lazbaphilipp/ADS_HW/README.md

# MIET RTD and PCB design homework project
 special thanks to [dee3mon](https://github.com/dee3mon) and [murenkov](https://github.com/murenkov)
