lazbaphilipp/ADS_HW/images/Altium-Components/not used/LNA_Schematic_View.pdf

NC 1

RFIN 7

GND 8

NC | 3
NC | 5

GND 14

NC | 13 GND 6
NC | 12

GND 16

RFOUT | 15
NC | 11

VE 4

NC 10

VDD 2

NC 9 GND 17

DA?

PMA-183PLN+
