lazbaphilipp/ADS_HW/images/Altium-Components/not used/PD_Schematic_View.pdf

GND

7

Vcc

1

OUT

2 RFin

6

FLTR

3

EN

8

GND

4 GND

5

GND

9

DA?

LTC5597
