lazbaphilipp/ADS_HW/images/Altium-Components/not used/PM_Schematic_View.pdf

OUT

1

SENSE

2

GND

6

SHDN

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
LT1763-
