lazbaphilipp/ADS_HW/images/Altium-Components/not used/Atmega/MC_Schematic_View.pdf

VCC | 3 GND 4
AVCC | 16
AREF | 17 GND 18

PC[6] ( RESET/PCINT14) 25

PD[0] (RXD/PCINT16) 26

PD[1] (TXD/PCINT17) 27

PD[3] (PCINT19/OC2B/INT1) 1

PD[2] (INT0/PCINT18) 28

PD[4] (PCINT20/XCK/T0) 2

PD[5] (PCINT21/OC0B/T1) 7

PD[6] (PCINT22/OC0A/AIN0) 8

PD[7] (PCINT23/AIN1) 9

(PCINT0/CLKO/ICP1) PB[0] | 10
(PCINT1/OC1A) PB[1] | 11
(PCINT2/SS/OC1B) PB[2] | 12
(PCINT3/OC2A/MOSI) PB[3] | 13
(PCINT6/XTAL1/TOSC1) PB[6] | 5
(PCINT7/XTAL2/TOSC2) PB[7] | 6
(PCINT4/MISO) PB[4] | 14
(SCK/PCINT5) PB[5] | 15

DD?A

PC[1] (ADC1/PCINT9) 20

PC[2] (ADC2/PCINT10) 21

PC[3] (ADC3/PCINT11) 22

PC[4] (ADC4/SDA/PCINT12) 23

PC[5] ADC5/SCL/PCINT13) 24

PC[0] (ADC0/PCINT8) 19

DD?B
