lazbaphilipp/ADS_HW/include/coursework/applications.tex

\includepdf[pages=-, fitpaper,addtotoc={1,chapter,0,Приложение А. МПСУ.464342.21-005СБ ,chap:appA}]{images/Documentation/MPSU.464342.21-005SB.pdf}

\includepdf[pages=-, fitpaper,addtotoc={1,chapter,0,Приложение Б. МПСУ.687254.21-005СБ ,chap:appB}]{images/Documentation/MPSU.687254.21-005SB.pdf}

\includepdf[pages=-, fitpaper,addtotoc={1,chapter,0,Приложение В. МПСУ.687254.21-005Д1 ,chap:appC}]{images/Documentation/MPSU.687254.21-005D1.pdf}

\includepdf[pages=-, fitpaper,addtotoc={1,chapter,0,Приложение Г. МПСУ.464342.21-005ЭЗ ,chap:appD}]{images/Documentation/MPSU.464342.21-005E3.pdf}

\includepdf[pages=-, fitpaper]{images/Documentation/MPSU.464342.21-005E3_2.pdf}

\includepdf[pages=-, fitpaper,addtotoc={1,chapter,0,Приложение Д. МПСУ.464342.21-005ПЭ3 ,chap:appE}]{images/Documentation/MPSU.464342.21-005PE3.pdf}

\includepdf[pages=-, fitpaper,addtotoc={1,chapter,0,Приложение Е. МПСУ.464342.21-005ВП ,chap:appF}]{images/Documentation/MPSU.464342.21-005VP.pdf}

\includepdf[pages=-, fitpaper,addtotoc={1,chapter,0,Приложение Ж. МПСУ.464342.21-005 ,chap:appG}]{images/Documentation/MPSU.464342.21-005.pdf}

\includepdf[pages=-, fitpaper,addtotoc={1,chapter,0,Приложение З. МПСУ.687254.21-005 ,chap:appH}]{images/Documentation/MPSU.687254.21-005.pdf}

\includepdf[pages=-, fitpaper,addtotoc={1,chapter,0,Приложение И. МПСУ.30117.21-005Р ,chap:appI}]{images/Documentation/MPSU.30117.21-005R.pdf}
