lazbaphilipp/ADS_HW/include/coursework/system_modeling.tex

\chapter{Системное моделирование} \label{chap:system_modeling}

Пользуясь спроектированными ранее элементами составим общую схему приёмной
ячейки по примеру структурной схемы из технического задания (Рис.\ref{fig:SystemSch})

\begin{figure}[H]
	\centering
	
	\caption{Схема проектируемой приёмной ячейки}%
	\label{fig:SystemSch}
\end{figure}

\begin{figure}[H]
	\centering
	
	\caption{Результаты моделирования}%
	\label{fig:SystemResponse}
\end{figure}

\begin{figure}[H]
	\centering
	
	\caption{Шумовые характеристики}%
	\label{fig:SystemNF}
\end{figure}

Данная модель соответствует выданному ТЗ и может быть отправлена на следующий 
этап проектирования.
