lazbaphilipp/ADS_HW/include/coursework/title.tex

\thispagestyle{empty}
\setcounter{page}{0}

\begin{center}
    Министерство науки  и высшего образования Российской Федерации

    \vspace{1ex}

    Федеральное государственное автономное образовательное учреждение высшего образования

    \textbf{НАЦИОНАЛЬНЫЙ ИССЛЕДОВАТЕЛЬСКИЙ УНИВЕРСИТЕТ <<МОСКОВСКИЙ ИНСТИТУТ ЭЛЕКТРОННОЙ ТЕХНИКИ>>}

    \vspace{1ex}

    Институт микроприборов и систем управления имени Л.Н. Преснухина
\end{center}

\vspace{13ex}

\begin{center}
    \textbf{К\,У\,Р\,С\,О\,В\,А\,Я\,\, Р\,А\,Б\,О\,Т\,А}
    \vspace{1ex}

    по курсам

    \textbf{\textit{<<Приёмо-передающие устройства>>}}
    
    \textbf{\textit{<<Проектироание печатных плат>>}}
    
    Вариант 5.6
    
    \textit{Приемная ячейка усиления и фильтрации с детектированием мощности}

\end{center}

\vspace{20ex}

\begin{flushright}
    \noindent
    Выполнил: \textit{Лазба Филипп Борисович} \\
    \textit{студент группы РТ-43} \\
    Руководитель: \textit{Приходько Дмитрий Владимирович}
\end{flushright}

\vfill

\begin{center}
    Москва

    2021
\end{center}

\newpage
