lazbaphilipp/ADS_HW/images/Altium-Mechanical/BoardCase.pdf

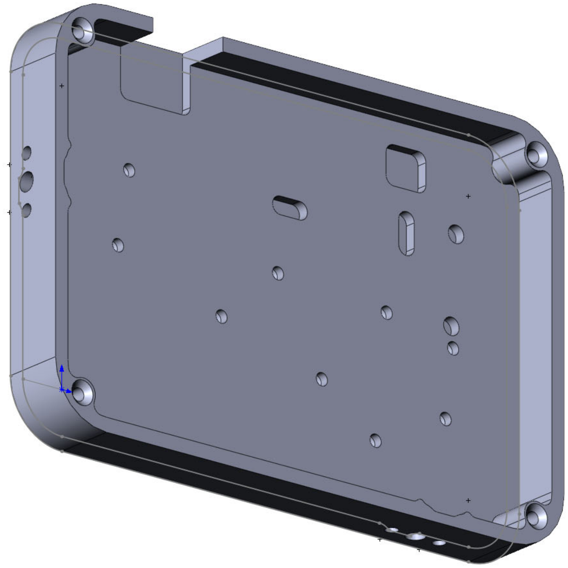
[picture p1: page 1]
