lazbaphilipp/ADS_HW/images/Altium-Mechanical/BoardCup.pdf

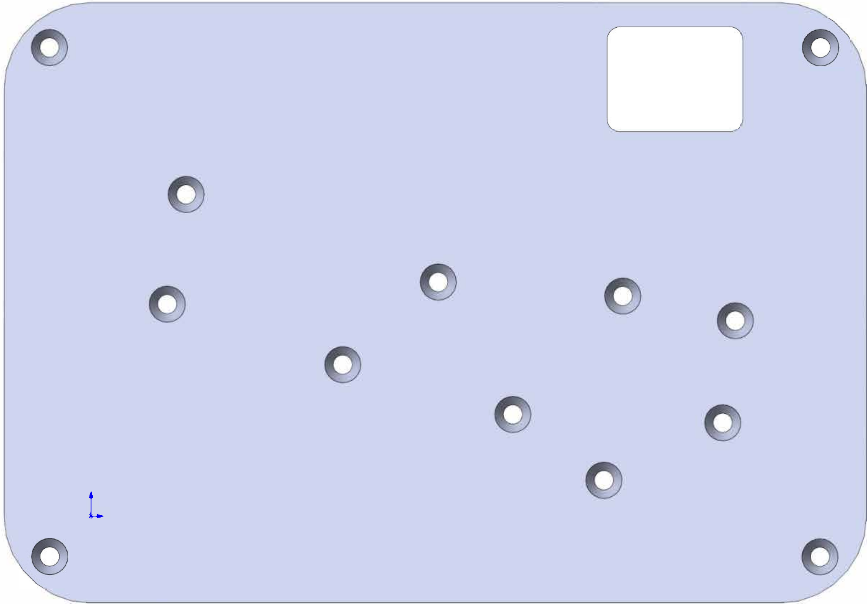
[picture p2: page 1]

L
