lazbaphilipp/ADS_HW/images/Altium-Mechanical/CellsCutout.pdf

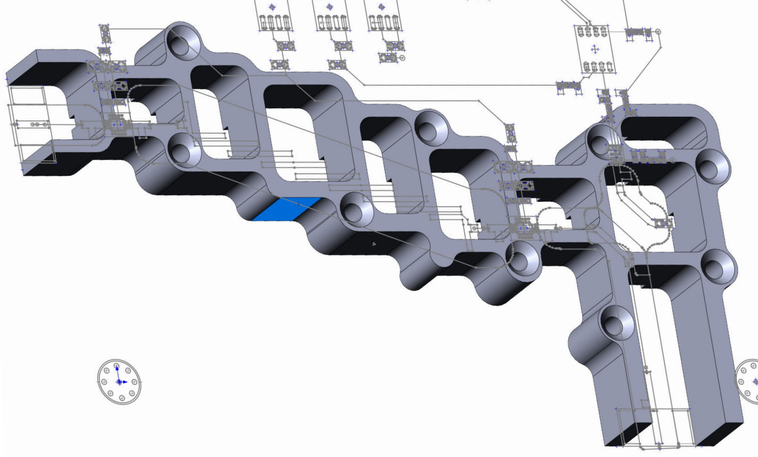
[picture p3: page 1]
