lazbaphilipp/ADS_HW/images/Altium-Mechanical/ShieldedBoardRelease.pdf

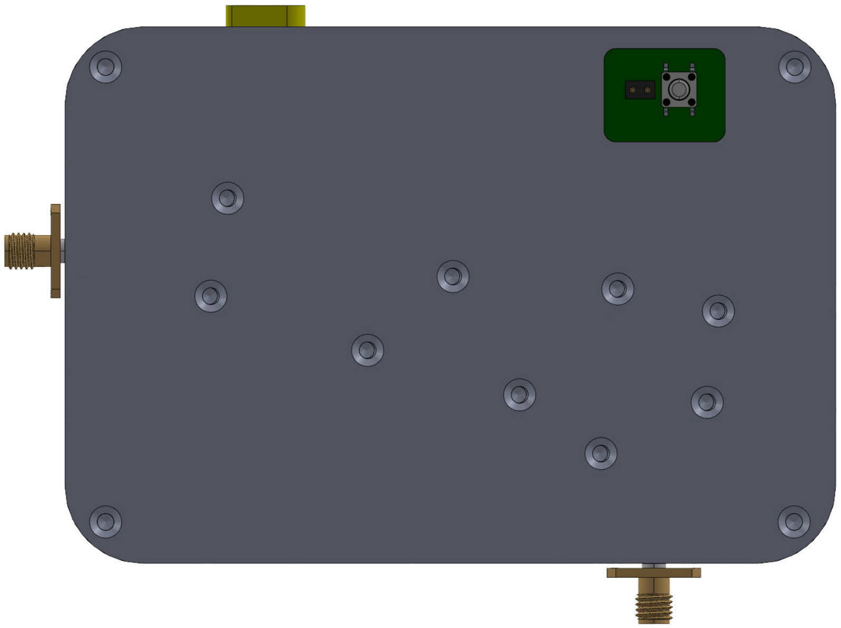
[picture p4: page 1]
