lazbaphilipp/ADS_HW/images/Altium-PCB/4LayerPWRL.pdf

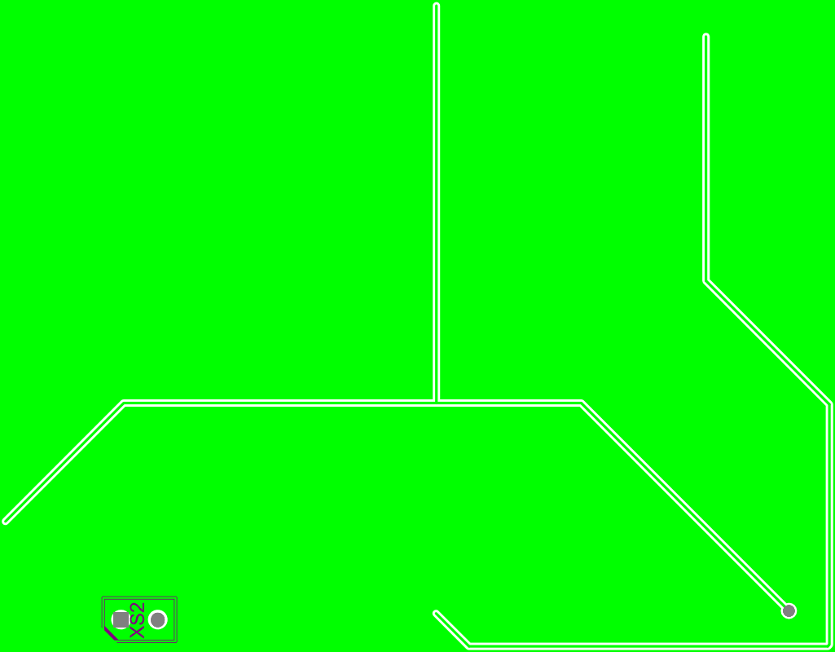
[picture p5: figure]
