lazbaphilipp/ADS_HW/images/Documentation/MPSU.464342.21-005PP.pdf

Формат
Кол.

А4,

Подп. Дата

Взам. инв. №Инв. № дуб Подп. и дата

Примечание

Перв. примен.

Зона
Поз.
Обозначение | Наименование

1

Справ. №

3 | МПСУ.464342.21-005Д1 | Данные проектирования
| МПСУ.464342.21-005Т5М | Данные конструирования
4
5
6 | | Материалы
7
8 | | Rogers RO4350B 0.508мм
9 | | (фольга 0.18мм)
10
11

МПСУ.464342.21-005СБ
2

12

№ докум.

| | | | МПСУ.464342.21-001
| | Разраб. | Лазба | | и фильтрации с детектированием мощности | Лит. | Лист 1 Приемная ячейка усиления | Листов
Пров. | Приходько | | | | | | | 2
ЗамДир | Лялин
Н. контр
Утв.

Изм.Лист

Подп. и дата Инв. № подл

Документация

Сборочный чертеж

Копировал | Формат А4
