lazbaphilipp/ADS_HW/images/system_modeling/SystemNF.pdf

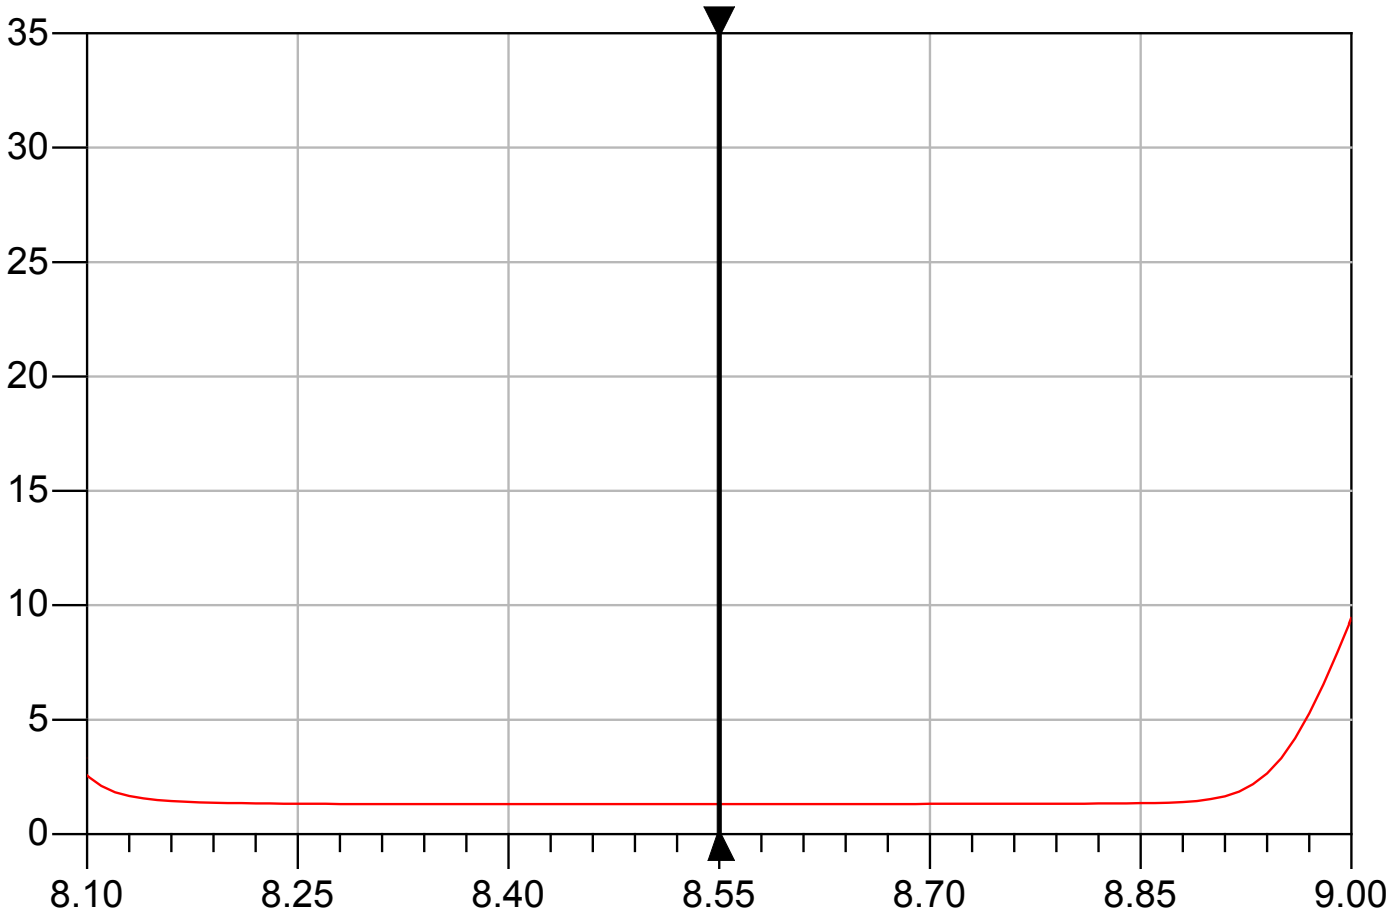
[picture p6: figure]

### freq, GHz

### NFmin

m4

m4

## freq= NFmin=1.312

## 8.550GHz
