lazbaphilipp/ADS_HW/Project/Components/Power Detector/MC ATmega328 (nu)/pinout.xlsx

PinDes | PinName | Type | Bank
1 | PD[3] (PCINT19/OC2B/INT1) | I/O | Bank=PD | V
2 | PD[4] (PCINT20/XCK/T0) | I/O | Bank=PD | C
3 | VCC |  | Bank= | F
4 | GND |  | Bank= | D
5 | PB[6] (PCINT6/XTAL1/TOSC1) | I/O | Bank=PB
6 | PB[7] (PCINT7/XTAL2/TOSC2) | I/O | Bank=PB
7 | PD[5] (PCINT21/OC0B/T1) | I/O | Bank=PD
8 | PD[6] (PCINT22/OC0A/AIN0) | I/O | Bank=PD
9 | PD[7] (PCINT23/AIN1) | I/O | Bank=PD
10 | PB[0] (PCINT0/CLKO/ICP1) | I/O | Bank=PB
11 | PB[1] (PCINT1/OC1A) | I/O | Bank=PB
12 | PB[2] (PCINT2/SS/OC1B) | I/O | Bank=PB
13 | PB[3] (PCINT3/OC2A/MOSI) | I/O | Bank=PB
14 | PB[4] (PCINT4/MISO) | I/O | Bank=PB
15 | PB[5] (SCK/PCINT5) | I/O | Bank=PB
16 | AVCC |  | Bank=
17 | AREF |  | Bank=
18 | GND |  | Bank=
19 | PC[0] (ADC0/PCINT8) | I/O | Bank=PC
20 | PC[1] (ADC1/PCINT9) | I/O | Bank=PC
21 | PC[2] (ADC2/PCINT10) | I/O | Bank=PC
22 | PC[3] (ADC3/PCINT11) | I/O | Bank=PC
23 | PC[4] (ADC4/SDA/PCINT12) | I/O | Bank=PC
24 | PC[5] ADC5/SCL/PCINT13) | I/O | Bank=PC
25 | PC[6] ( R\E\S\E\T\/PCINT14) | I/O | Bank=PC
26 | PD[0] (RXD/PCINT16) | I/O | Bank=PD
27 | PD[1] (TXD/PCINT17) | I/O | Bank=PD
28 | PD[2] (INT0/PCINT18) | I/O | Bank=PD
