lazbaphilipp/ADS_HW/images/Altium-Draftsman/CAMtastic.png

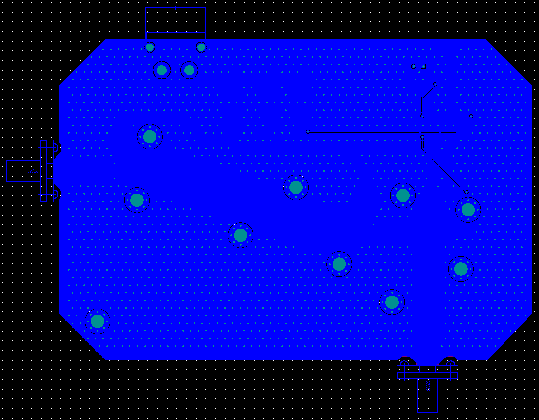
images/Altium-Draftsman/CAMtastic.png
