lazbaphilipp/ADS_HW/images/Altium-Mechanical/BoardNoCup.png

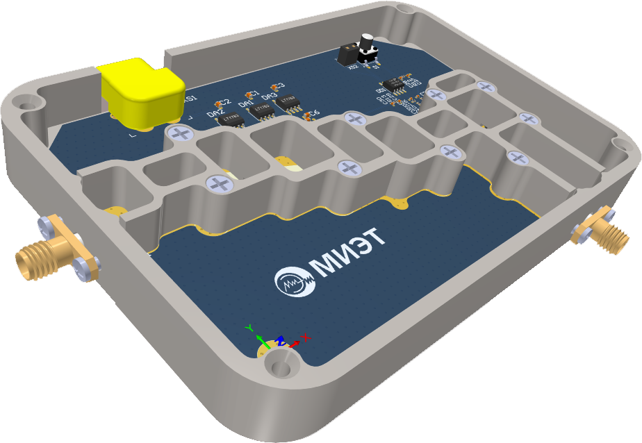
images/Altium-Mechanical/BoardNoCup.png
