lazbaphilipp/ADS_HW/images/Altium-Mechanical/BoardSolidDraft.png

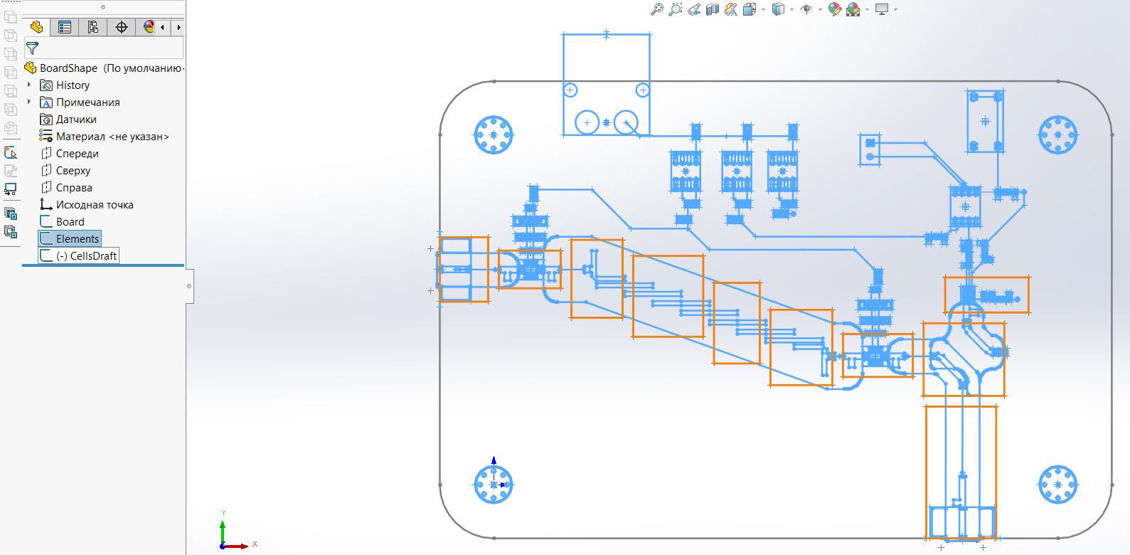
images/Altium-Mechanical/BoardSolidDraft.png
