lazbaphilipp/ADS_HW/images/Altium-Mechanical/BoardWithCup.png

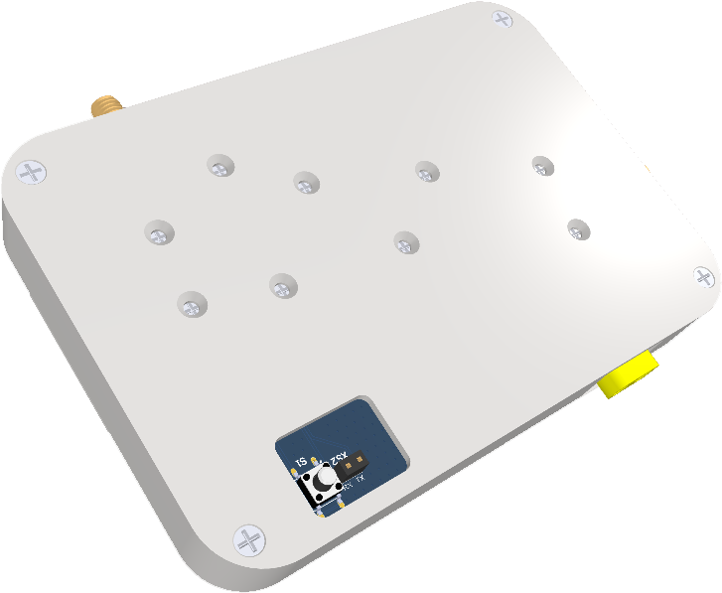
images/Altium-Mechanical/BoardWithCup.png
