lazbaphilipp/ADS_HW/images/Altium-Mechanical/BordShape.png

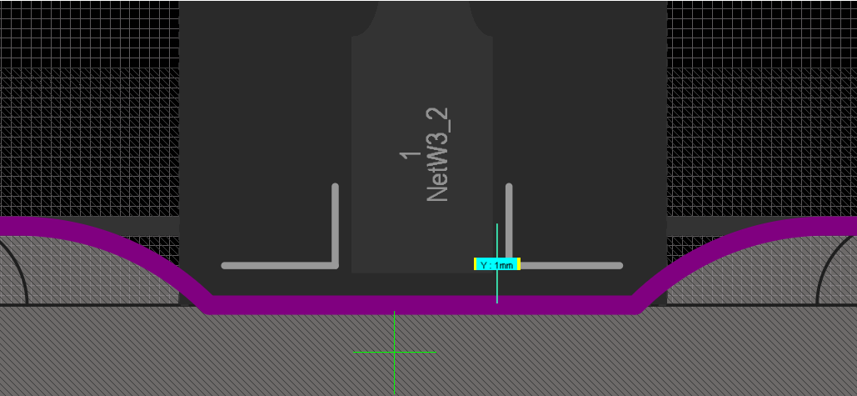
images/Altium-Mechanical/BordShape.png
