lazbaphilipp/ADS_HW/images/Altium-Mechanical/CellsDraft.png

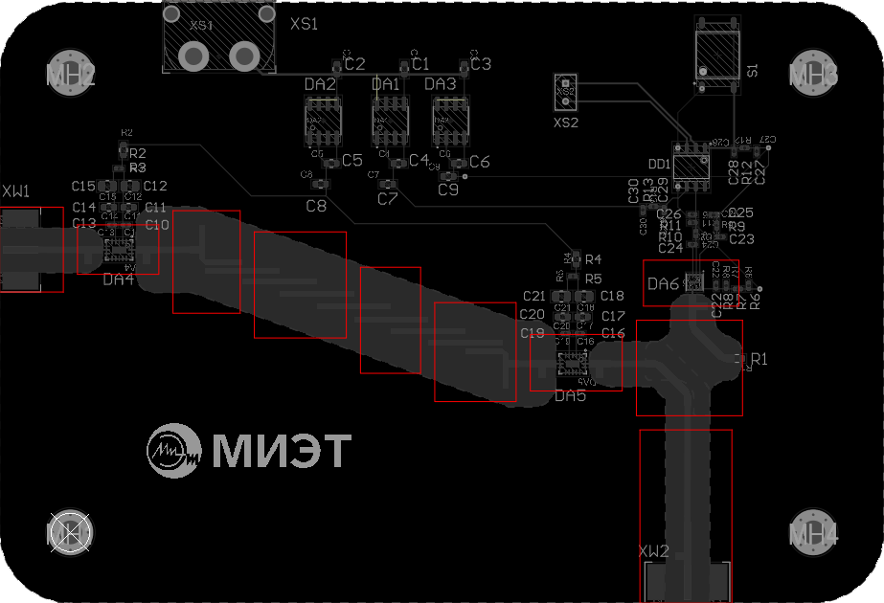
images/Altium-Mechanical/CellsDraft.png
