lazbaphilipp/ADS_HW/images/Altium-Mechanical/OpenBoardRelease.png

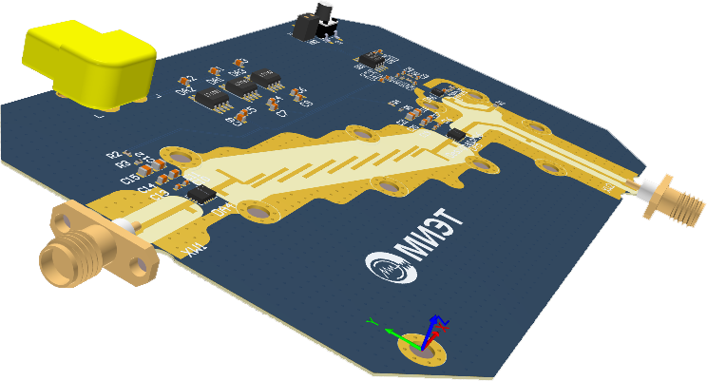
images/Altium-Mechanical/OpenBoardRelease.png
