lazbaphilipp/ADS_HW/images/Altium-Mechanical/ShieldedBoardAltiumRelease.png

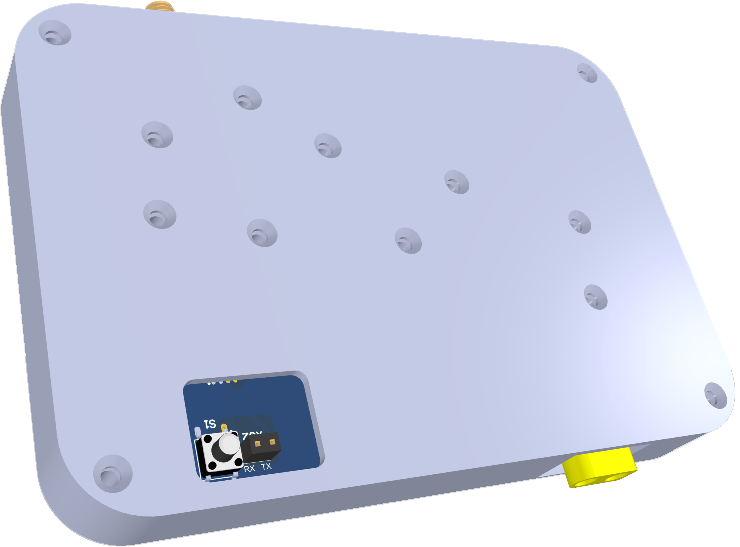
images/Altium-Mechanical/ShieldedBoardAltiumRelease.png
