lazbaphilipp/ADS_HW/images/Altium-PCB/2Layer0.png

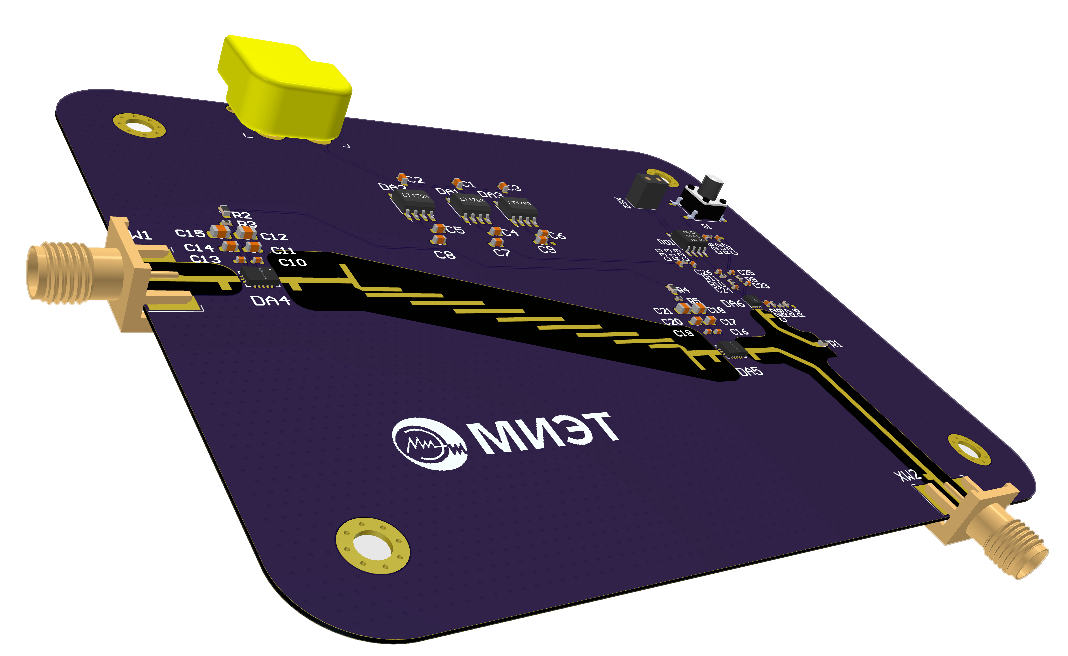
images/Altium-PCB/2Layer0.png
