lazbaphilipp/ADS_HW/images/Altium-PCB/2Layer1.png

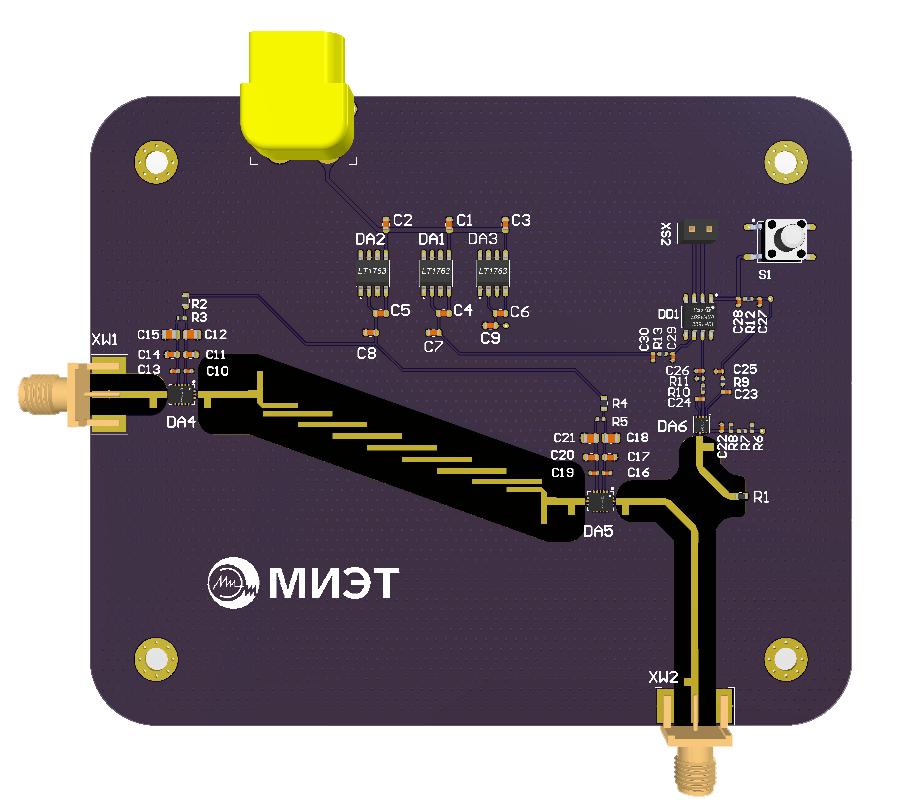
images/Altium-PCB/2Layer1.png
