lazbaphilipp/ADS_HW/images/Altium-PCB/2LayerBL.png

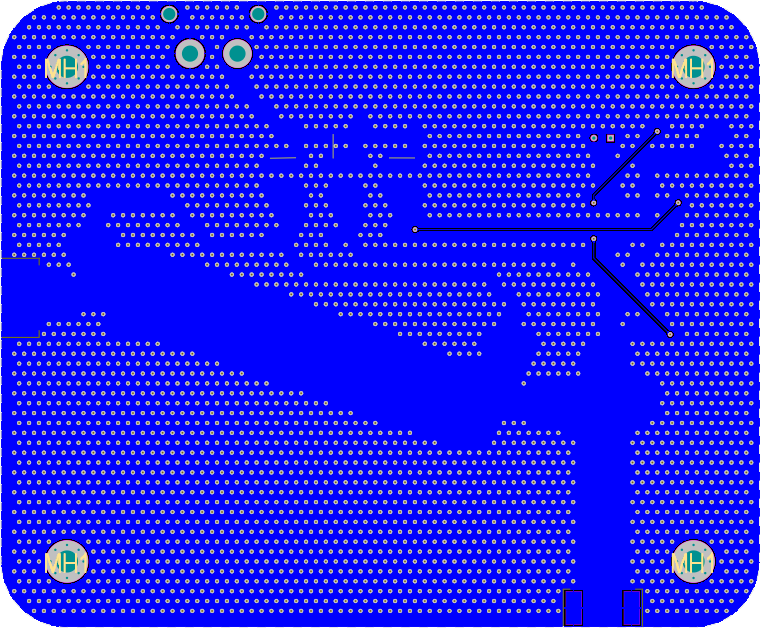
images/Altium-PCB/2LayerBL.png
