lazbaphilipp/ADS_HW/images/Altium-PCB/2LayerStackup.png

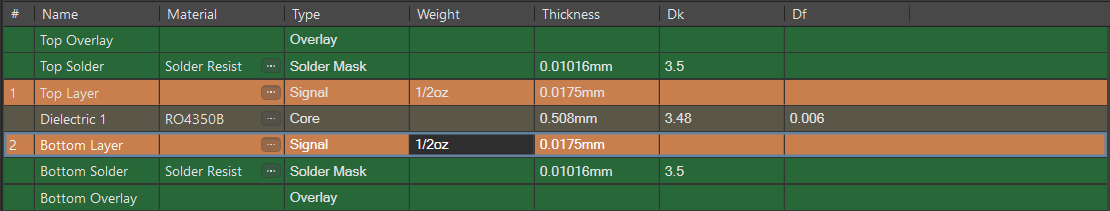
images/Altium-PCB/2LayerStackup.png
