lazbaphilipp/ADS_HW/images/Altium-PCB/2LayerTL.png

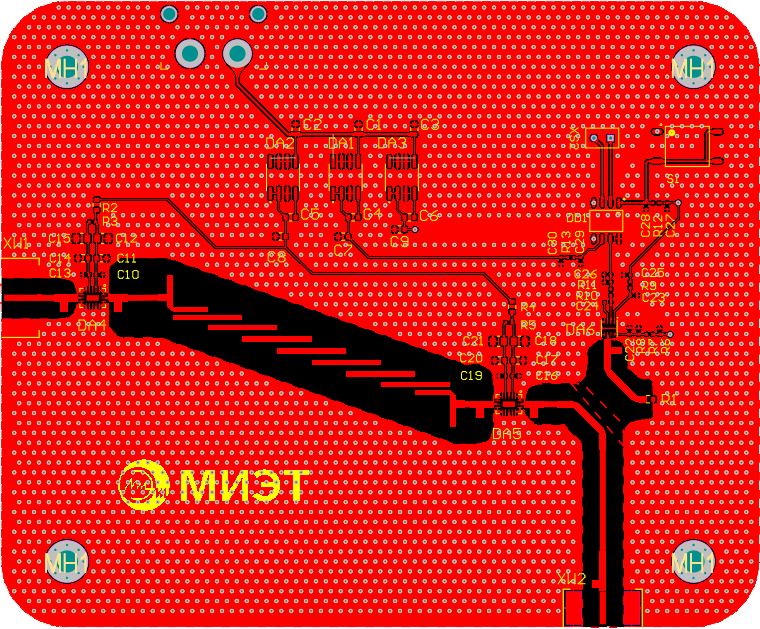
images/Altium-PCB/2LayerTL.png
