lazbaphilipp/ADS_HW/images/Altium-PCB/4Layer0.png

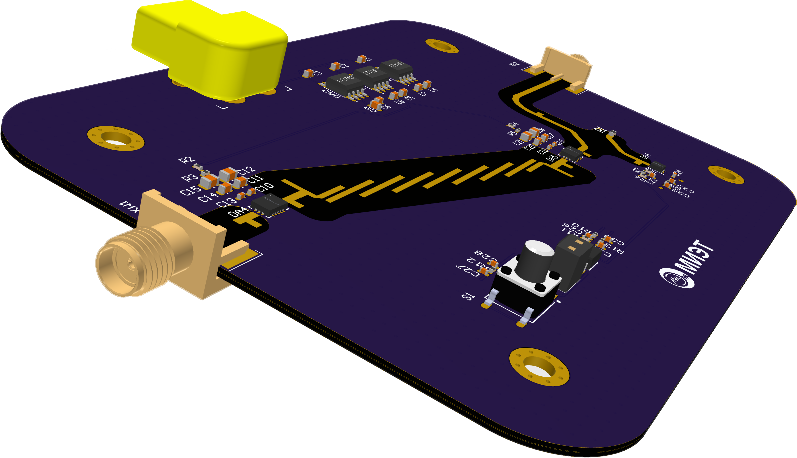
images/Altium-PCB/4Layer0.png
