lazbaphilipp/ADS_HW/images/Altium-PCB/4Layer1.png

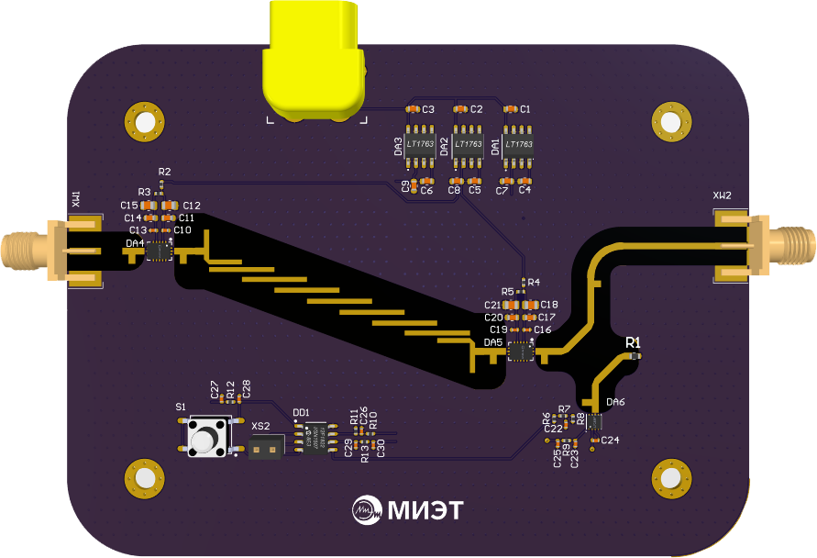
images/Altium-PCB/4Layer1.png
