lazbaphilipp/ADS_HW/images/Altium-PCB/4LayerBL.png

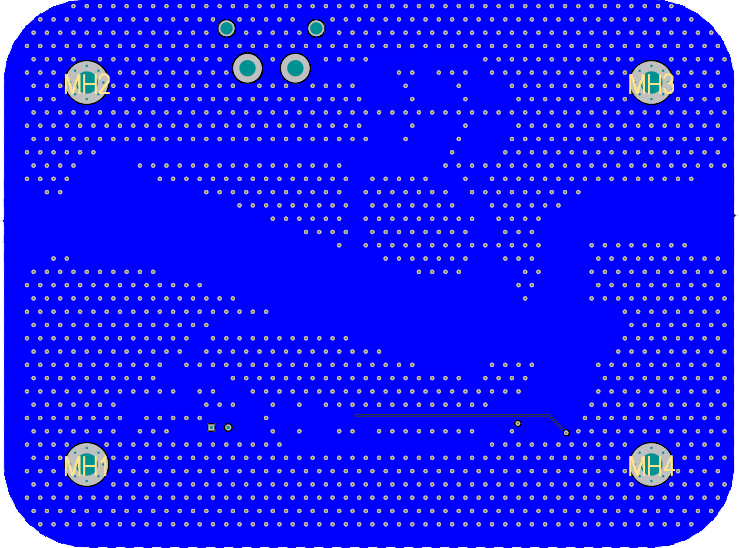
images/Altium-PCB/4LayerBL.png
