lazbaphilipp/ADS_HW/images/Altium-PCB/4LayerPWRL.png

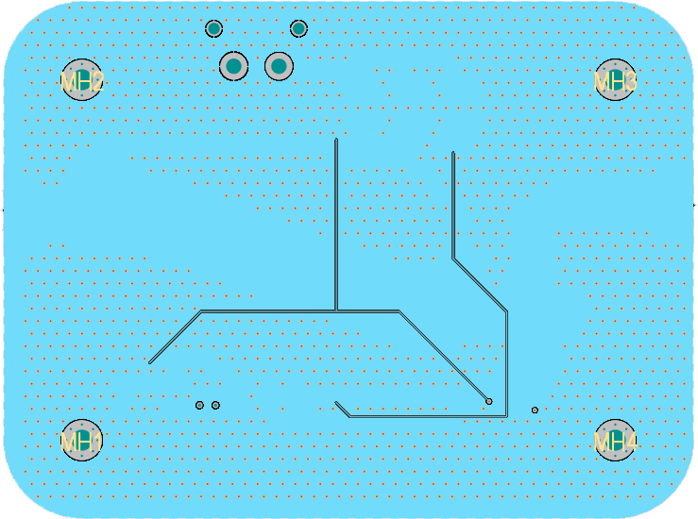
images/Altium-PCB/4LayerPWRL.png
