lazbaphilipp/ADS_HW/images/Altium-PCB/4LayerRF.png

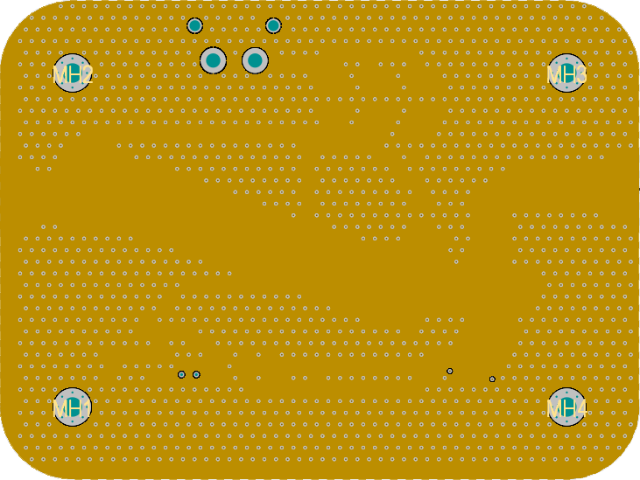
images/Altium-PCB/4LayerRF.png
