lazbaphilipp/ADS_HW/images/Altium-PCB/4LayerStackup.png

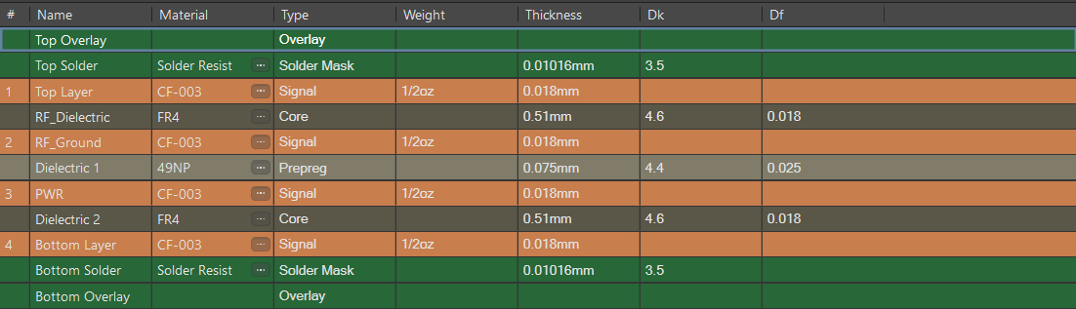
images/Altium-PCB/4LayerStackup.png
