lazbaphilipp/ADS_HW/images/Altium-PCB/4LayerTL.png

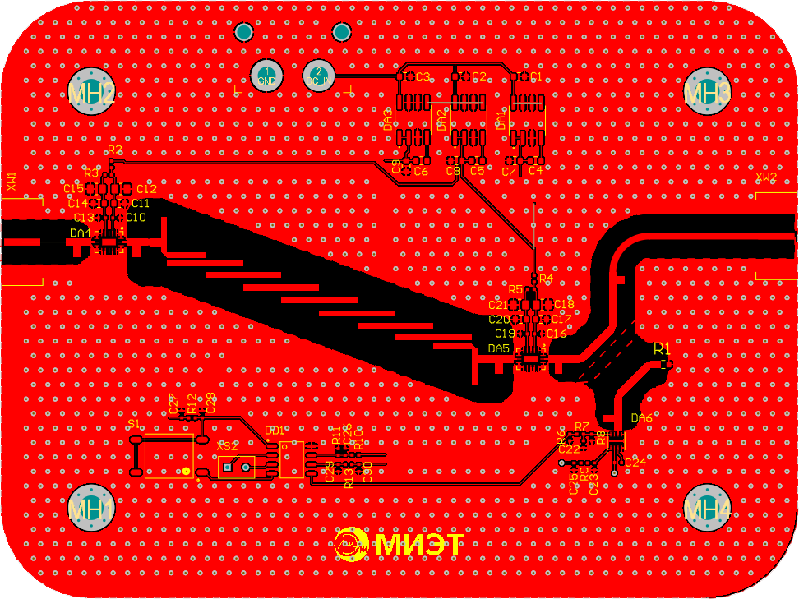
images/Altium-PCB/4LayerTL.png
