lazbaphilipp/ADS_HW/images/Altium-PCB/DraftPolyCut.png

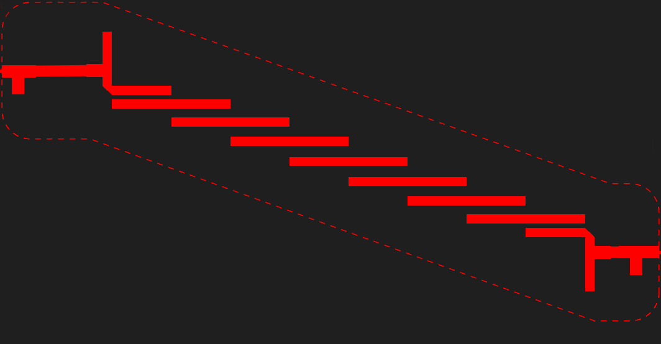
images/Altium-PCB/DraftPolyCut.png
