lazbaphilipp/ADS_HW/images/component_search/PMA-NFvsFvsV.pdf

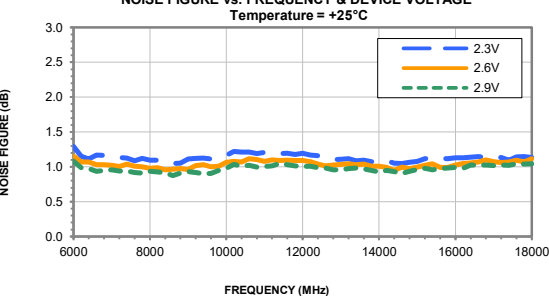
[picture p28: figure]
NOISE FIGURE (dB); FREQUENCY (MHz); Temperature = +25°C

NOISE FIGURE vs. FREQUENCY & DEVICE VOLTAGE
