lazbaphilipp/ADS_HW/images/parts_design/LTC_Sch.pdf

Ref1

MSub | S-PARAMETERS

VSWR

StabFact

1 | 21 | 1

StabFact

VSWR
MSUB

S_Param

S1P

TermG

LTC_Adap

StabFact1

VSWR1
MSub1

SP1

SNP1

TermG1

X2

StabFact1=stab_fact(S)

VSWR1=vswr(S11)

TanD=0.002

T=17 um

Er=3.55

H=0.508 mm

Step=0.01 GHz

Stop=10.0 GHz

Start=7 GHz

Z=50 Ohm

Num=1

W50=1.1 mm
WT=1.1 mm
WS=1.1 mm
LS=1.6 mm
LT=1.1 mm
Linline=0.7 mm
Winline=0.3 mm
