lazbaphilipp/ADS_HW/Project/КД/МПСУ.464342.21-005ВП.xls

Sheet: МПСУ.464342.21-001. Первый лист
Перв. примен. | МПСУ.464342.21-001 | № строки | Наименование | Код продукции | Обозначение документа на поставки | Поставщик |  |  |  | Куда входит (обозначение) |  |  |  | Количество |  |  |  |  |  | Примечание
 |  |  |  |  |  |  |  |  |  |  |  |  |  | На изделие | В компл-екты | На регу-лир. |  | Всего
 |  |  | Прочие изделия
 |  |  | Конденсаторы
 |  | 1 | 0.33 uF± %100805 |  |  |  |  |  |  |  |  |  |  | 4
 |  | 2 | 1 uF± %1010 V0603X5R |  |  |  |  |  |  |  |  |  |  | 4
Справ. № |  | 3 | 1 uF± 10 %16 V0603X7R |  |  |  |  |  |  |  |  |  |  | 3
 |  | 4 | 1 uF0402 |  |  |  |  |  |  |  |  |  |  | 1
 |  | 5 | 10 nF0402 |  |  |  |  |  |  |  |  |  |  | 1
 |  | 6 | 10 pF± 10 %16 V0603X7R |  |  |  |  |  |  |  |  |  |  | 3
 |  | 7 | 10 pF0402 |  |  |  |  |  |  |  |  |  |  | 1
 |  | 8 | 10 uF± 10 %16 V0603X7R |  |  |  |  |  |  |  |  |  |  | 3
 |  | 9 | 100 nF0402 |  |  |  |  |  |  |  |  |  |  | 3
 |  | 10 | 100 pF± %100402 |  |  |  |  |  |  |  |  |  |  | 4
 |  | 11 | OPT0402 |  |  |  |  |  |  |  |  |  |  | 3
 |  |  | Микросхемы
Подп. и дата |  | 12 | Analog Devices |  |  | Analog Devices |  |  |  |  |  |  |  | 3
 |  | 13 | LTC5597Analog Devices |  |  | Analog Devices |  |  |  |  |  |  |  | 1
 |  | 14 | PIC12F1822-I/SN |  |  |  |  |  |  |  |  |  |  | 1
 |  | 15 | PMA-183PLN+Mini-Circuits |  |  | Mini-Circuits |  |  |  |  |  |  |  | 2
Инв. № дубл.
 |  |  | Резисторы
 |  | 16 | 1 Ohm± 5%25 V63 mW0402 |  |  |  |  |  |  |  |  |  |  | 2
Взам. инв. № |  | 17 | 1 Ohm0402 |  |  |  |  |  |  |  |  |  |  | 1
 |  | 18 | 10 Ohm± 5%25V63 mW0402 |  |  |  |  |  |  |  |  |  |  | 2
Подп. и дата
 |  |  |  |  |  |  |  |  |  |  |  |  | МПСУ.464342.21-001 ВП
 |  |  |  |  |  |  | Изм. | Лист | № докум. |  | Подп. | Дата
Инв. № подл. |  |  |  |  |  |  | Разраб. |  | Лазба |  |  |  | Приемная ячейка усиления и фильтрации с детектированием мощности |  |  |  | Лит. |  | Лист |  | Листов
 |  |  |  |  |  |  | Пров. |  | Приходько |  |  |  |  |  |  |  |  |  | 1 |  | 2
 |  |  |  |  |  |  | ЗамДир |  | Лялин
 |  |  |  |  |  |  | Н. контр.
 |  |  |  |  |  |  | Утв. |  |  |  |  |  | Ведомость покупных изделий

Sheet: 2
 |  | № строки | Наименование | Код продукции | Обозначение документа на поставку | Поставщик |  |  |  | Куда входит (обозначение) |  |  |  | Количество |  |  |  | Примечание
-00 |  |  |  |  |  |  |  |  |  |  |  |  |  | На изделие | В комп-екты | На ре-гулир. | Всего
 |  |  | Резисторы
 |  | 19 | 100 Ohm± 5%25 V63 mW0402 |  |  |  |  |  |  |  |  |  |  | 1
 |  | 20 | 180 Ohm± 5%25V63 mW0402 |  |  |  |  |  |  |  |  |  |  | 2
 |  | 21 | 2 kOhm± 5%25 V63 mW0402 |  |  |  |  |  |  |  |  |  |  | 1
 |  | 22 | 3 kOhm± 5%25 V63 mW0402 |  |  |  |  |  |  |  |  |  |  | 1
 |  | 23 | 50 Ohm50 V5 W0603 |  |  |  |  |  |  |  |  |  |  | 1
 |  | 24 | OPT± 5%25 V63 mW0402 |  |  |  |  |  |  |  |  |  |  | 2
 |  |  | Переключатели
 |  | 25 | L-KLS7-TS6604-4.3-180-BKLS |  |  | KLS electronic co ltd |  |  |  |  |  |  |  | 1
 |  |  | electronic co ltd
 |  |  | Розетки
 |  | 26 | PBD-2 2x1 |  |  |  |  |  |  |  |  |  |  | 1
 |  | 27 | XT-60-PW-F |  |  |  |  |  |  |  |  |  |  | 1
 | Подп. и дата |  | Соединители
 |  |  | выскочастотные
 |  | 28 | SMA862A1-0000 |  |  |  |  |  |  |  |  |  |  | 2
 | Инв. № дубл.
 | Взам. инв. №
 | Подп. и дата
 | Инв. № подл.
 |  |  |  |  |  |  |  |  |  |  |  |  | МПСУ.464342.21-001 ВП |  |  |  |  |  | Лист
 |  |  |  |  |  |  |  |  |  |  |  |  |  |  |  |  |  |  | 2
 |  |  |  |  |  |  | Изм. | Лист | № докум. |  | Подп. | Дата
