lazbaphilipp/ADS_HW/Project/КД/МПСУ.464342.21-005ПЭ3.xls

Sheet: МПСУ.464342.21-001. Первый лист
Перв. примен. | МПСУ.464342.21-001 | Поз. обозна-чение |  |  | Наименование |  |  |  | Кол. |  | Примечание
 |  |  |  |  | Конденсаторы
 |  | C1-C3 |  |  | 1 uF± 10 %16 V0603X7R |  |  |  | 3
 |  | C4-C6 |  |  | 10 pF± 10 %16 V0603X7R |  |  |  | 3
Справ. № |  | C7-C9 |  |  | 10 uF± 10 %16 V0603X7R |  |  |  | 3
 |  | C10 |  |  | 100 pF± %100402 |  |  |  | 1
 |  | C11 |  |  | 1 uF± %1010 V0603X5R |  |  |  | 1
 |  | C12 |  |  | 0.33 uF± %100805 |  |  |  | 1
 |  | C13 |  |  | 100 pF± %100402 |  |  |  | 1
 |  | C14 |  |  | 1 uF± %1010 V0603X5R |  |  |  | 1
 |  | C15 |  |  | 0.33 uF± %100805 |  |  |  | 1
 |  | C16 |  |  | 100 pF± %100402 |  |  |  | 1
 |  | C17 |  |  | 1 uF± %1010 V0603X5R |  |  |  | 1
 |  | C18 |  |  | 0.33 uF± %100805 |  |  |  | 1
Подп. и дата |  | C19 |  |  | 100 pF± %100402 |  |  |  | 1
 |  | C20 |  |  | 1 uF± %1010 V0603X5R |  |  |  | 1
 |  | C21 |  |  | 0.33 uF± %100805 |  |  |  | 1
 |  | C22 |  |  | 10 pF0402 |  |  |  | 1
Инв. № дубл. |  | C23 |  |  | OPT0402 |  |  |  | 1
 |  | C24 |  |  | 10 nF0402 |  |  |  | 1
 |  | C25 |  |  | 100 nF0402 |  |  |  | 1
Взам. инв.№ |  | C26 |  |  | 1 uF0402 |  |  |  | 1
 |  | C27 |  |  | 100 nF0402 |  |  |  | 1
Подп. и дата
 |  |  |  |  |  |  |  | МПСУ.464342.21-001ПЭ3
 |  | Изм. | Лист | № докум. |  | Подп. | Дата
Инв. № подл. |  | Разраб. |  | Лазба |  |  |  | Приемная ячейка усиления и фильтрации с детектированием мощности |  | Лит. |  | Лист | Листов
 |  | Пров. |  | Приходько |  |  |  |  |  |  |  | 1 | 4
 |  | ЗамДир |  | Лялин
 |  | Н.контр
 |  | Утв. |  |  |  |  |  | Перечень элементов

Sheet: 2
 | Поз. обозна- чение |  |  | Наименование |  |  |  | Кол. | Примечание
 |  |  |  | Конденсаторы
 | C28,C29 |  |  | OPT0402 |  |  |  | 2
 | C30 |  |  | 100 nF0402 |  |  |  | 1
 |  |  |  | Микросхемы
 | DA1-DA3 |  |  | Analog Devices |  |  |  | 3
 | DA4,DA5 |  |  | PMA-183PLN+Mini-Circuits |  |  |  | 2
 | DA6 |  |  | LTC5597Analog Devices |  |  |  | 1
 | DD1 |  |  | PIC12F1822-I/SN |  |  |  | 1
 |  |  |  | Резисторы
Подп. и дата | R1 |  |  | 50 Ohm50 V5 W0603 |  |  |  | 1
 | R2 |  |  | 10 Ohm± 5%25V63 mW0402 |  |  |  | 1
 | R3 |  |  | 180 Ohm± 5%25V63 mW0402 |  |  |  | 1
 | R4 |  |  | 10 Ohm± 5%25V63 mW0402 |  |  |  | 1
Инв. № дубл. | R5 |  |  | 180 Ohm± 5%25V63 mW0402 |  |  |  | 1
 | R6 |  |  | OPT± 5%25 V63 mW0402 |  |  |  | 1
 | R7 |  |  | 2 kOhm± 5%25 V63 mW0402 |  |  |  | 1
Взам. инв.№ | R8 |  |  | 3 kOhm± 5%25 V63 mW0402 |  |  |  | 1
 | R9 |  |  | 1 Ohm± 5%25 V63 mW0402 |  |  |  | 1
 | R10 |  |  | 100 Ohm± 5%25 V63 mW0402 |  |  |  | 1
Подп. и дата | R11 |  |  | OPT± 5%25 V63 mW0402 |  |  |  | 1
 | R12 |  |  | 1 Ohm± 5%25 V63 mW0402 |  |  |  | 1
 | R13 |  |  | 1 Ohm0402 |  |  |  | 1
Инв. № подл.
 |  |  |  |  |  |  | МПСУ.464342.21-001ПЭ3 |  |  | Лист
 |  |  |  |  |  |  |  |  |  | 2
 | Изм. | Лист | № докум. |  | Подп. | Дата

Sheet: 3
 | Поз. обозна- чение |  |  | Наименование |  |  |  | Кол. | Примечание
 |  |  |  | Переключатели
 | S1 |  |  | L-KLS7-TS6604-4.3-180-BKLS electronic co ltd |  |  |  | 1
 |  |  |  | Розетки
 | XS1 |  |  | XT-60-PW-F |  |  |  | 1
 | XS2 |  |  | PBD-2 2x1 |  |  |  | 1
 |  |  |  | Соединители выскочастотные
 | XW1,XW2 |  |  | SMA862A1-0000 |  |  |  | 2
Подп. и дата
Инв. № дубл.
Взам. инв.№
Подп. и дата
Инв. № подл.
 |  |  |  |  |  |  | МПСУ.464342.21-001ПЭ3 |  |  | Лист
 |  |  |  |  |  |  |  |  |  | 3
 | Изм. | Лист | № докум. |  | Подп. | Дата

Sheet: Лист регистрации изменений.
 | Лист регистрации изменений
 | Изм. |  | Номера листов (страниц) |  |  |  |  |  |  |  | Всего листов (страниц) в докум. | № докум. | Входящий № сопроводи-тельного документа и дата | Под- пись | Дата
 |  |  | изменен- ных |  | заменен- ных |  | новых |  |  | аннули- рован- ных
Подп. и дата
Инв. № дубл.
Взам. инв.№
Подп. и дата
Инв. № подл.
 |  |  |  |  |  |  |  |  | МПСУ.464342.21-001ПЭ3 |  |  |  |  |  |  | Лист
 |  |  |  |  |  |  |  |  |  |  |  |  |  |  |  | 4
 | Изм. | Лист |  | № докум. |  | Подп. |  | Дата
