lazbaphilipp/ADS_HW/images/Altium-Components/PD_PCB_View.pdf

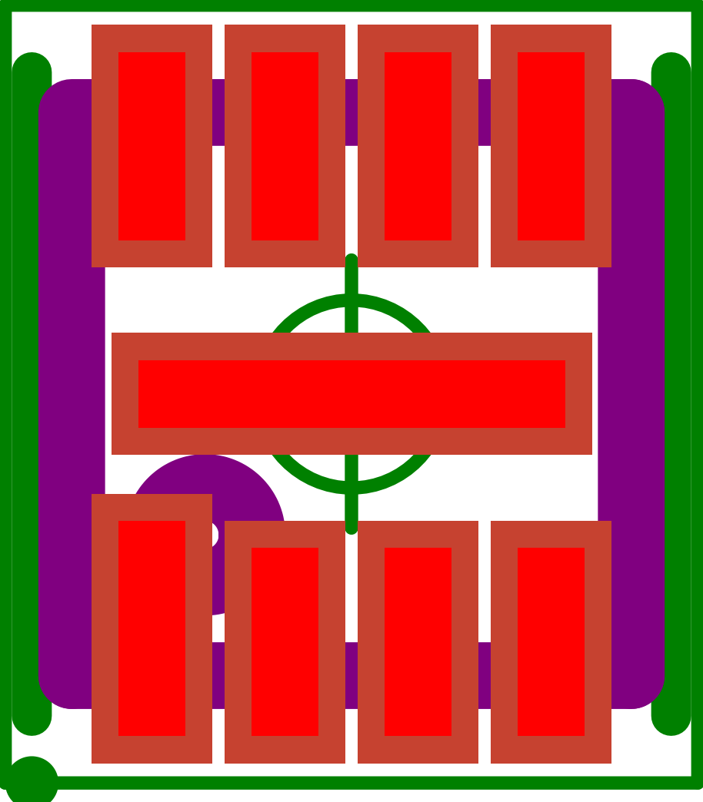
[picture p29: figure]
