lazbaphilipp/ADS_HW/images/component_search/LTC-Place.pdf

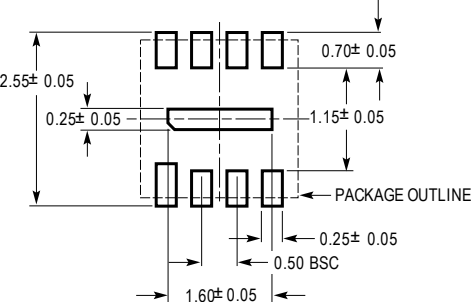
[picture p30: figure]
PACKAGE OUTLINE; 0.50 BSC
