lazbaphilipp/ADS_HW/images/parts_design/FilterLayout.pdf

Dis22

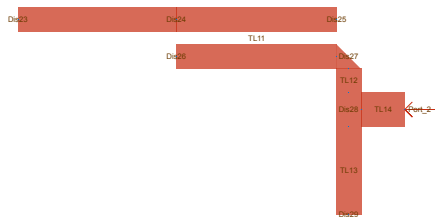
[picture p31: figure]
Dis29; Dis28; Dis27; Dis25; Dis26; Dis24; Dis23; Port_2

TL10

Dis21

Dis19

Dis20

TL9

Dis18

Dis16

Dis17

TL8

Dis15

Dis13

Dis14

TL7

Dis12

Dis10

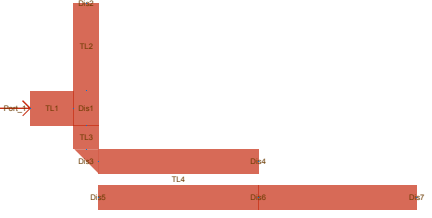
[picture p32: figure]
Dis7; Dis6; Dis4; Dis5; Dis3; Dis2; Dis1TL1; Port_1

Dis11

TL6

Dis9

Dis8

TL5
