lazbaphilipp/ADS_HW/images/parts_design/FilterSch.pdf

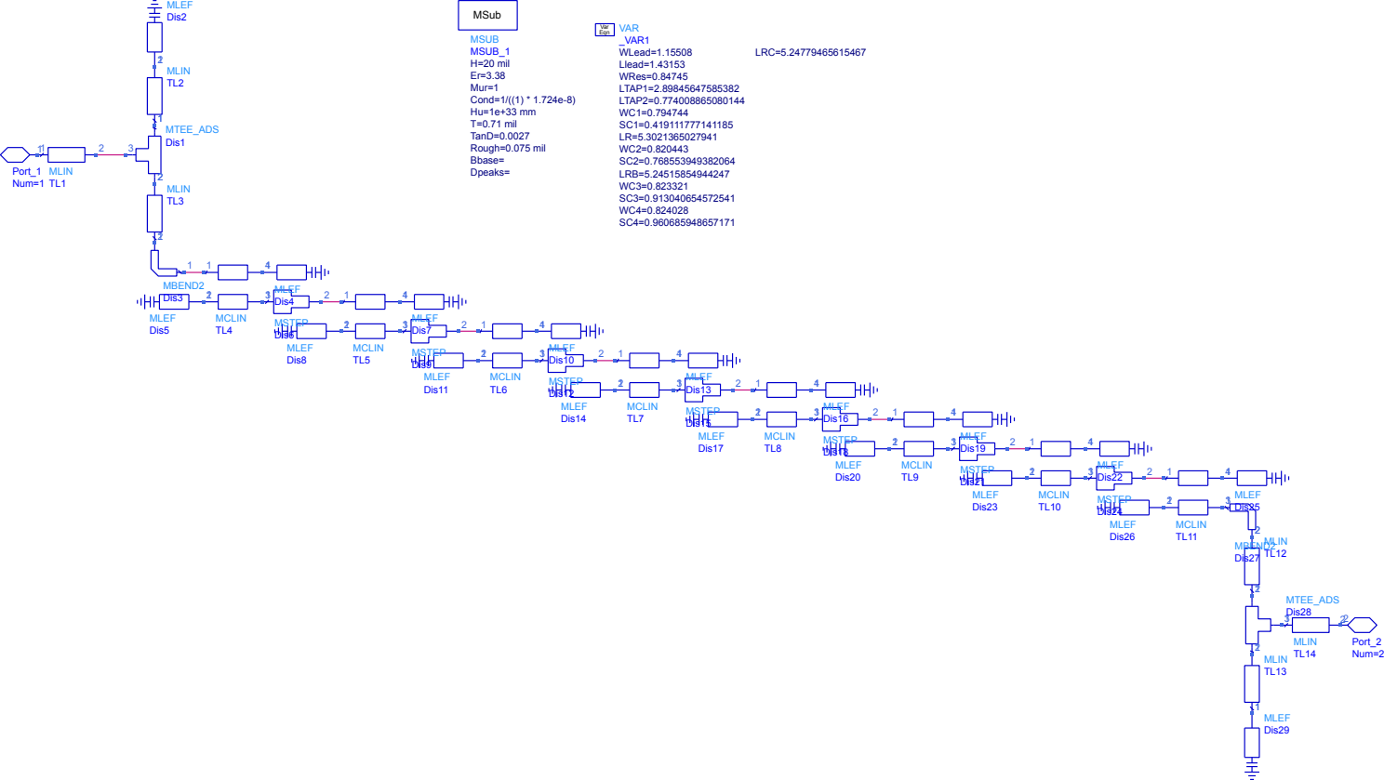
[picture p33: figure]
MSub; Var; Eqn; Port_2; Port_1; _VAR1; MSUB_1; Num=2TL14; Dis29; Dis28; TL12 Dis27; Dis26; Dis25; Dis24 Dis23; Dis22; Dis21 Dis20; Dis19; Dis18 Dis17; Dis16; Dis15 Dis14; Dis13; Dis12 Dis11; Dis10; Dis9 Dis8; Dis7; Dis6 Dis5; Dis4; Dis3; Dis2; Dis1; TL1Num=1; VAR; MSUB; MLIN; MLEF; MTEE_ADS; MLIN MBEND2; MCLIN; MSTEP MLEF; MBEND2; LRC=5.24779465615467; LRB=5.24515854944247; LTAP2=0.774008865080144; LTAP1=2.89845647585382; WRes=0.84745; Llead=1.43153; WLead=1.15508; Dpeaks=; Bbase=; Rough=0.075 mil; TanD=0.0027; T=0.71 mil; Cond=1/((1) * 1.724e-8); Mur=1; H=20 mil
