lazbaphilipp/ADS_HW/Project/КД/МПСУ.464342.21-005ПП.xls

Перв. примен. | Формат | Зона |  | Поз. |  | Обозначение |  |  |  | Наименование |  |  | Кол. | Примечание
 | А4, А3 |  |  | 1
Справ. № |  |  |  |  |  |  |  |  |  | Документация
 |  |  |  | 2 |  | МПСУ.464342.21-005СБ |  |  |  | Сборочный чертеж
 |  |  |  | 3 |  | МПСУ.687254.21-005Д1 |  |  |  | Данные проектирования
 |  |  |  |  |  | МПСУ.687254.21-005Т5М |  |  |  | Данные конструирования
 |  |  |  | 4
 |  |  |  | 5
 |  |  |  | 6 |  |  |  |  |  | Материалы
 |  |  |  | 7
 |  |  |  | 8 |  |  |  |  |  | Rogers RO4350B 0.508мм
Подп. и дата |  |  |  | 9 |  |  |  |  |  | (фольга 0.18мм)
 |  |  |  | 10
 |  |  |  | 11
Инв. № дубл. |  |  |  | 12
Взам. инв. №
Подп. и дата
 |  |  |  |  |  |  |  |  | МПСУ.464342.21-001
 | Изм. |  | Лист |  | № докум. |  | Подп. | Дата
Инв. № подл. | Разраб. |  |  |  | Лазба |  |  |  | Приемная ячейка усиления и фильтрации с детектированием мощности |  | Лит. | Лист |  |  | Листов
 | Пров. |  |  |  | Приходько |  |  |  |  |  |  | 1 |  |  | 2
 | ЗамДир |  |  |  | Лялин
 | Н. контр.
 | Утв.
