lazbaphilipp/ADS_HW/Project/КД/МПСУ.687254.21-005.xls

Sheet: МПСУ.464342.21-001. Первый лист
Перв. примен. | Формат | Зона |  | Поз. |  | Обозначение |  |  |  | Наименование |  |  | Кол. | Примечание
 |  |  |  |  |  |  |  |  |  | Детали
 | А4, А3 |  |  | 1 |  | МПСУ.464342.21-001 |  |  |  | Плата печатная |  |  | 1
 |  |  |  |  |  |  |  |  |  | Прочие изделия
Справ. №
 |  |  |  |  |  |  |  |  |  | Конденсаторы
 |  |  |  | 2 |  |  |  |  |  | 0.33 uF± %100805 |  |  | 4 | C12, C15, C18,
 |  |  |  |  |  |  |  |  |  |  |  |  |  | C21
 |  |  |  | 3 |  |  |  |  |  | 1 uF± %1010 V0603X5R |  |  | 4 | C11, C14, C17,
 |  |  |  |  |  |  |  |  |  |  |  |  |  | C20
 |  |  |  | 4 |  |  |  |  |  | 1 uF± 10 %16 V0603X7R |  |  | 3 | C1-C3
 |  |  |  | 5 |  |  |  |  |  | 1 uF0402 |  |  | 1 | C26
 |  |  |  | 6 |  |  |  |  |  | 10 nF0402 |  |  | 1 | C24
 |  |  |  | 7 |  |  |  |  |  | 10 pF± 10 %16 V0603X7R |  |  | 3 | C4-C6
 |  |  |  | 8 |  |  |  |  |  | 10 pF0402 |  |  | 1 | C22
Подп. и дата |  |  |  | 9 |  |  |  |  |  | 10 uF± 10 %16 V0603X7R |  |  | 3 | C7-C9
 |  |  |  | 10 |  |  |  |  |  | 100 nF0402 |  |  | 3 | C25, C27, C30
 |  |  |  | 11 |  |  |  |  |  | 100 pF± %100402 |  |  | 4 | C10, C13, C16,
 |  |  |  |  |  |  |  |  |  |  |  |  |  | C19
Инв. № дубл. |  |  |  | 12 |  |  |  |  |  | OPT0402 |  |  | 3 | C23, C28, C29
Взам. инв. №
Подп. и дата
 |  |  |  |  |  |  |  |  | МПСУ.464342.21-001
 | Изм. |  | Лист |  | № докум. |  | Подп. | Дата
Инв. № подл. | Разраб. |  |  |  | Лазба |  |  |  | Приемная ячейка усиления и фильтрации с детектированием мощности |  | Лит. | Лист |  |  | Листов
 | Пров. |  |  |  | Приходько |  |  |  |  |  |  | 1 |  |  | 2
 | ЗамДир |  |  |  | Лялин
 | Н. контр.
 | Утв.

Sheet: 2
 | Формат | Зона |  | Поз. |  | Обозначение |  |  |  | Наименование | Кол. | Примечание
 |  |  |  |  |  |  |  |  |  | Микросхемы
 |  |  |  | 13 |  |  |  |  |  | Analog Devices | 3 | DA1-DA3
 |  |  |  | 14 |  |  |  |  |  | LTC5597Analog Devices | 1 | DA6
 |  |  |  | 15 |  |  |  |  |  | PIC12F1822-I/SN | 1 | DD1
 |  |  |  | 16 |  |  |  |  |  | PMA-183PLN+Mini-Circuits | 2 | DA4, DA5
 |  |  |  |  |  |  |  |  |  | Резисторы
 |  |  |  | 17 |  |  |  |  |  | 1 Ohm± 5%25 V63 mW0402 | 2 | R9, R12
 |  |  |  | 18 |  |  |  |  |  | 1 Ohm0402 | 1 | R13
 |  |  |  | 19 |  |  |  |  |  | 10 Ohm± 5%25V63 mW0402 | 2 | R2, R4
 |  |  |  | 20 |  |  |  |  |  | 100 Ohm± 5%25 V63 mW0402 | 1 | R10
 |  |  |  | 21 |  |  |  |  |  | 180 Ohm± 5%25V63 mW0402 | 2 | R3, R5
 |  |  |  | 22 |  |  |  |  |  | 2 kOhm± 5%25 V63 mW0402 | 1 | R7
 |  |  |  | 23 |  |  |  |  |  | 3 kOhm± 5%25 V63 mW0402 | 1 | R8
 |  |  |  | 24 |  |  |  |  |  | 50 Ohm50 V5 W0603 | 1 | R1
 |  |  |  | 25 |  |  |  |  |  | OPT± 5%25 V63 mW0402 | 2 | R6, R11
Подп. и дата |  |  |  |  |  |  |  |  |  | Переключатели
 |  |  |  | 26 |  |  |  |  |  | L-KLS7-TS6604-4.3-180-BKLS | 1 | S1
 |  |  |  |  |  |  |  |  |  | electronic co ltd
Инв. № дубл. |  |  |  |  |  |  |  |  |  | Розетки
 |  |  |  | 27 |  |  |  |  |  | PBD-2 2x1 | 1 | XS2
 |  |  |  | 28 |  |  |  |  |  | XT-60-PW-F | 1 | XS1
Взам. инв. №
 |  |  |  |  |  |  |  |  |  | Соединители выскочастотные
 |  |  |  | 29 |  |  |  |  |  | SMA862A1-0000 | 2 | XW1, XW2
Подп. и дата
Инв. № подл.
 |  |  |  |  |  |  |  |  | МПСУ.464342.21-001 |  |  |  | Лист
 |  |  |  |  |  |  |  |  |  |  |  |  | 2
 | Изм. |  | Лист |  | № докум. |  | Подп. | Дата
