lazbaphilipp/ADS_HW/images/Altium-Components/LayerStack3D.png

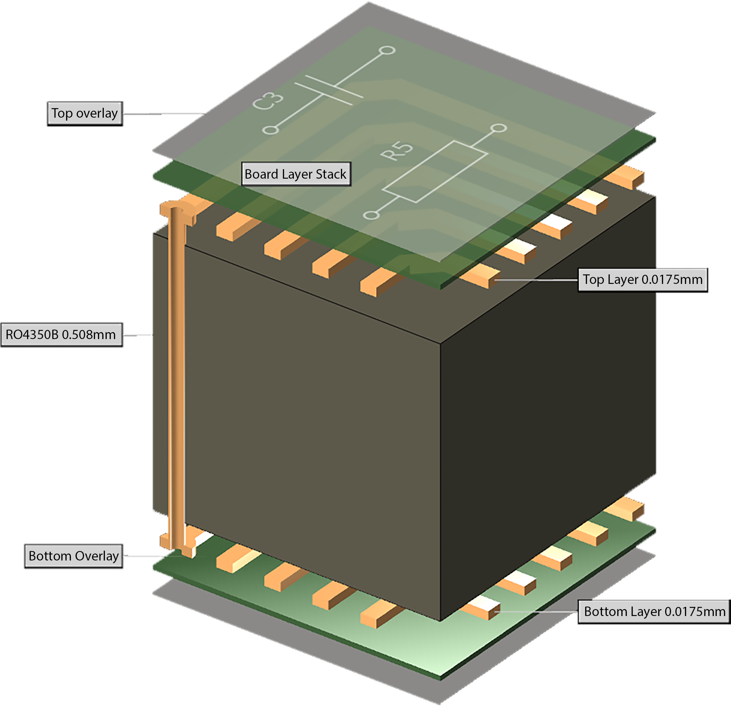
images/Altium-Components/LayerStack3D.png
