lazbaphilipp/ADS_HW/images/Altium-Components/LNA_3D_View.png

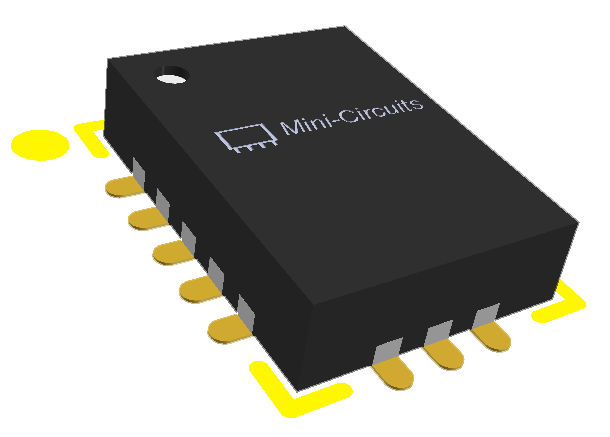
images/Altium-Components/LNA_3D_View.png
