lazbaphilipp/ADS_HW/images/Altium-Components/MC_3D_View.png

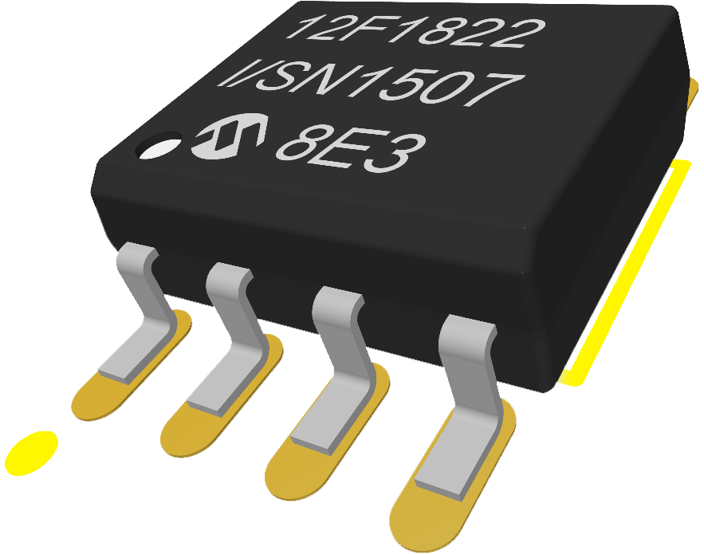
images/Altium-Components/MC_3D_View.png
