lazbaphilipp/ADS_HW/images/Altium-Components/not used/Atmega/MC_3D_View.png

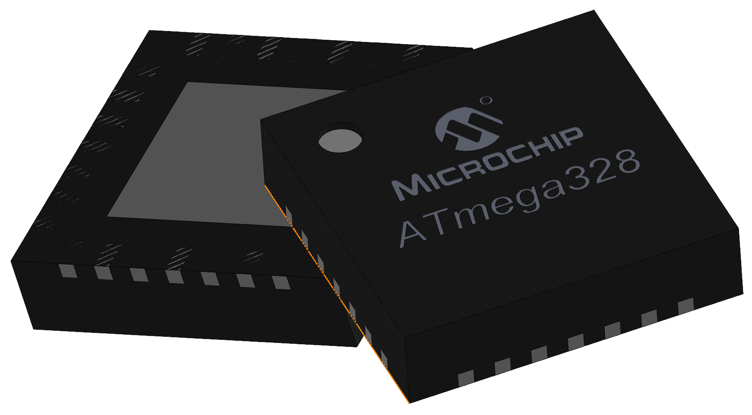
images/Altium-Components/not used/Atmega/MC_3D_View.png
