lazbaphilipp/ADS_HW/images/Altium-Components/PD_3D_View.png

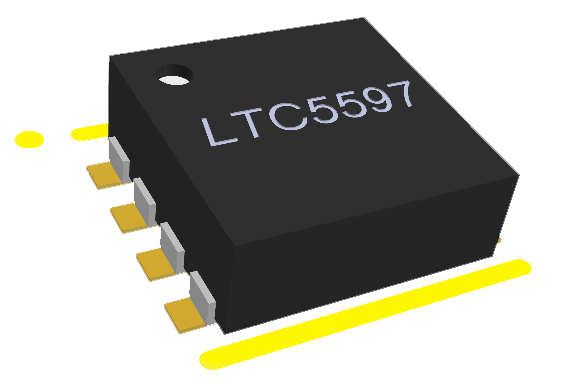
images/Altium-Components/PD_3D_View.png
