lazbaphilipp/ADS_HW/images/Altium-Components/PM_3D_View.png

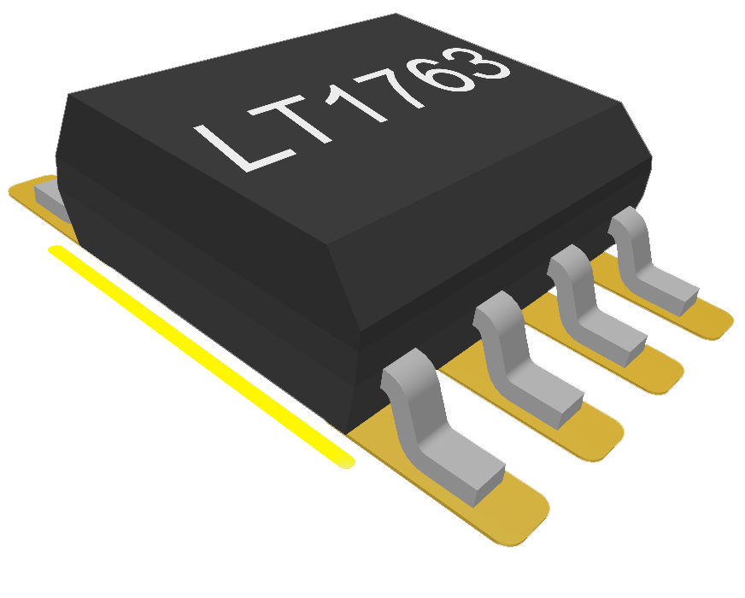
images/Altium-Components/PM_3D_View.png
