lazbaphilipp/ADS_HW/images/Altium-Draftsman/DiscreteDocBom.png

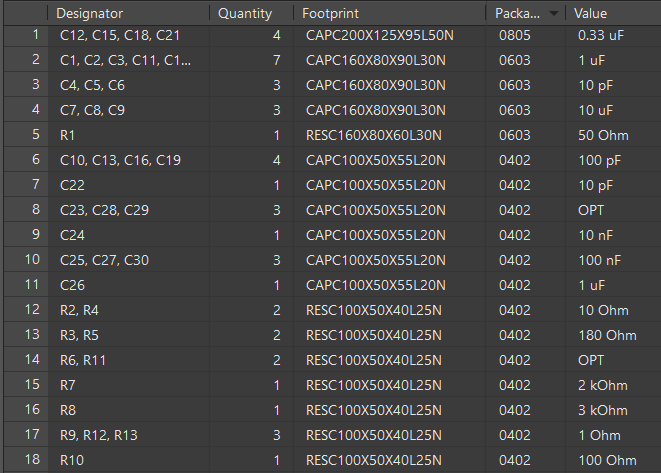
images/Altium-Draftsman/DiscreteDocBom.png
