lazbaphilipp/ADS_HW/images/parts_design/LineCalc.png

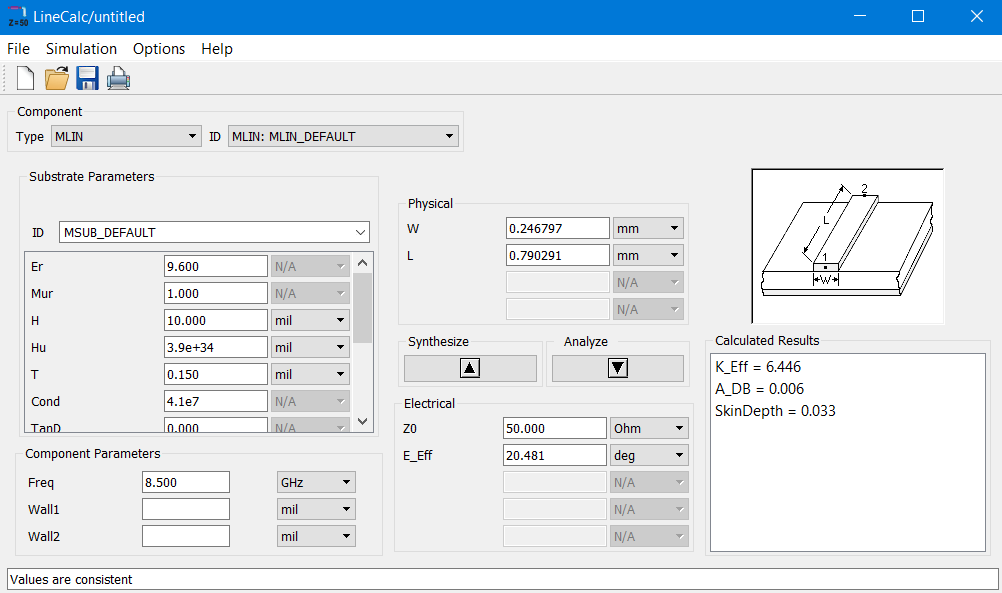
images/parts_design/LineCalc.png
