lazbaphilipp/ADS_HW/images/parts_design/SmithChart.png

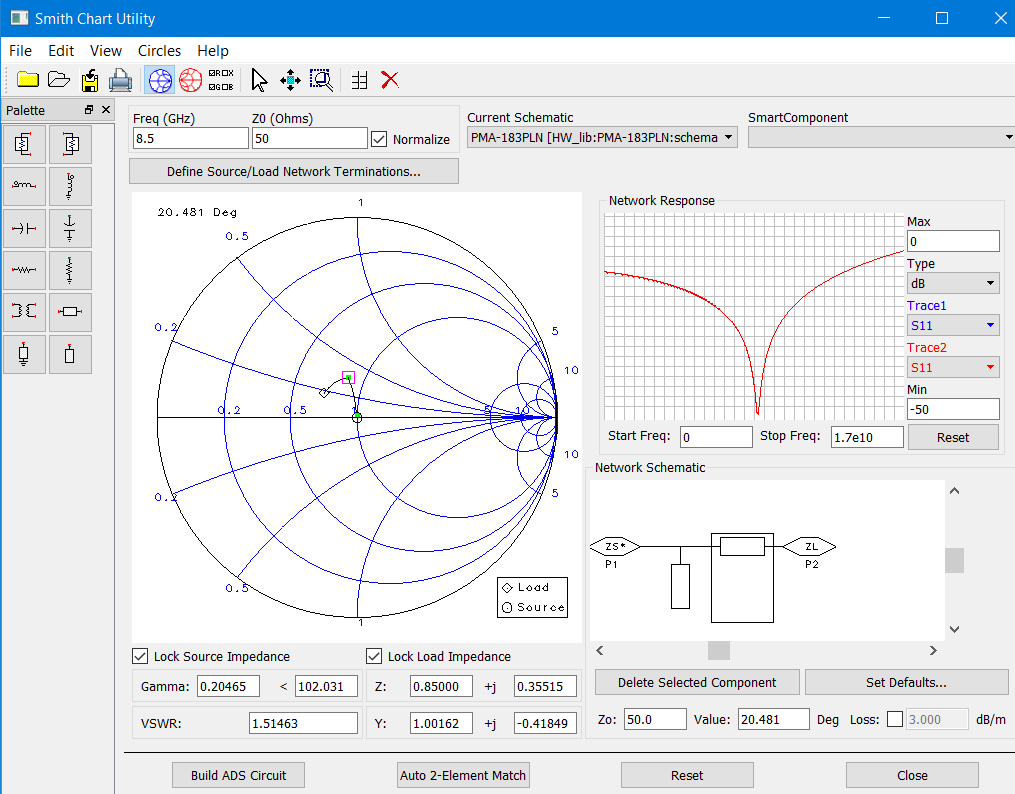
images/parts_design/SmithChart.png
