lazbaphilipp/ADS_HW/images/parts_design/Utilities.png

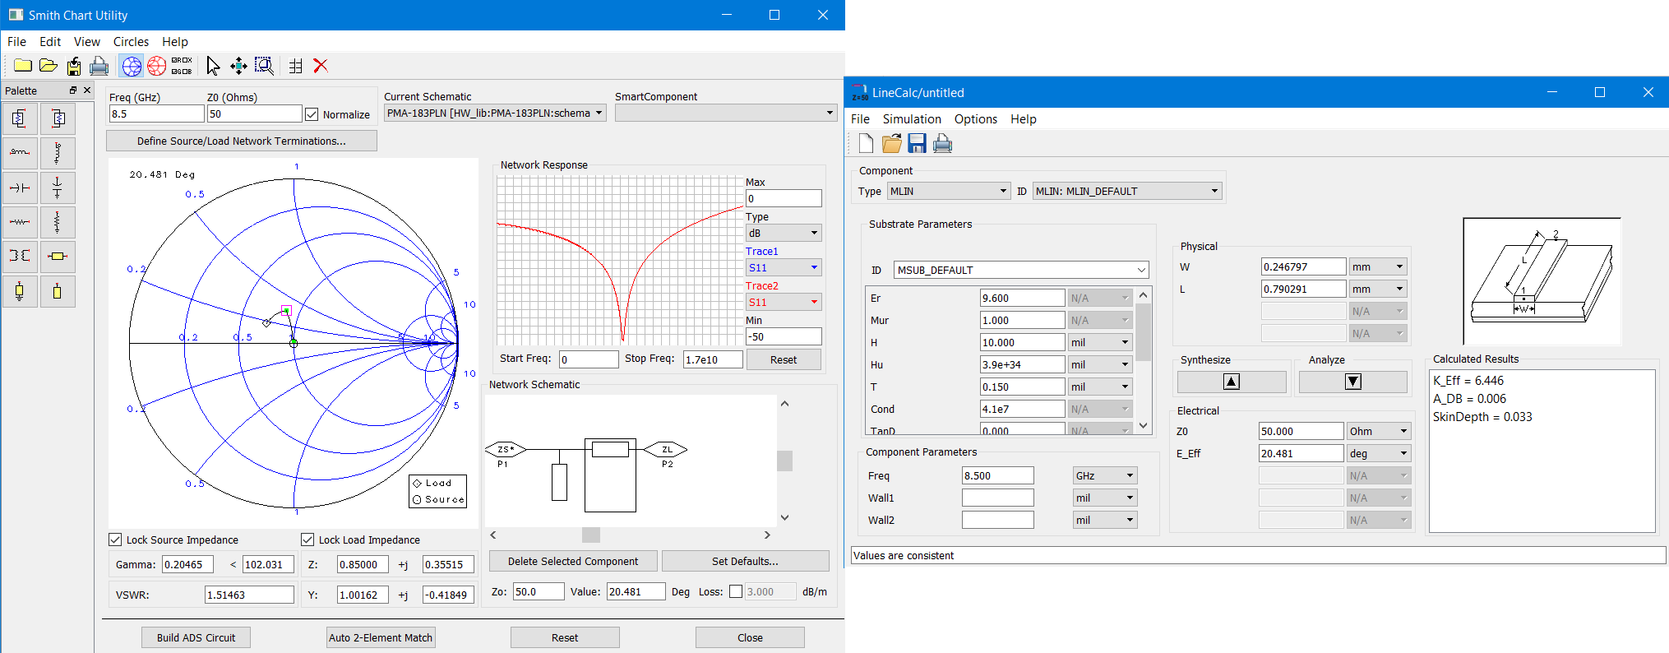
images/parts_design/Utilities.png
