lazbaphilipp/ADS_HW/Project/Components/3D Models/AssemblyWITHCUP.STEP

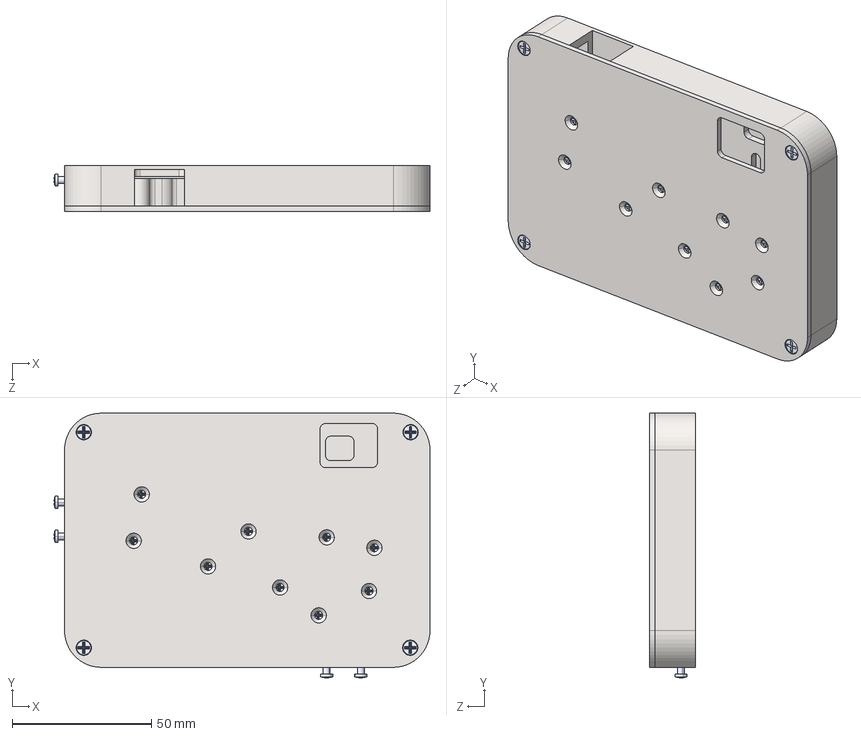
[picture p44: CAD file, 2022-02-26]
Project/Components/3D Models/AssemblyWITHCUP.STEP
135.2 x 95.2 x 16.5 mm
BoardCase
BoardShape
M2.5Cylscrew x 4
M2.5Hidescrew x 13
BoardCup
