lazbaphilipp/ADS_HW/Project/Components/3D Models/AssemblyNOCUP.STEP

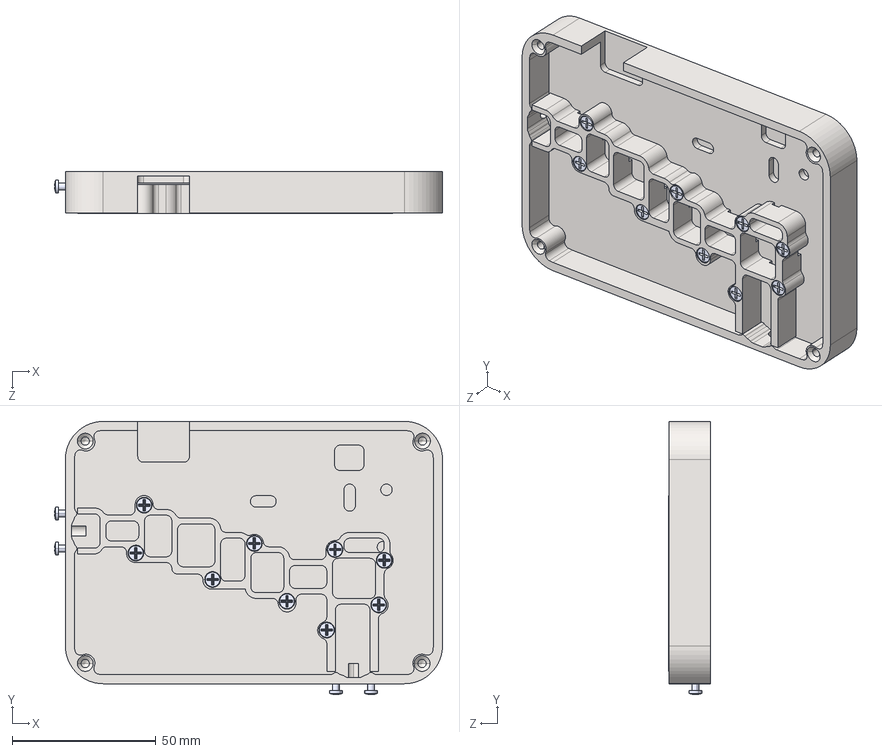
[picture p45: CAD file, 2022-02-26]
Project/Components/3D Models/AssemblyNOCUP.STEP
135.2 x 95.2 x 14.6 mm
BoardCase
BoardShape
M2.5Cylscrew x 4
M2.5Hidescrew x 9
