lazbaphilipp/ADS_HW/Project/Components/3D Models/User Library-PBS_(DS1023)_1line_connectors_h=5_0_8_5mm_step_2_54mm-1.sldprt

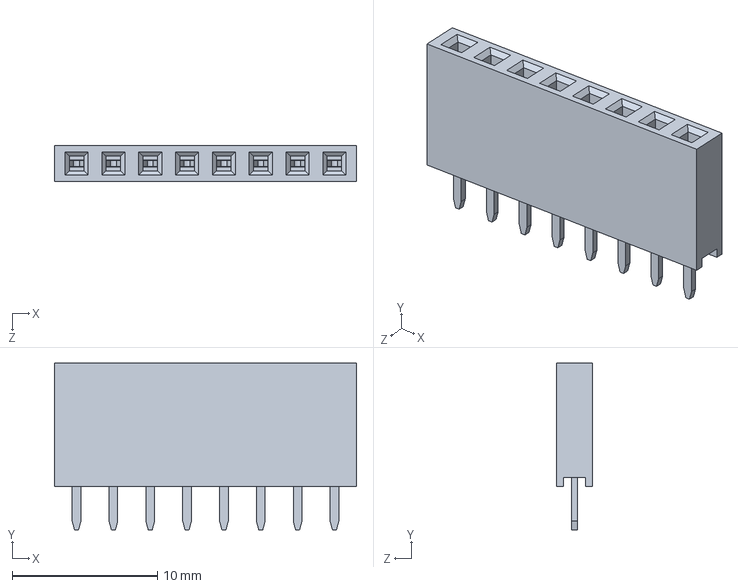
[picture p46: CAD file, 2022-02-26]
Project/Components/3D Models/User Library-PBS_(DS1023)_1line_connectors_h=5_0_8_5mm_step_2_54mm-1.sldprt
20.8 x 11.5 x 2.50 mm
