lazbaphilipp/ADS_HW/Project/Components/Power Detector/MC ATmega328 (nu)/QFN127P600-8N.step

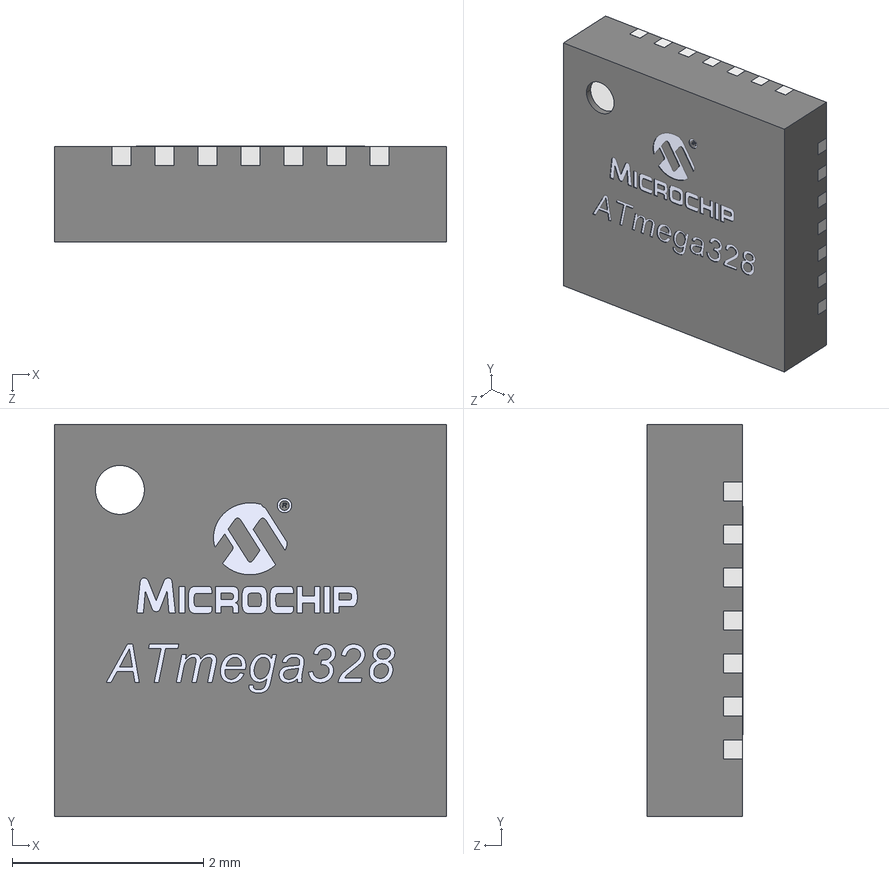
[picture p47: CAD file, 2022-02-26]
Project/Components/Power Detector/MC ATmega328 (nu)/QFN127P600-8N.step
4.10 x 4.10 x 1.00 mm
Open_CASCADE_STEP_translator_6.8_1.2.1.step
Open_CASCADE_STEP_translator_6.8_1.4.1.step x 28
Open_CASCADE_STEP_translator_6.8_1.1.step
Thermal_Shape.step
