lazbaphilipp/ADS_HW/Project/Components/Power Detector/MC PIC12LF1822/SN-SOIC127P600X175-8N.step

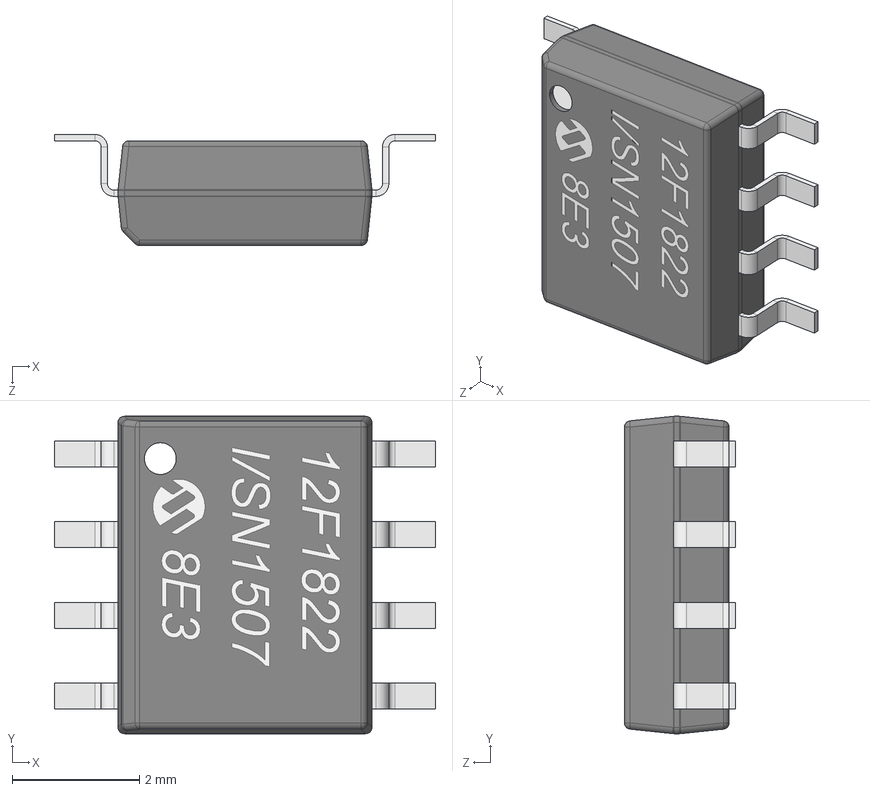
[picture p48: CAD file, 2022-02-26]
Project/Components/Power Detector/MC PIC12LF1822/SN-SOIC127P600X175-8N.step
6.00 x 5.00 x 1.75 mm
Leader.step x 8
