lazbaphilipp/ADS_HW/Project/Components/PowerManagement/SOIC8P127_490X600X175L83X41.STEP

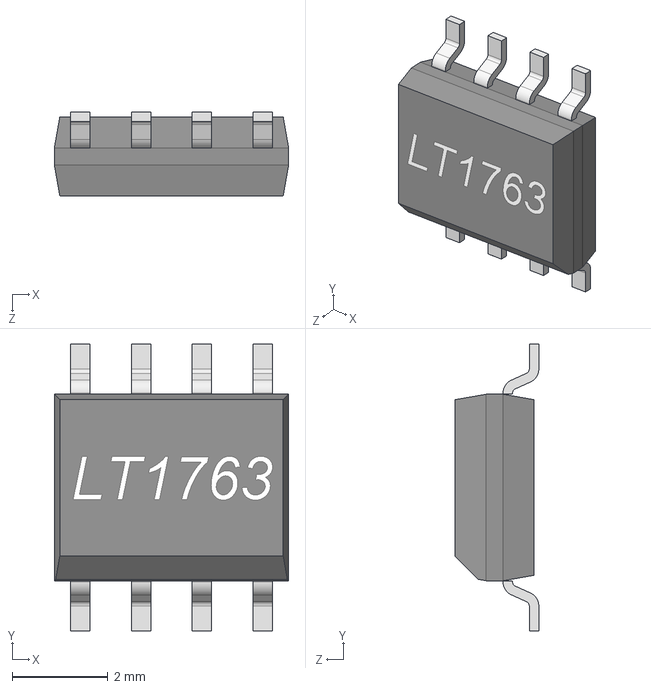
[picture p49: CAD file, 2022-02-26]
Project/Components/PowerManagement/SOIC8P127_490X600X175L83X41.STEP
4.90 x 6.00 x 1.75 mm
