lazbaphilipp/ADS_HW/Project/Components/3D Models/BoardCase.SLDPRT

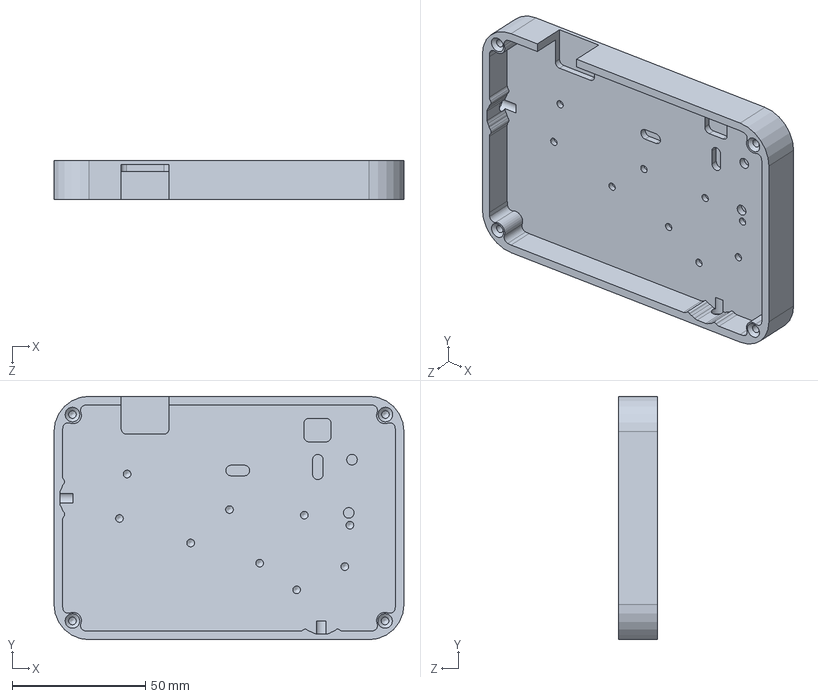
[picture p50: CAD file, 2022-02-26]
Project/Components/3D Models/BoardCase.SLDPRT
131.4 x 91.4 x 14.5 mm
