lazbaphilipp/ADS_HW/Project/Components/Power Detector/MC ATmega328 (nu)/atmega328p-an.STEP

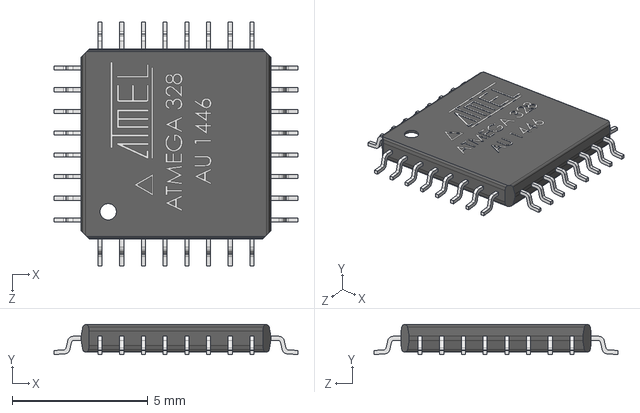
[picture p51: CAD file, 2022-02-26]
Project/Components/Power Detector/MC ATmega328 (nu)/atmega328p-an.STEP
9.00 x 1.11 x 9.00 mm
