lazbaphilipp/ADS_HW/Project/Components/Power Detector/MC PIC12LF1822/Microchip_logo.dxf

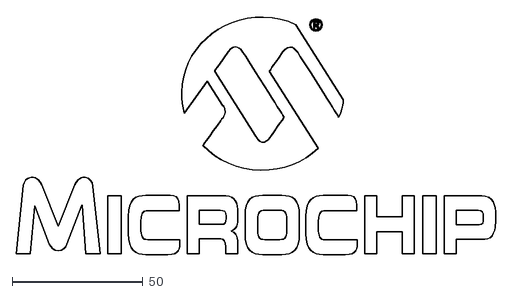
[picture p52: CAD file, 2022-02-26]
Project/Components/Power Detector/MC PIC12LF1822/Microchip_logo.dxf
183.1 x 90.9
