lazbaphilipp/ADS_HW/Project/Components/Power Detector/MC ATmega328 (nu)/Scene.STEP

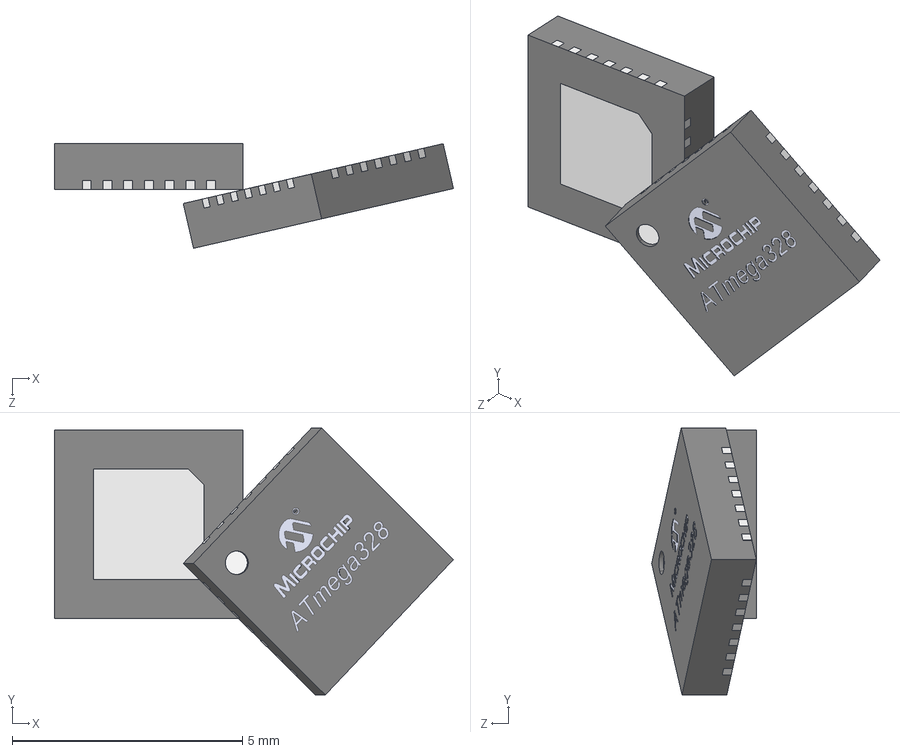
[picture p53: CAD file, 2022-02-26]
Project/Components/Power Detector/MC ATmega328 (nu)/Scene.STEP
8.67 x 5.80 x 2.27 mm
Open_CASCADE_STEP_translator_6.8_1.2.1.step.step x 2
Open_CASCADE_STEP_translator_6.8_1.4.1.step.step x 56
Open_CASCADE_STEP_translator_6.8_1.1.step.step x 2
Thermal_Shape.step.step x 2
