lazbaphilipp/ADS_HW/Project/Components/3D Models/BaordCase.DXF

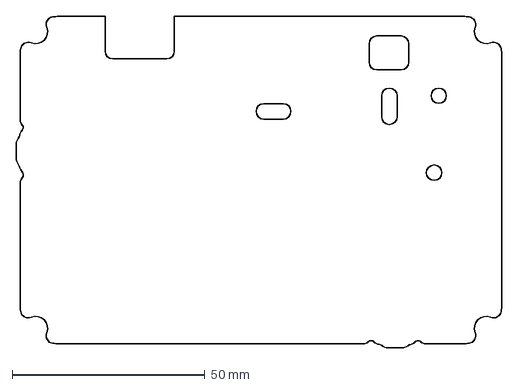
[picture p54: CAD file, 2022-02-26]
Project/Components/3D Models/BaordCase.DXF
126.0 x 86.0 mm
