lazbaphilipp/ADS_HW/Project/Components/3D Models/BoardShape.SLDPRT

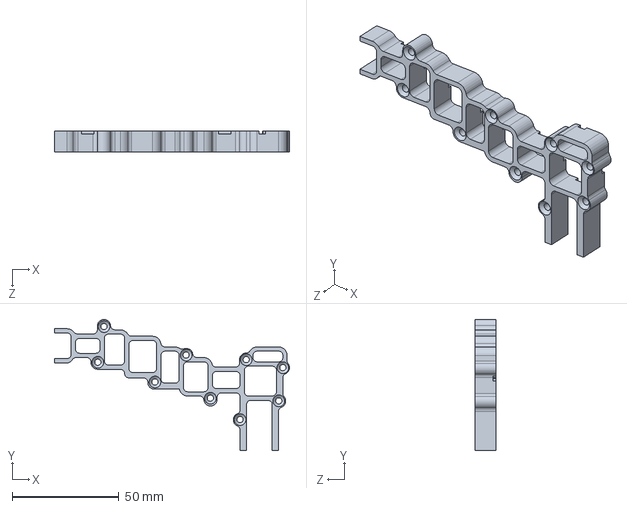
[picture p55: CAD file, 2022-02-26]
Project/Components/3D Models/BoardShape.SLDPRT
109.9 x 61.3 x 10.0 mm
