lazbaphilipp/ADS_HW/Project/Components/3D Models/BoardCup.SLDPRT

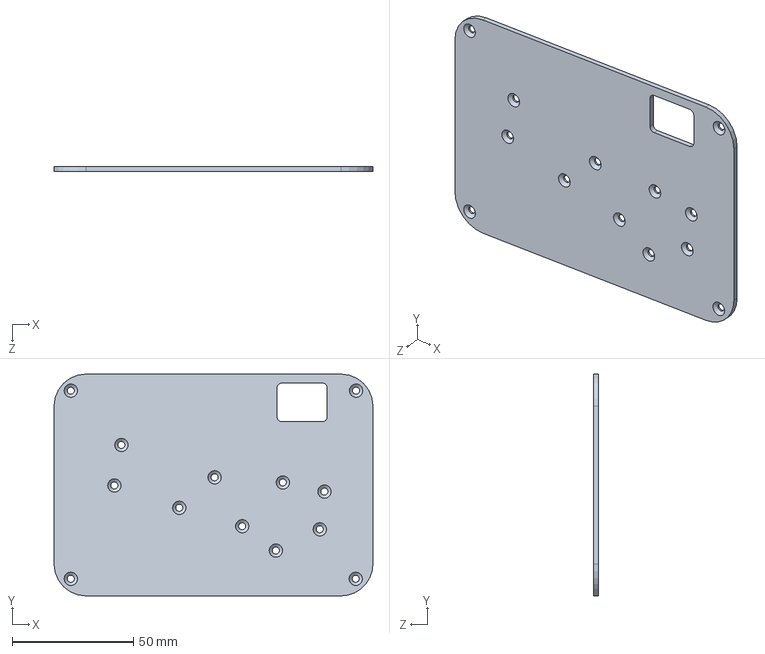
[picture p56: CAD file, 2022-02-26]
Project/Components/3D Models/BoardCup.SLDPRT
131.4 x 91.4 x 2.00 mm
