lazbaphilipp/ADS_HW/(list of files, cad)

Other CAD files:
Project/Components/Microstrip/MainAdap.dxf
Project/Components/3D Models/Assembly.SLDASM
Project/Components/LNA/PMA-183PLN+_S2P/PMA_Adap_in.dxf
Project/Components/MFilter 8,5G/MFilter.dxf
Project/Components/Power Detector/PD LTC5597/LTC_Adap.dxf
Project/HW_wrk/mfg/HW_lib_LTC_Adap/dxf/LTC_Adap.dxf
Project/HW_wrk/mfg/HW_lib_PMA_Adap_out/dxf/PMA_Adap_out.dxf
Project/Components/LNA/PMA-183PLN+_S2P/PMA_Adap_out.dxf
Project/Components/MFilter 8,5G/MFilter8_5GMFilter8_5G_Design.dxf
Project/Components/Microstrip/CLCoupler.dxf
Project/Components/3D Models/BoardShape.DXF
Project/Components/3D Models/M2.5Cylscrew.SLDPRT
Project/Components/3D Models/M2.5Hidescrew.SLDPRT
Project/HW_wrk/simulation/HW_lib/CLC_EMI/layout/emSetup_MoM/proj.prt
Project/HW_wrk/simulation/HW_lib/CLC_EMI/layout/emSetup_MoM/proj_out.prt
Project/HW_wrk/simulation/HW_lib/LTC_Adap/layout/emSetup_MoM/proj.prt
Project/HW_wrk/simulation/HW_lib/LTC_Adap/layout/emSetup_MoM/proj_out.prt
Project/HW_wrk/simulation/HW_lib/MFilter8_5G_Design/layout/emSetup_MoM/proj.prt
Project/HW_wrk/simulation/HW_lib/MFilter8_5G_Design/layout/emSetup_MoM/proj_out.prt
Project/HW_wrk/simulation/HW_lib/MainAdap/layout/emSetup_MoM/proj.prt
Project/HW_wrk/simulation/HW_lib/MainAdap/layout/emSetup_MoM/proj_out.prt
Project/HW_wrk/simulation/HW_lib/PMA_Adap_in/layout/emSetup_MoM/proj.prt
Project/HW_wrk/simulation/HW_lib/PMA_Adap_in/layout/emSetup_MoM/proj_out.prt
Project/HW_wrk/simulation/HW_lib/PMA_Adap_out/layout/emSetup_MoM/proj.prt
Project/HW_wrk/simulation/HW_lib/PMA_Adap_out/layout/emSetup_MoM/proj_out.prt
Project/HW_wrk/simulation/HW_lib/PMA_Adap_out/layout/emSetup_viz3D/proj.prt
