lazbaphilipp/ADS_HW/images/Altium-Schematic/Main_SchDoc.pdf

1 | 2

RF

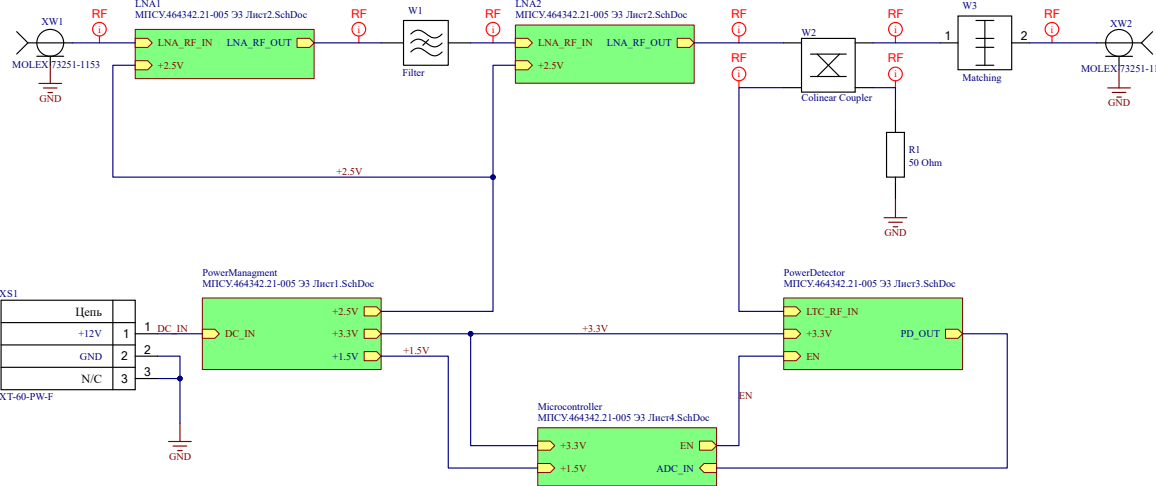
[picture p57: page 1]
MOLEX 73251-1153; Matching; R1 50 Ohm; MOLEX 73251-1; GND; LNA_RF_IN; LNA_RF_OUT; LNA2 МПСУ.464342.21-005 Э3 Лист2.SchDoc; LNA1 МПСУ.464342.21-005 Э3 Лист2.SchDoc; PowerManagment МПСУ.464342.21-005 Э3 Лист1.SchDoc; Filter; ADC_IN; Microcontroller МПСУ.464342.21-005 Э3 Лист4.SchDoc; Цепь; LTC_RF_IN; PD_OUT; PowerDetector МПСУ.464342.21-005 Э3 Лист3.SchDoc; Colinear Coupler
