lazbaphilipp/ADS_HW/images/Altium-Schematic/MC_SchDoc.pdf

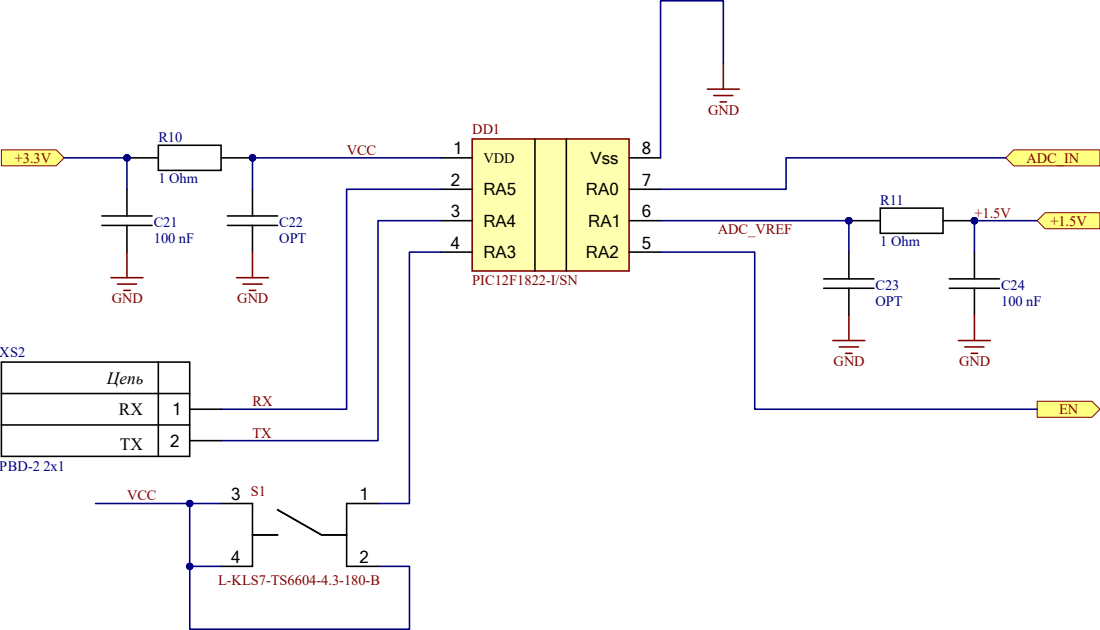
[picture p58: page 1]
1 Ohm; GND; C22 OPT; L-KLS7-TS6604-4.3-180-B; VCC; VDD 1; Vss; PIC12F1822-I/SN; ADC_VREF; ADC_IN; C23 OPT; Цепь; PBD-2 2x1
