lazbaphilipp/ADS_HW/images/component_search/LTC-power-limits.pdf

## Output Voltage, Linearity Error vs RF Input Power at 5.8GHz

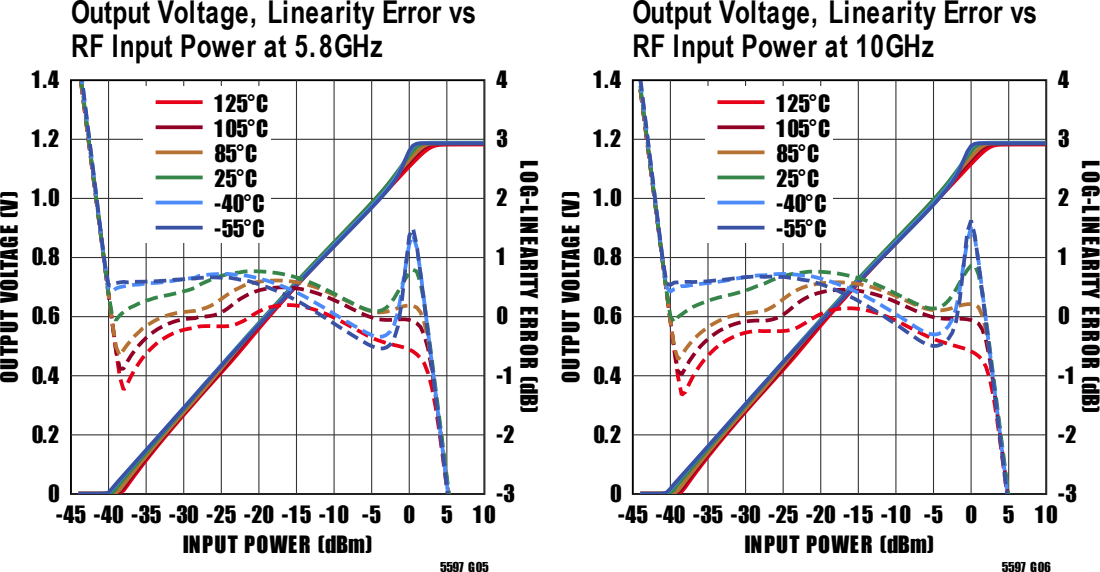
[picture p59: page 1]
OUTPUT VOLTAGE (V)

Output Voltage, Linearity Error vs
RF Input Power at 10GHz

L OG-L INEARITY ERROR (dB)

INPUT POWER (dBm)
