lazbaphilipp/ADS_HW/images/component_search/PMA-GvsFvsV.pdf

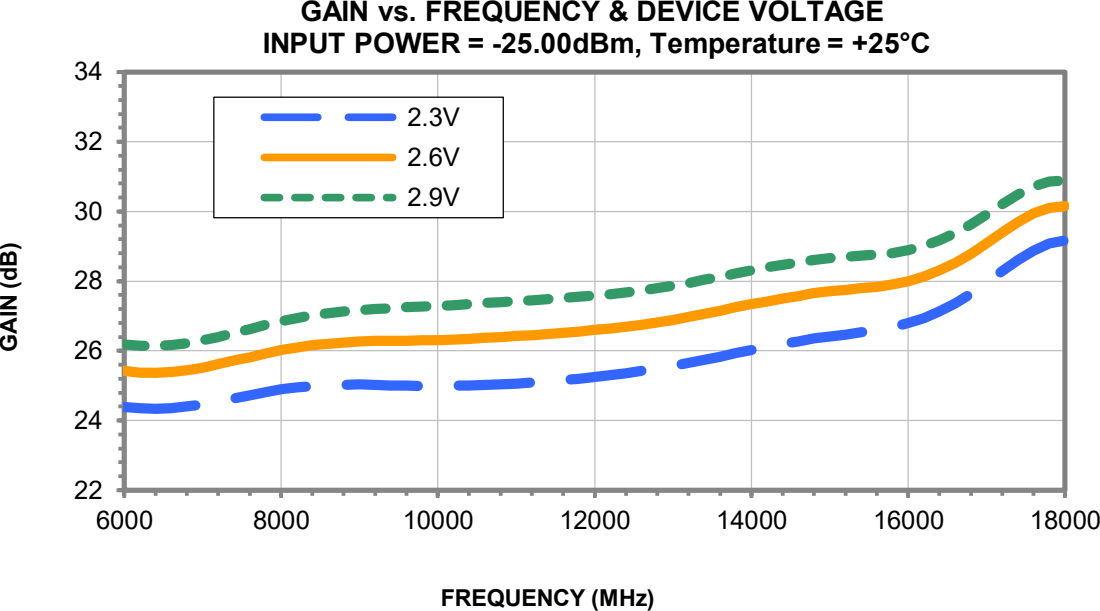
[picture p60: page 1]
GAIN (dB); FREQUENCY (MHz)

GAIN vs. FREQUENCY & DEVICE VOLTAGE
INPUT POWER = -25.00dBm, Temperature = +25°C

2.3V
2.6V 2.9V
