lazbaphilipp/ADS_HW/images/parts_design/LNA_Sch.pdf

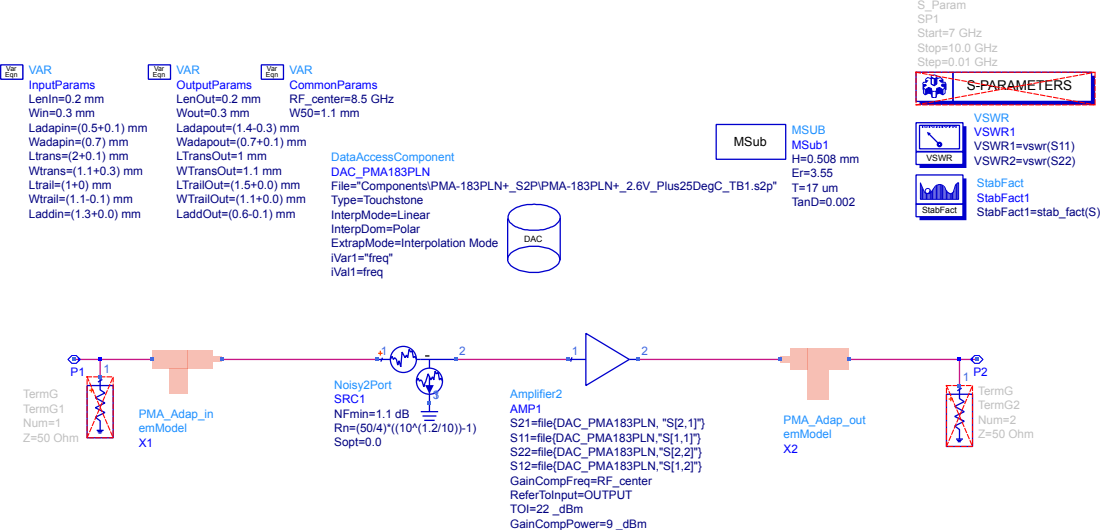
[picture p61: page 1]
DAC; S-PARAMETERS; MSub; VSWR; StabFact; Var; Eqn Var; Eqn Var Eqn; emModel; PMA_Adap_out; Noisy2Port; VAR; TermG; PMA_Adap_in; MSUB; S_Param; Amplifier2; SRC1; InputParams; OutputParams; TermG1; TermG2; CommonParams; StabFact1; VSWR1; MSub1; AMP1 NFmin=1.1 dB Rn=(50/4)*((10^(1.2/10))-1) Sopt=0.0; Win=0.3 mm; Wadapout=(0.7+0.1) mm; LenIn=0.2 mm; LenOut=0.2 mm; Z=50 Ohm; Num=2; Num=1; WTransOut=1.1 mm; RF_center=8.5 GHz; WTrailOut=(1.1+0.0) mm LaddOut=(0.6-0.1) mm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

DataAccessComponent
DAC_PMA183PLN
File="Components\PMA-183PLN+_S2P\PMA-183PLN+_2.6V_Plus25DegC_TB1.s2p"
Type=Touchstone
InterpMode=Linear
InterpDom=Polar
ExtrapMode=Interpolation Mode
iVar1="freq"
iVal1=freq
