lazbaphilipp/ADS_HW/images/Documentation/DocShowOff.pdf

# 10 отв Ø3.50mm²⁵.04mm ²⁵.48mm 32.62mm ³⁸.81mm

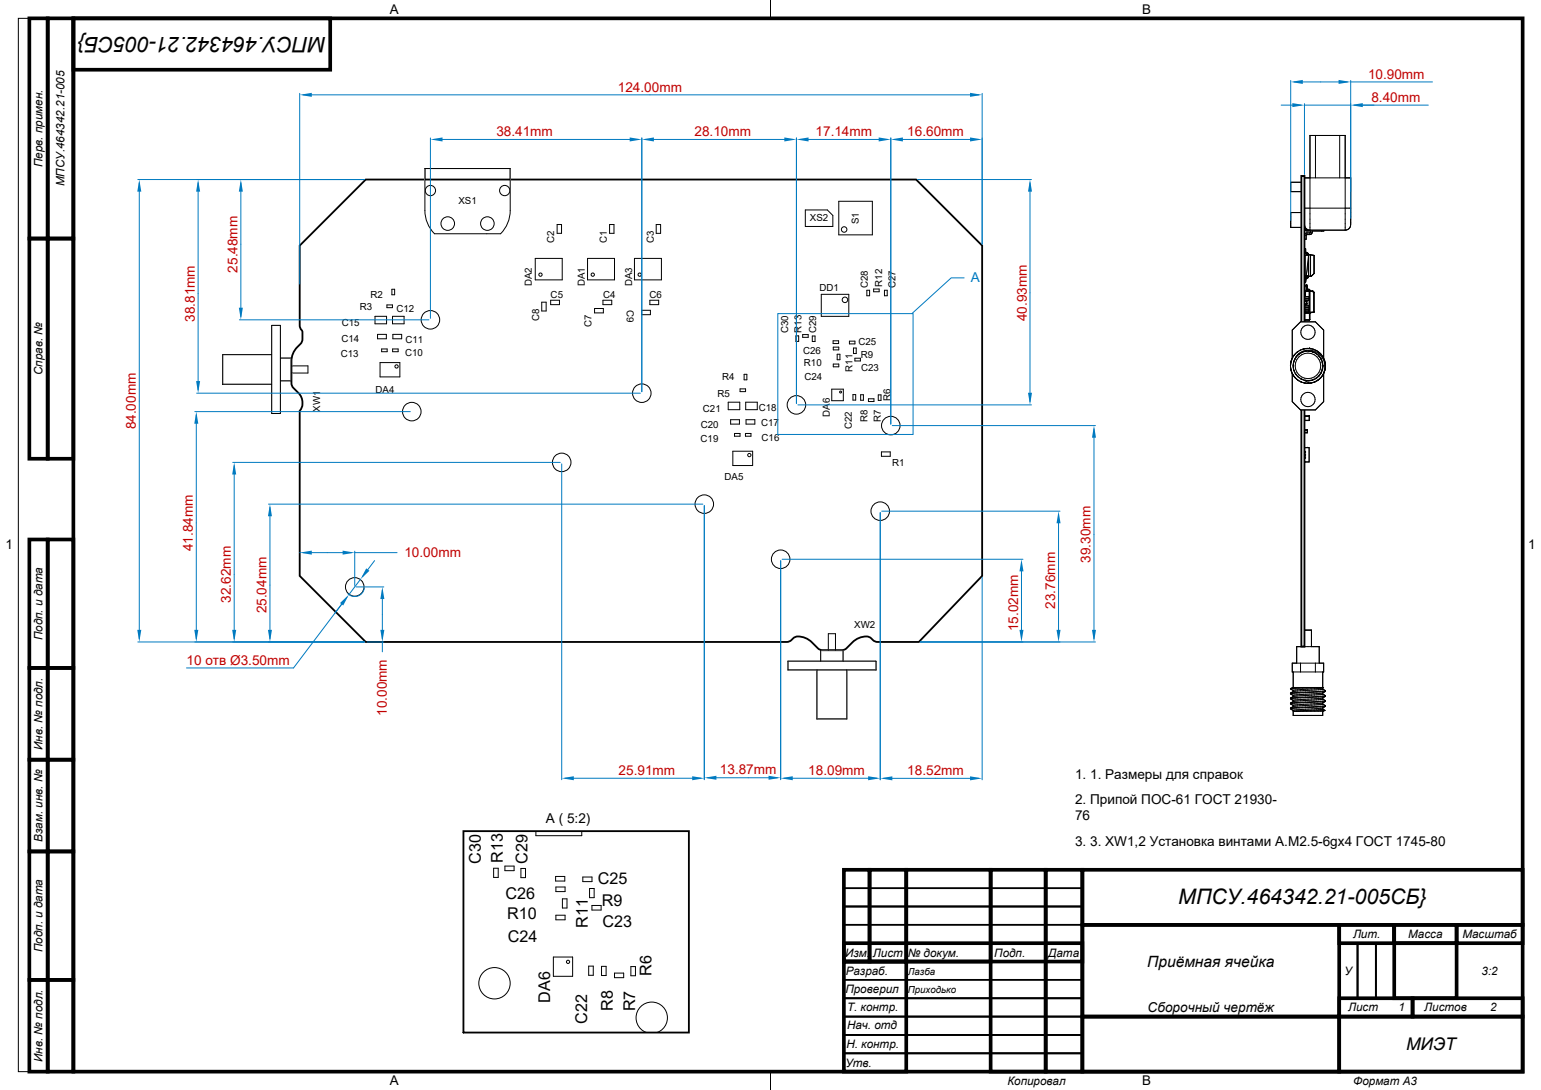
[picture p62: page 1]

Перв. примен. Справ. № Подп. и дата Инв. № подл. Взам. инв. № Подп. и дата Инв. № подл.

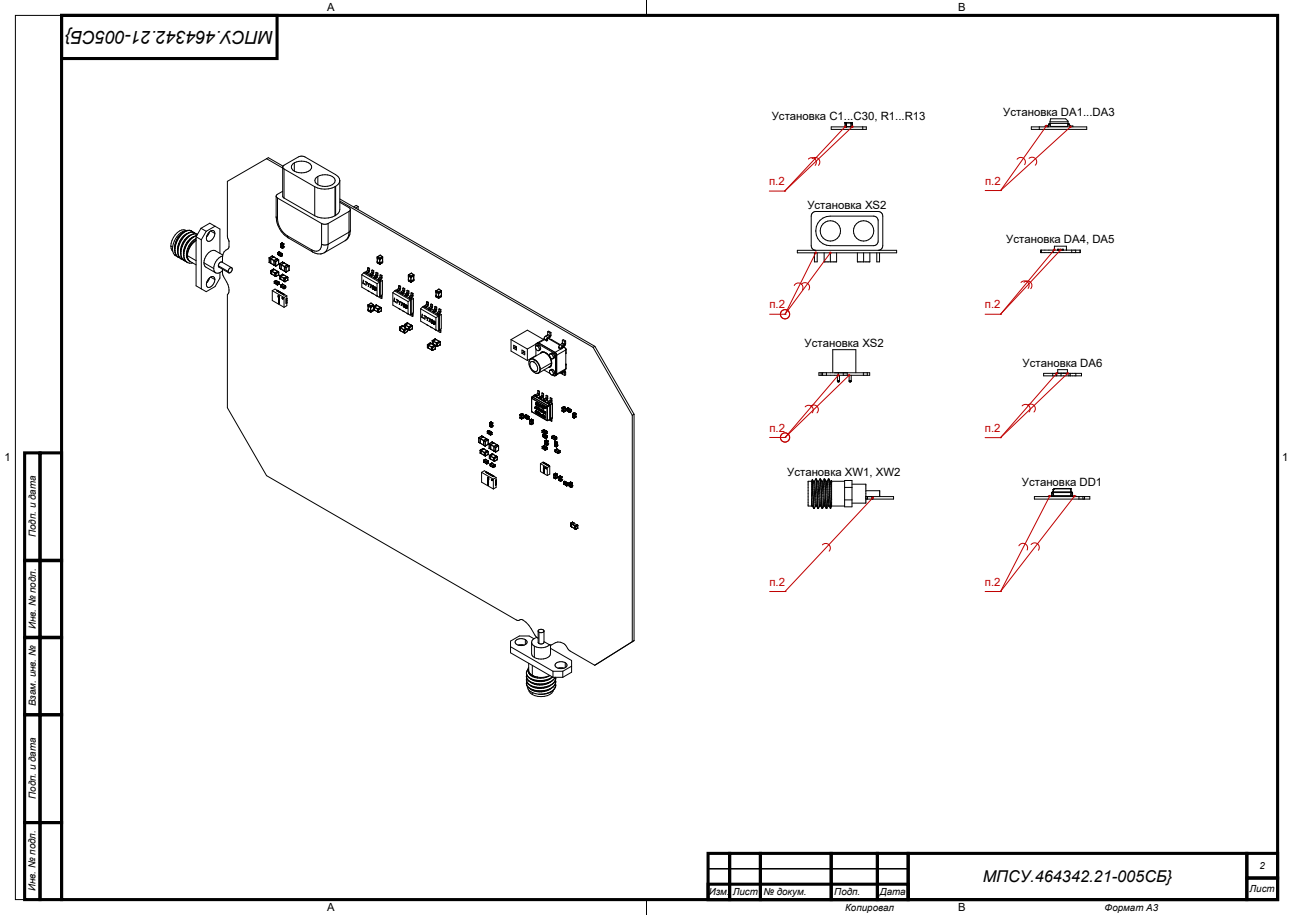
[picture p63: page 2]
Установка C1...C30, R1...R13; Установка DA1...DA3; Установка DA4, DA5; Установка DA6; Установка DD1; Установка XS2; Установка XW1, XW2; МПСУ.464342.21-005СБ}; Изм. Лист № докум.; Подп.; Дата; Лист

Подп. и дата Инв. № подл. Взам. инв. № Подп. и дата Инв. № подл.

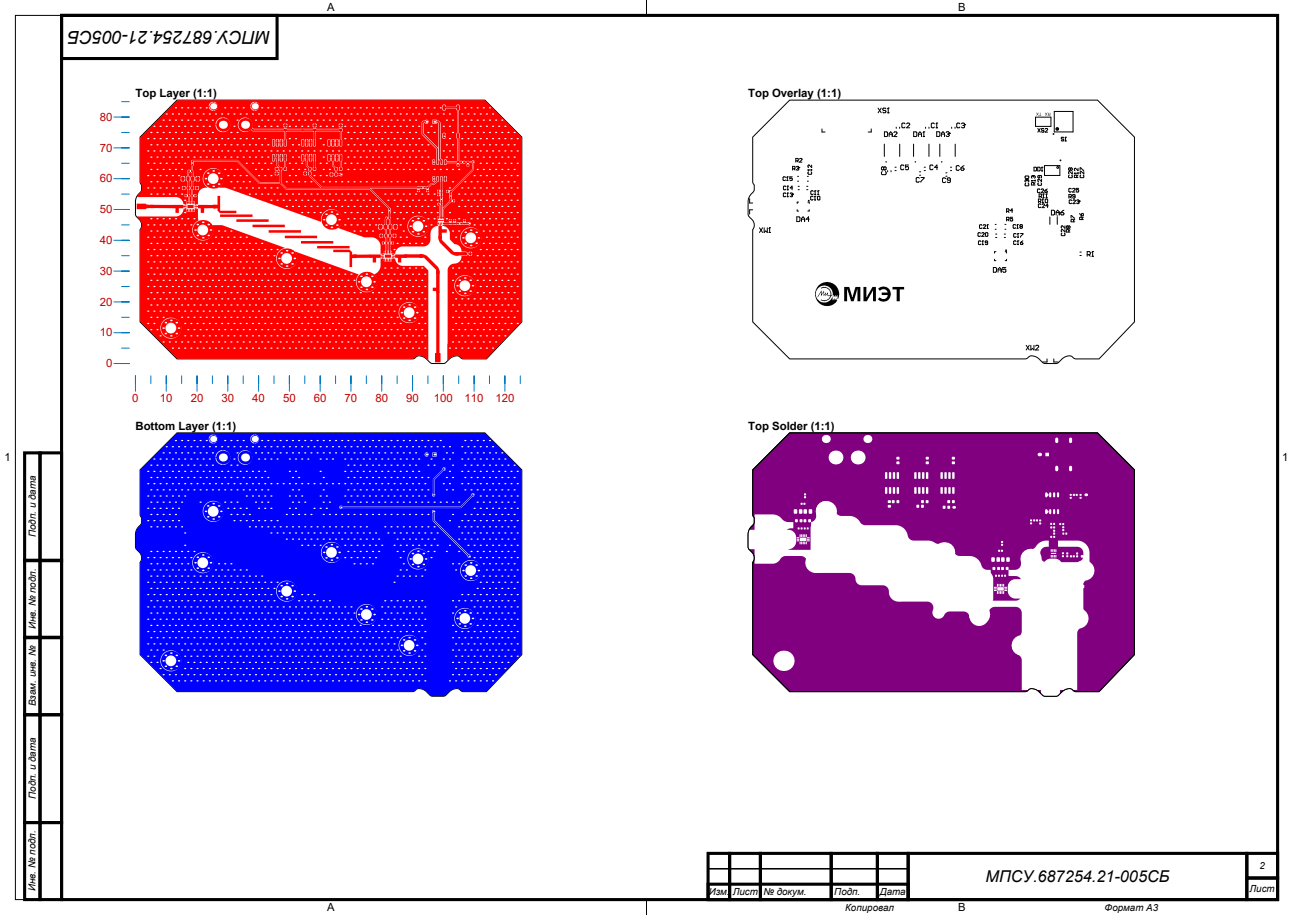
[picture p64: page 3]
МПСУ.687254.21-005СБ; Изм. Лист № докум.; Подп.; Дата; Лист; Top Layer (1:1); Bottom Layer (1:1); Top Overlay (1:1); Top Solder (1:1)

Подп. и дата Инв. № подл. Взам. инв. № Подп. и дата Инв. № подл.

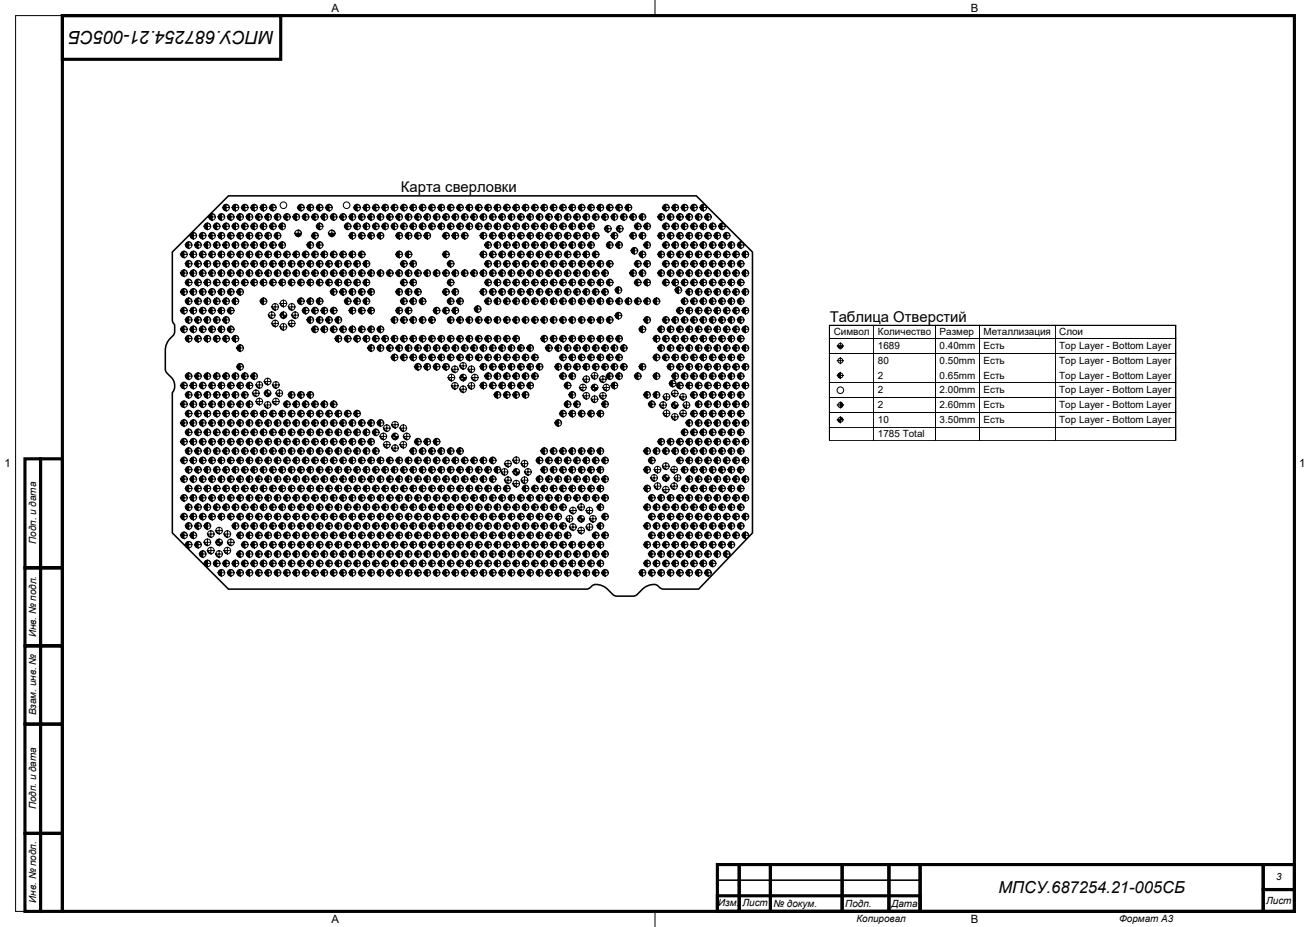
[picture p65: page 4]
МПСУ.687254.21-005СБ; Изм. Лист № докум.; Подп.; Дата; Лист; Карта сверловки; Таблица Отверстий

Символ | Количество | Размер | Металлизация | Слои

1689 | 0.40mm | Есть | Top Layer - Bottom Layer
80 | 0.50mm | Есть | Top Layer - Bottom Layer
2 | 0.65mm | Есть | Top Layer - Bottom Layer
2 | 2.00mm | Есть | Top Layer - Bottom Layer
2 | 2.60mm | Есть | Top Layer - Bottom Layer
10 | 3.50mm | Есть | Top Layer - Bottom Layer
1785 Total

Подп. и дата Инв. № подл. Взам. инв. № Подп. и дата Инв. № подл.

Изм.Лист | | № докум. | Подп. | Дата
| | Разраб. | Лазба | | Перечень элементов | Лит. | Лист | Листов
Пров. | Приходько | | | | | | 1 | 4
ЗамДир | Лялин
Н.контр
C1-C3 | 1 uF± 10 %16 V0603X7R | 3
C4-C6 | 10 pF± 10 %16 V0603X7R | 3
C7-C9 | 10 uF± 10 %16 V0603X7R | 3
C10 | 100 pF± %100402 | 1
C11 | 1 uF± %1010 V0603X5R | 1
C12 | 0.33 uF± %100805 | 1
C13 | 100 pF± %100402 | 1
C14 | 1 uF± %1010 V0603X5R | 1
C15 | 0.33 uF± %100805 | 1
C16 | 100 pF± %100402 | 1
C17 | 1 uF± %1010 V0603X5R | 1
C18 | 0.33 uF± %100805 | 1
C19 | 100 pF± %100402 | 1
C20 | 1 uF± %1010 V0603X5R | 1
C21 | 0.33 uF± %100805 | 1
C22 | 10 pF0402 | 1
C23 | OPT0402 | 1
C24 | 10 nF0402 | 1
C25 | 100 nF0402 | 1
| | C26 | 1 uF0402 | 1
| | C27 | 100 nF0402 | 1

Перв. примен.

МПСУ.464342.21-001

Поз.
обозначение

Наименование
Кол. Примечание

Конденсаторы

Справ. №

Инв. № под

Подп. и дата

Подп. и дата Взам. инв.№Инв. № дуб

## МПСУ.464342.21-001ПЭ3

иления и фильтрации с детектир

Изм.Лист | Подп. | Дата

обозначение

Наименование

Конденсаторы

DA1-DA3 | Analog Devices | 3
DA4,DA5 | PMA-183PLN+Mini-Circuits | 2
DA6 | LTC5597Analog Devices | 1
DD1 | PIC12F1822-I/SN | 1

Микросхемы

Кол. | Примечание
C28,C29 | OPT0402 | 2
C30 | 100 nF0402 | 1

Резисторы

Подп. и дата

R1 | 50 Ohm50 V5 W0603 | 1
R2 | 10 Ohm± 5%25V63 mW0402 | 1
R3 | 180 Ohm± 5%25V63 mW0402 | 1
R4 | 10 Ohm± 5%25V63 mW0402 | 1
R5 | 180 Ohm± 5%25V63 mW0402 | 1
R6 | OPT± 5%25 V63 mW0402 | 1
R7 | 2 kOhm± 5%25 V63 mW0402 | 1
R8 | 3 kOhm± 5%25 V63 mW0402 | 1
R9 | 1 Ohm± 5%25 V63 mW0402 | 1
R10 | 100 Ohm± 5%25 V63 mW0402 | 1
R11 | OPT± 5%25 V63 mW0402 | 1
R12 | 1 Ohm± 5%25 V63 mW0402 | 1
R13 | 1 Ohm0402 | 1

Инв. № дуб

№ докум.

## МПСУ.464342.21-001ПЭ3 2

Подп. и дата Взам. инв.№

Инв. № подл.

Лист

Изм.Лист | Подп. | Дата

обозначение

Наименование

Переключатели

Кол. | Примечание
S1 | L-KLS7-TS6604-4.3-180-BKLS electronic co ltd | 1
| Розетки
XS1 | XT-60-PW-F | 1
XS2 | PBD-2 2x1 | 1

Соединители выскочастотные

XW1,XW2 | SMA862A1-0000 | 2

Подп. и дата Инв. № дуб

№ докум.

## МПСУ.464342.21-001ПЭ3 3

Подп. и дата Взам. инв.№ Инв. № подл.

Лист

Формат
Кол.

А4,

Подп. Дата

Взам. инв. №Инв. № дуб Подп. и дата

Примечание

Перв. примен.

Зона
Обозначение | Наименование

1

Справ. №

3 | МПСУ.464342.21-005Д1 | Данные проектирования
| МПСУ.464342.21-005Т5М | Данные конструирования
4
5
6 | | Материалы
7
8 | | Rogers RO4350B 0.508мм
9 | | (фольга 0.18мм)
10
11

МПСУ.464342.21-005СБ
2

12

№ докум.

| | МПСУ.464342.21-001
Разраб. | Лазба | | и фильтрации с детектированием мощности | Лит. | Лист 1 Приемная ячейка усиления | Листов
Пров. | Приходько
ЗамДир | Лялин
Н. контр

Изм.Лист

Подп. и дата Инв. № подл

Документация

Сборочный чертеж

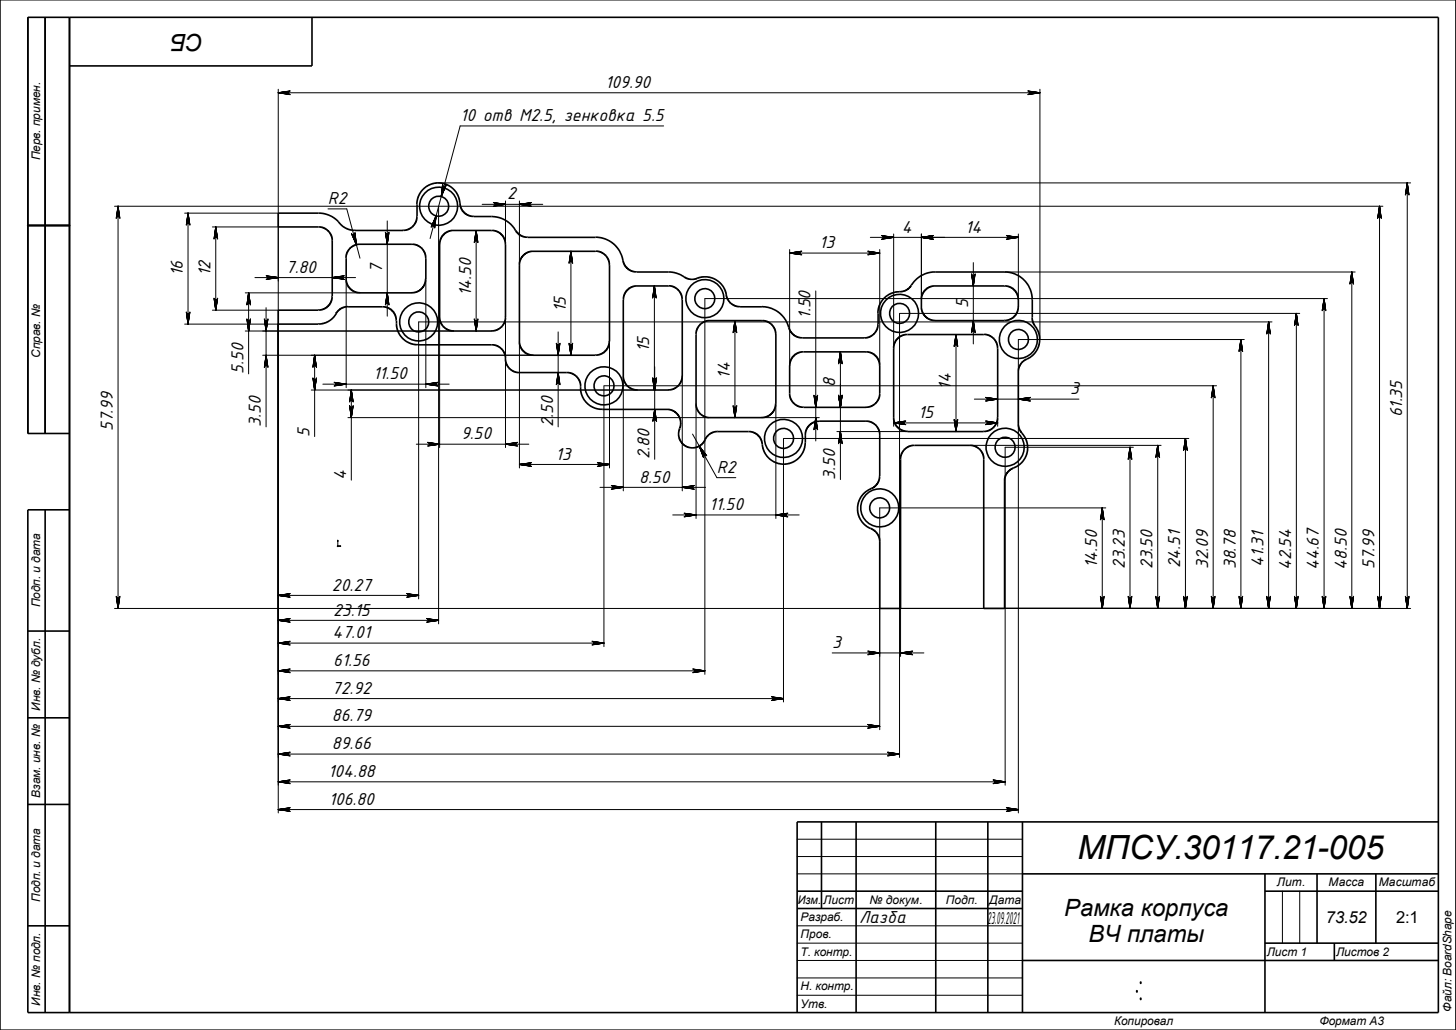
[picture p66: page 9]
Копировал; Формат А3; Н. контр.; Файл: BoardShape; 10 отв М2.5, зенковка 5.5

Справ. № Перв. примен. Подп. и дата Инв. № дубл. Взам. инв. № Подп. и дата Инв. № подл. Рамка корпуса ВЧ платы

МПСУ.30117.21-005

Лит. | Масса | Масштаб

Изм. | Лист | № докум. | Подп. | Дата | | | | | 73.52 2:1
Разраб. | | Лазба | | 23.09.2021
Пров.
Т. контр. | | | | | Лист 1 | Листов 2

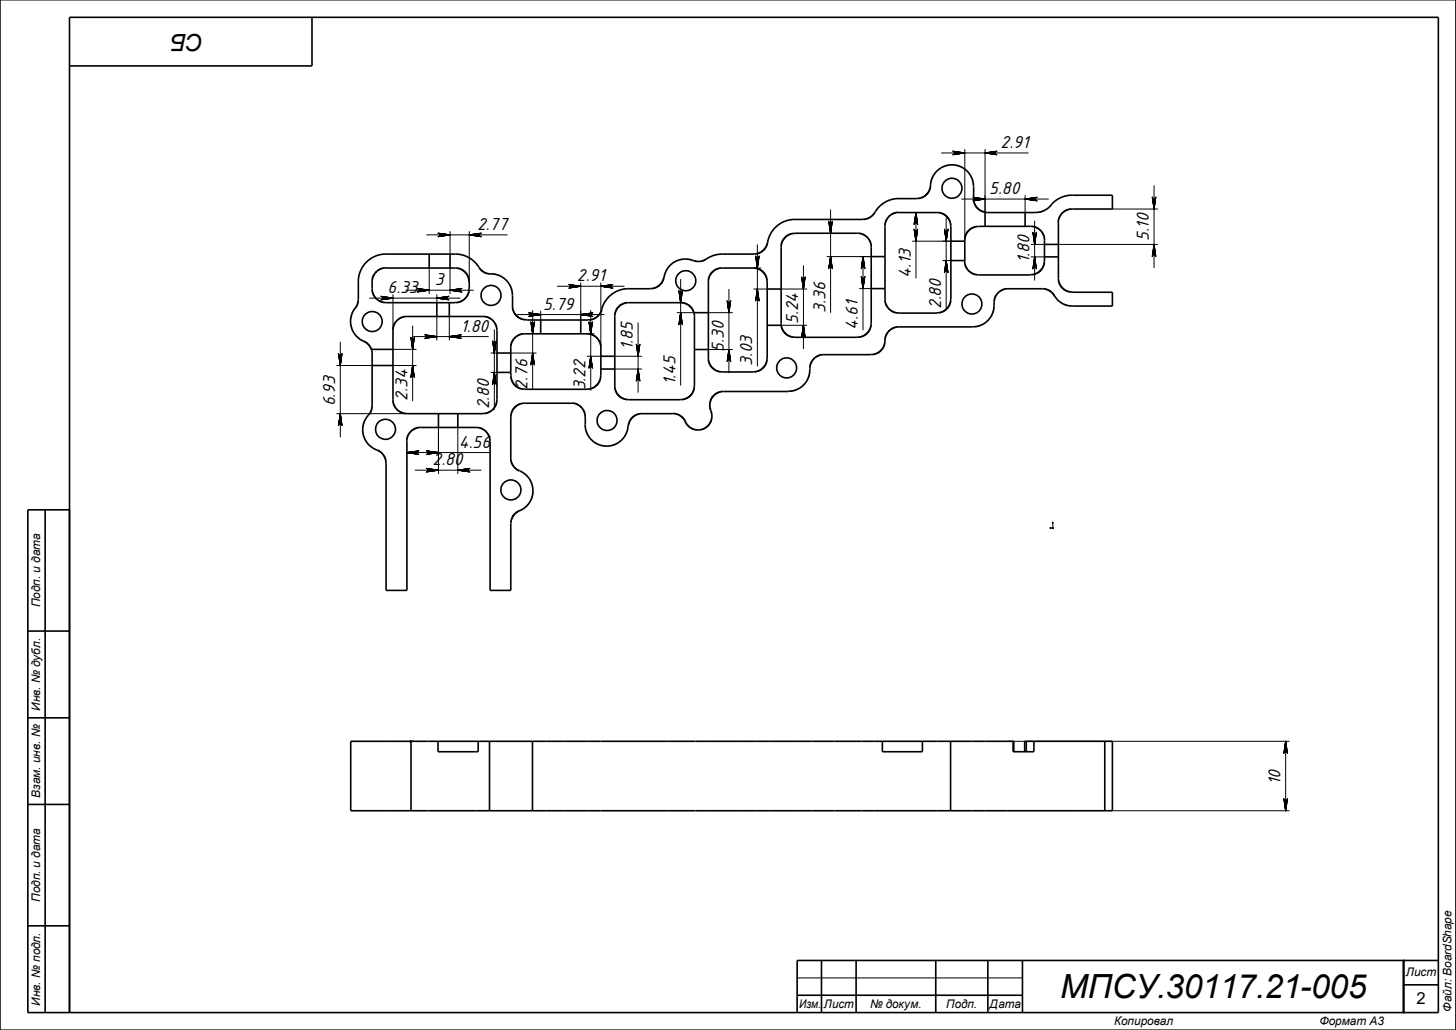
[picture p67: page 10]
п. и дата; Копировал; Лист; Формат А3; МПСУ.30117.21-005; Изм.; Файл: BoardShape

Инв. № подл. Подп. и дата Взам. инв. № Инв. № дубл. Под № докум. Подп. Дата
