lazbaphilipp/ADS_HW/images/Documentation/MPSU.464342.21-005E3_2.pdf

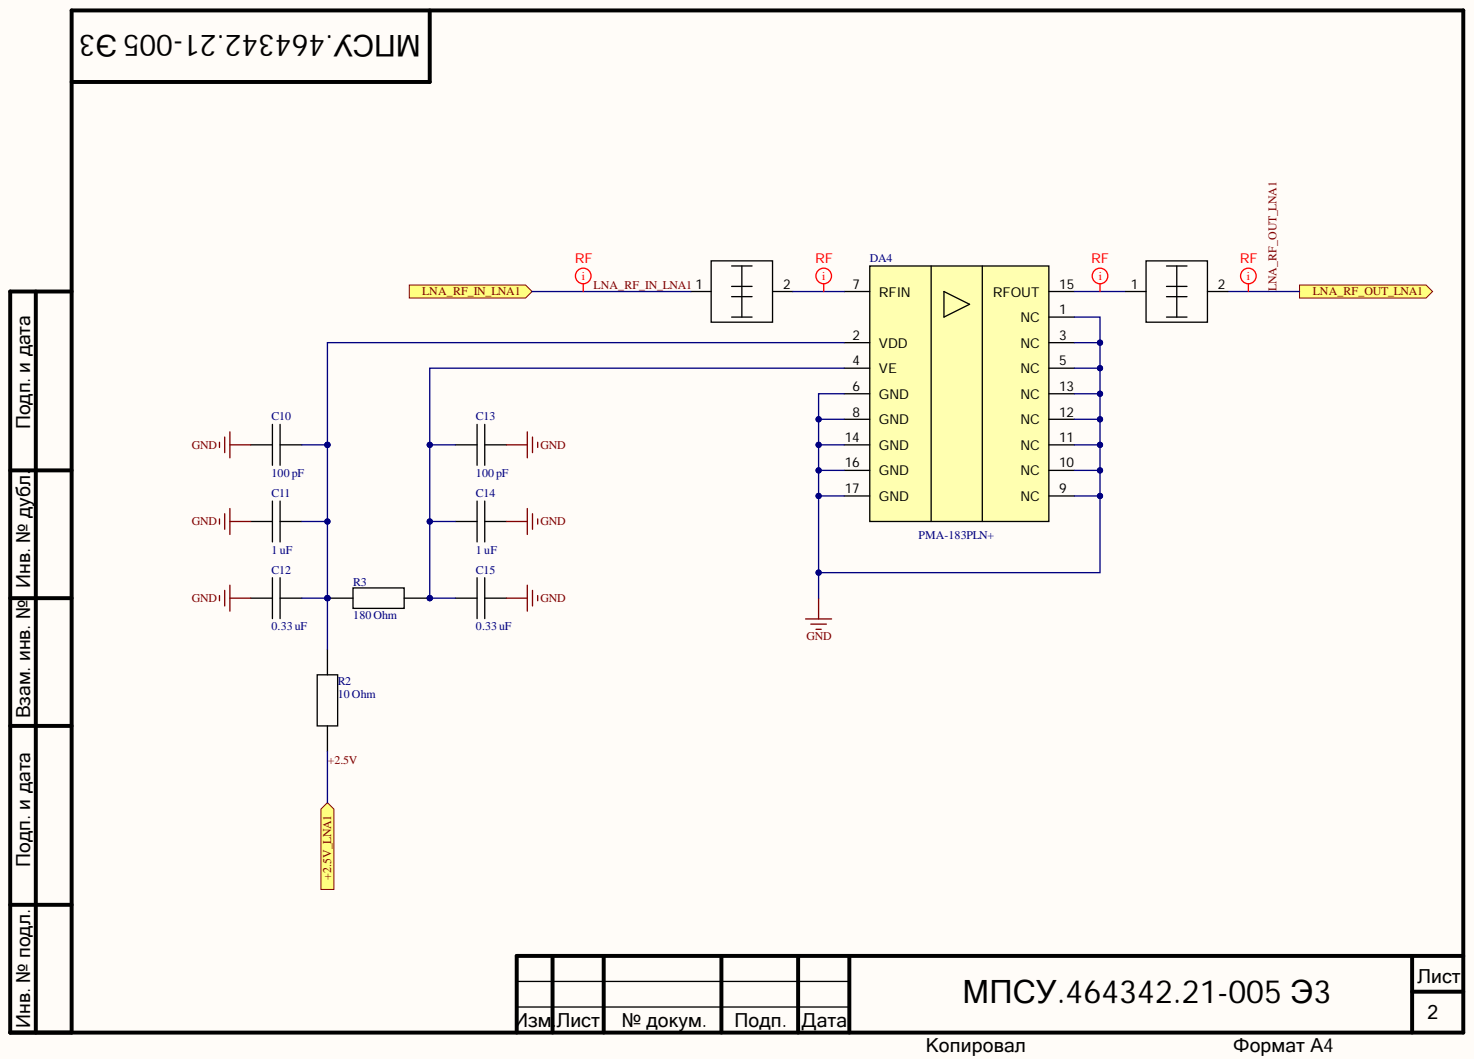
[picture p68: page 1]

Инв. № подл. Инв. № дубл. Подп. и дата Взам. инв. № Подп. и дата

# NLLNA0RF0OUT POLNA0RF0OUT

# NLLNA0RF0OUT POLNA0RF0OUT

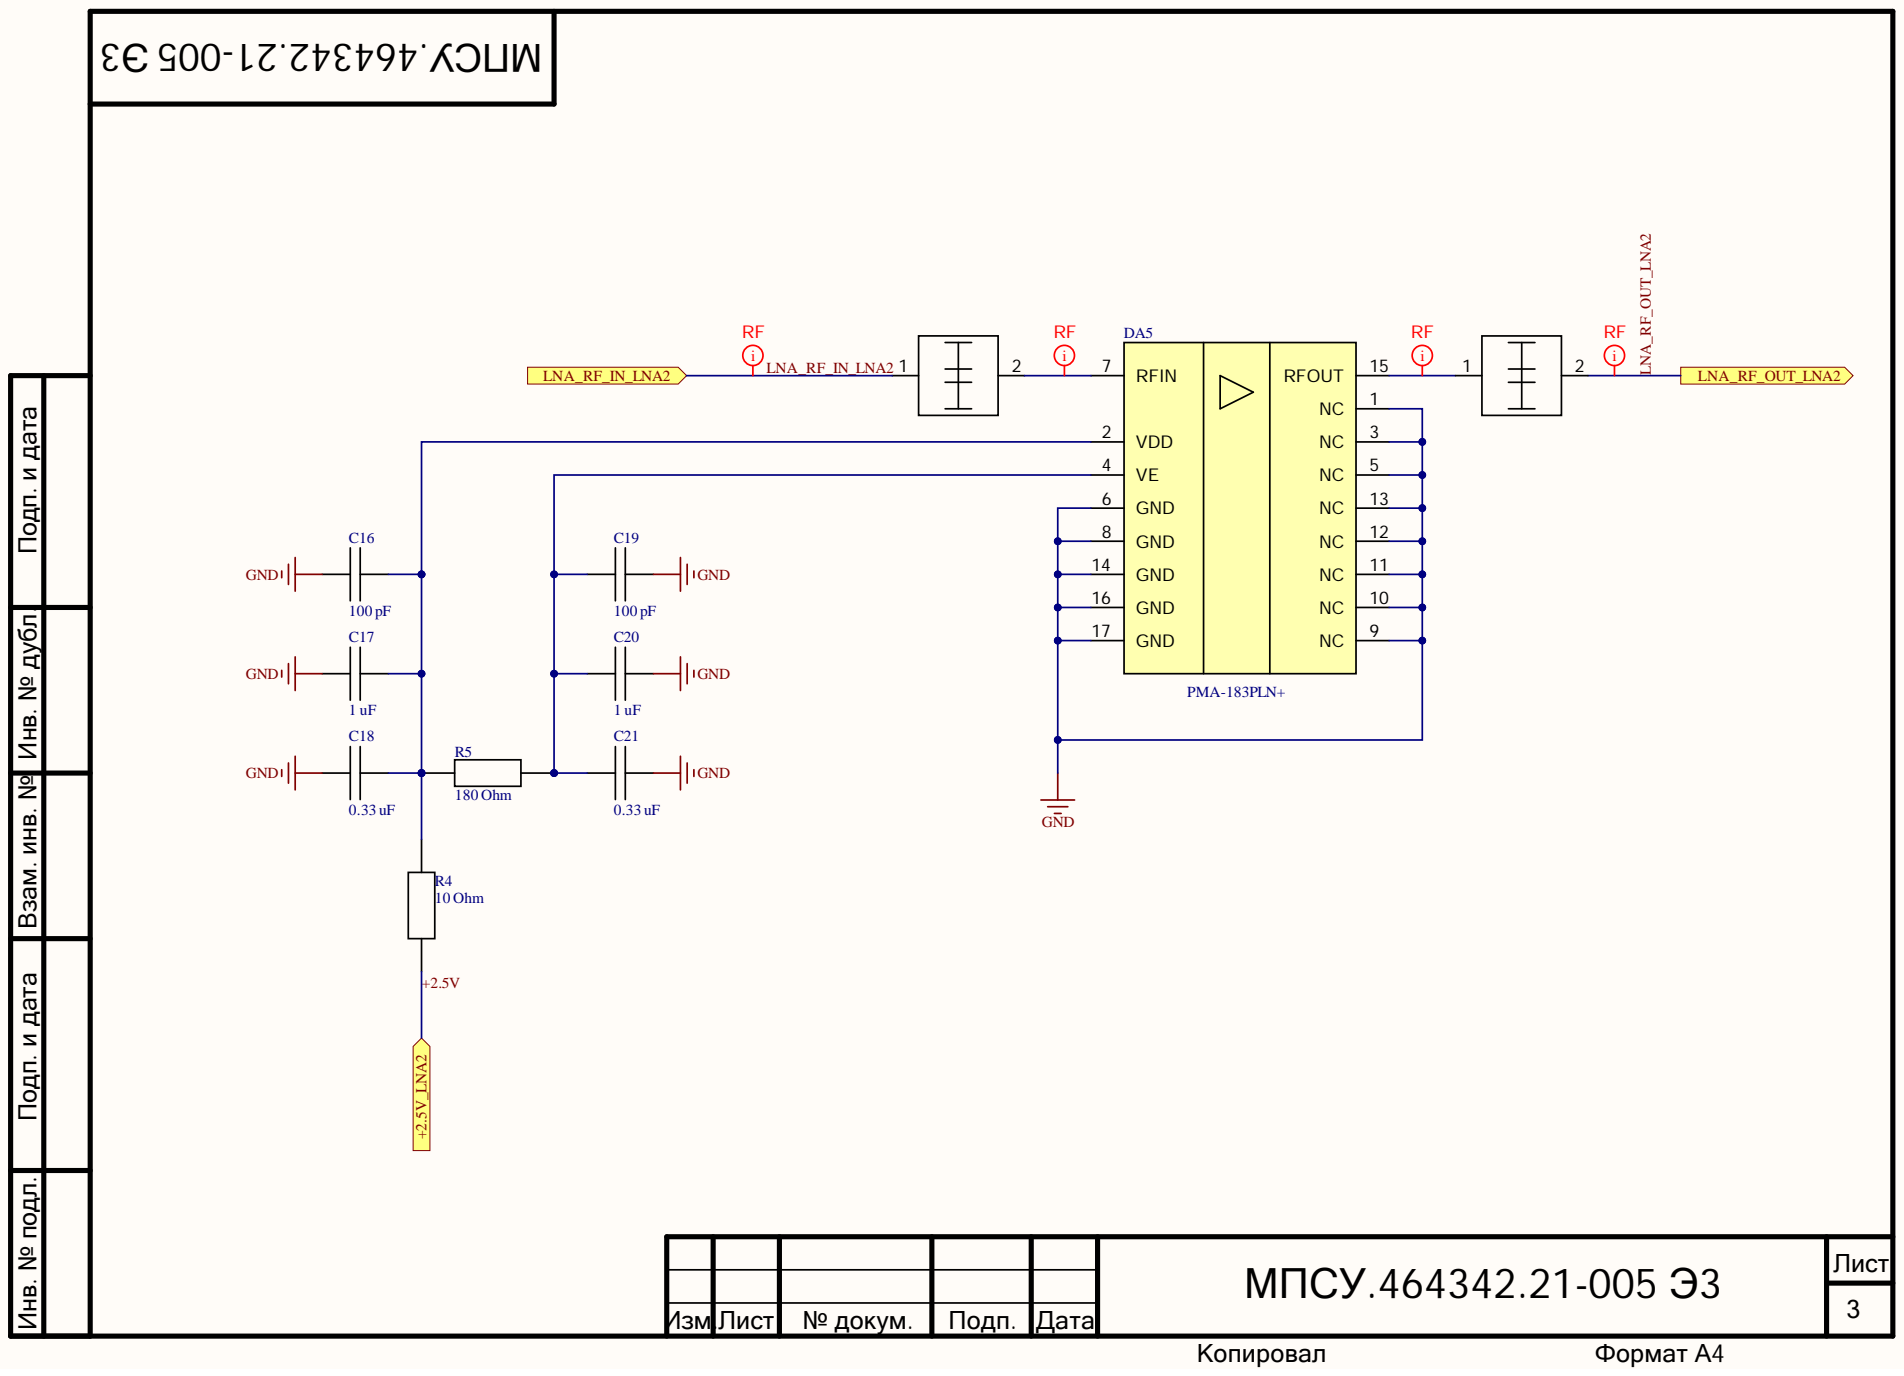
[picture p69: page 2]

Инв. № подл. Инв. № дубл. Подп. и дата Взам. инв. № Подп. и дата

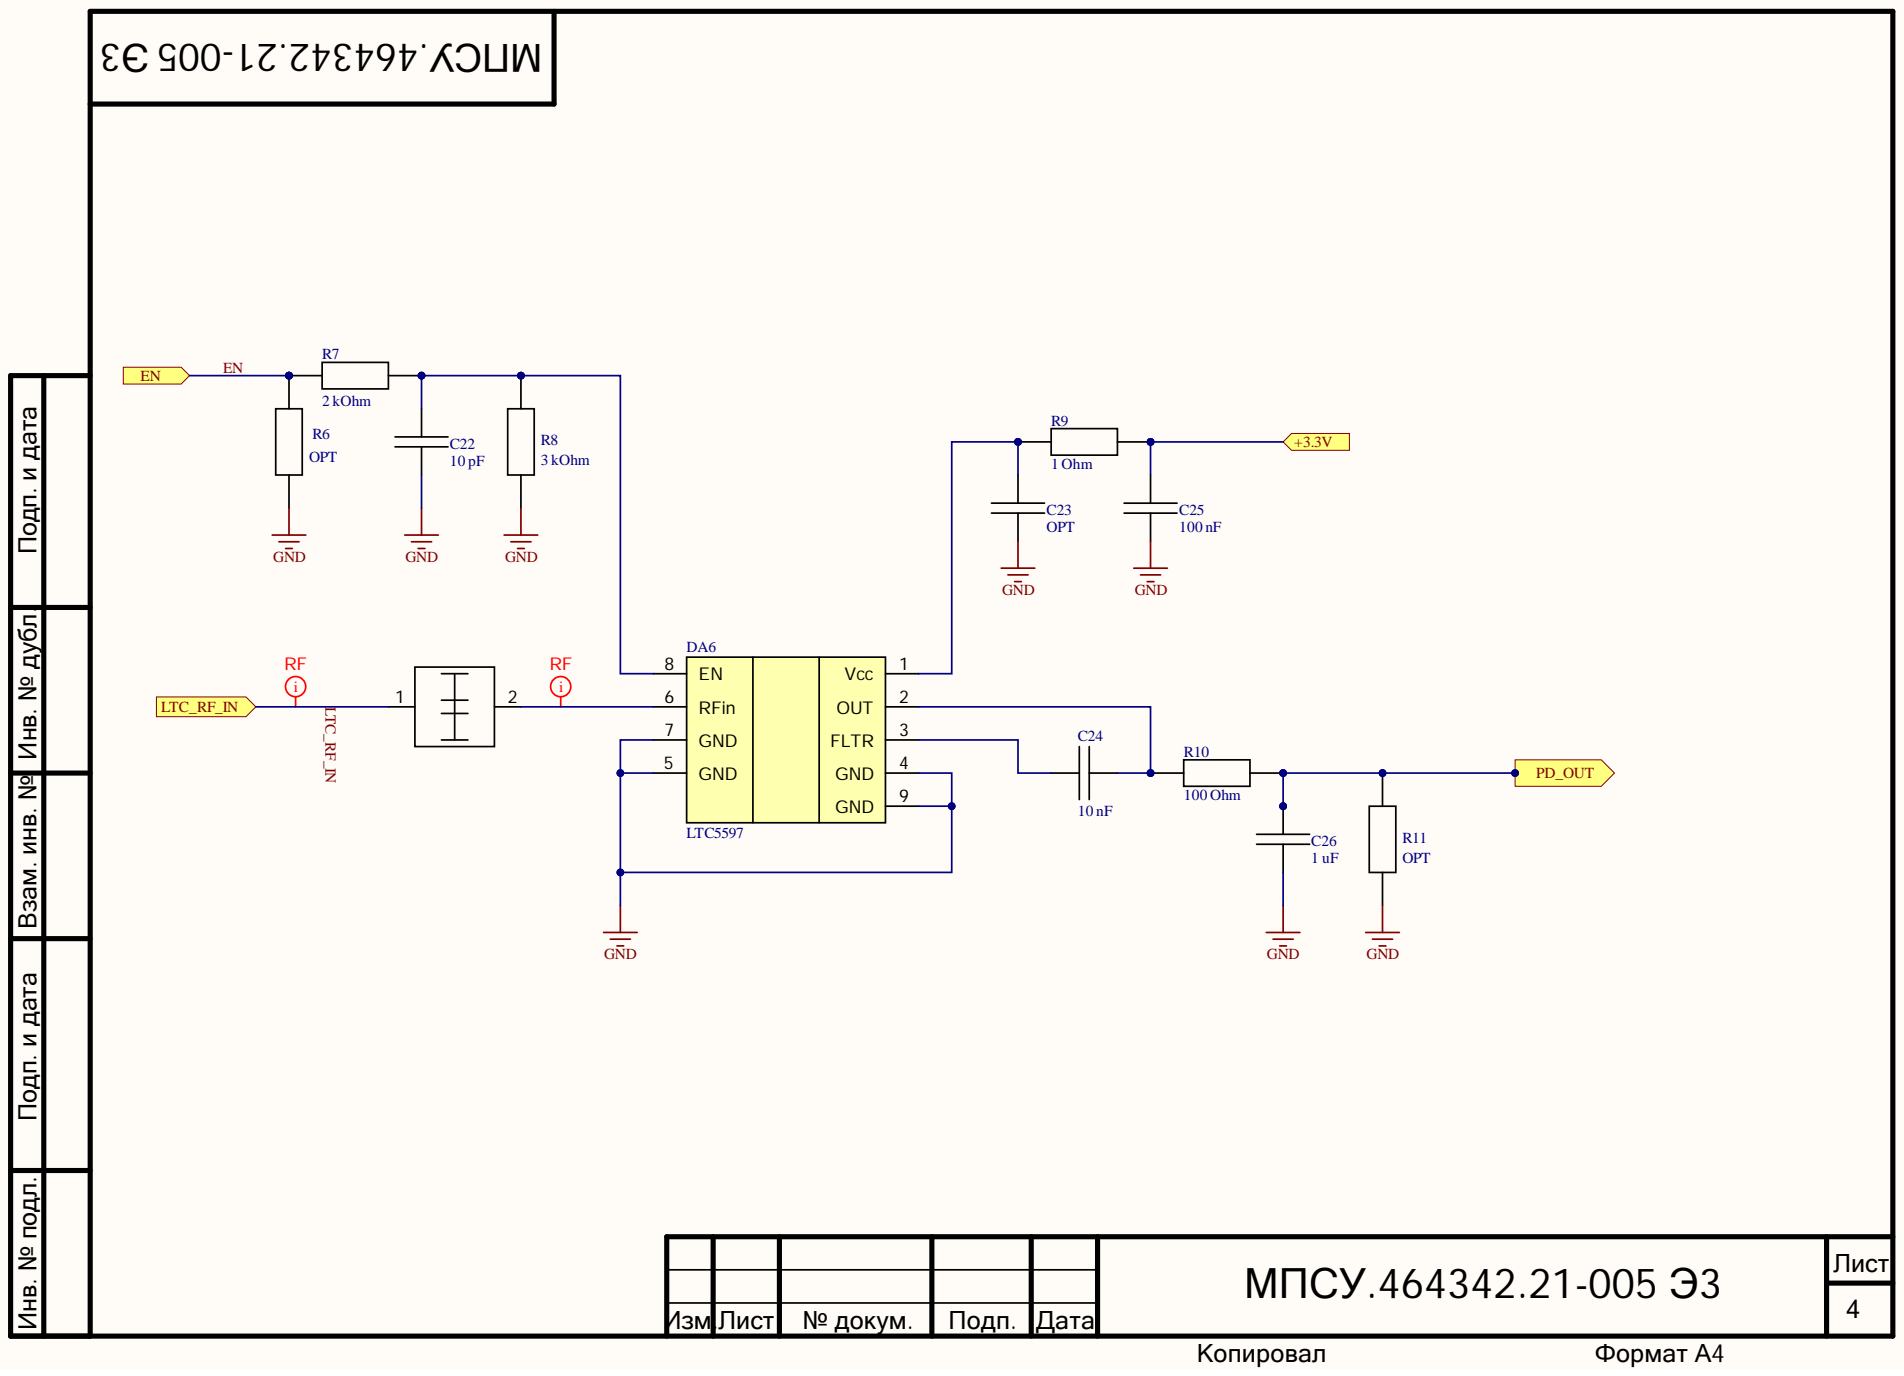
[picture p70: page 3]

Инв. № подл. Инв. № дубл. Подп. и дата Взам. инв. № Подп. и дата

МПСУ.464342.21-005 Э | Лист 4

Изм | .Лист | № докум . | Подп . | Дата

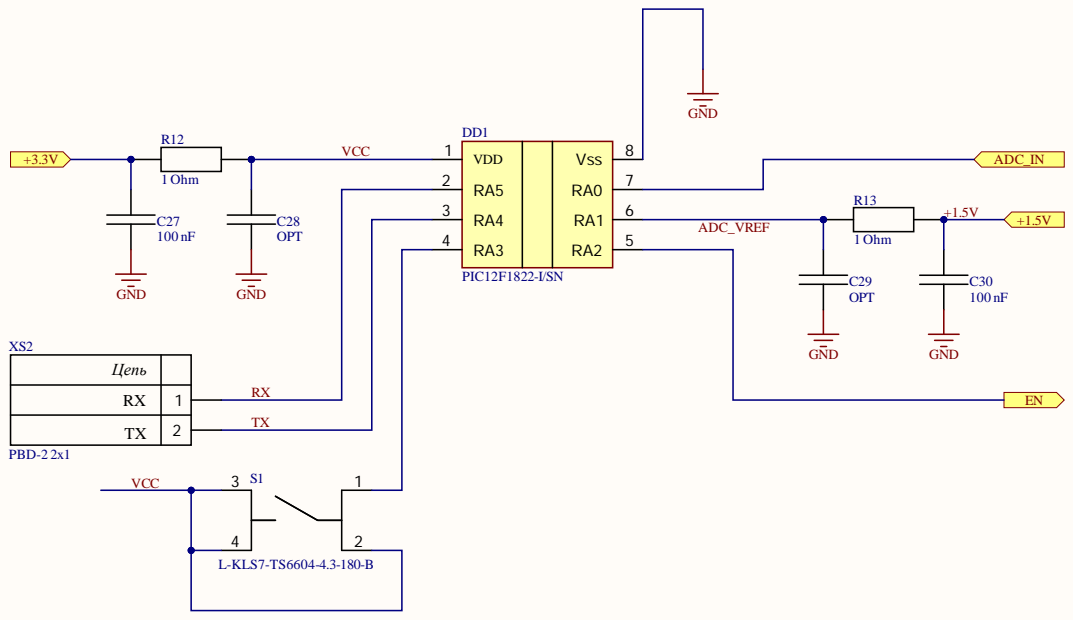
[picture p71: page 4]
Лист; 1 Ohm; GND; C28 OPT; L-KLS7-TS6604-4.3-180-B; VCC; VDD 1; Vss; PIC12F1822-I/SN; ADC_VREF; ADC_IN; C29 OPT; Цепь; PBD-2 2x1

Инв. № подл. Инв. № дубл. Подп. и дата Взам. инв. № Подп. и дата

i

RF

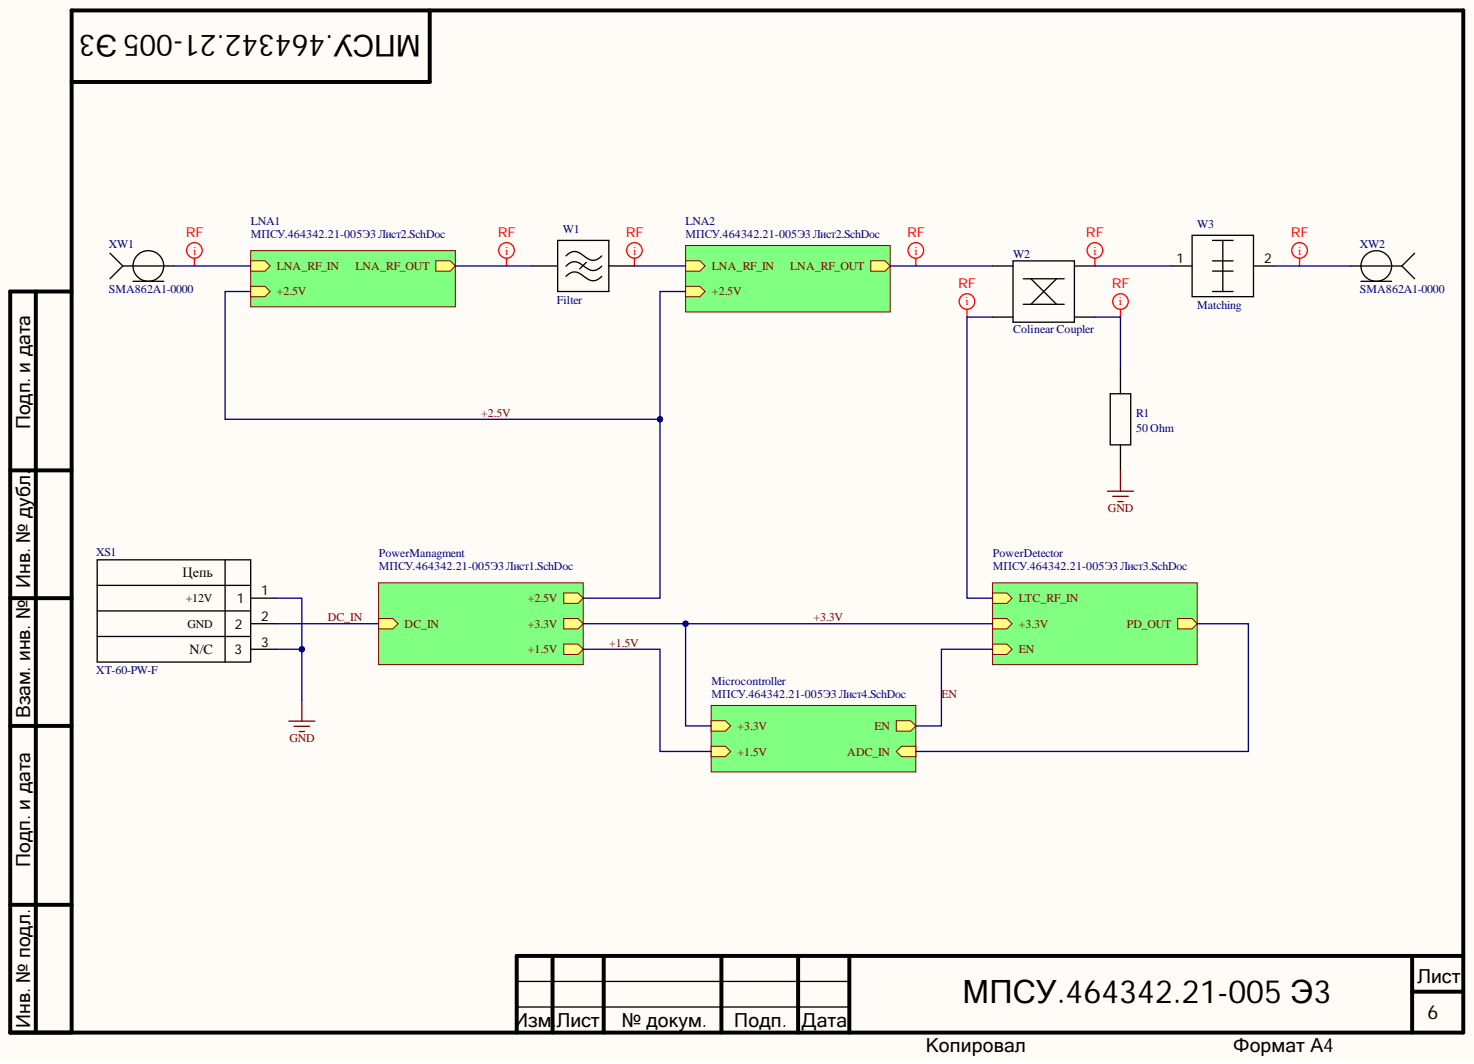
[picture p72: page 5]
Инв. № по; л. Инв. №; ата; м. инв. №; Лист; LNA_RF_IN; LNA_RF_OUT; LNA2 МПСУ.464342.21-005Э3Лист2.SchDoc; LNA1 МПСУ.464342.21-005Э3Лист2.SchDoc; PowerManagment МПСУ.464342.21-005Э3Лист1.SchDoc; Filter; ADC_IN; Microcontroller МПСУ.464342.21-005Э3Лист4.SchDoc; Цепь; GND; LTC_RF_IN; PD_OUT; PowerDetector МПСУ.464342.21-005Э3Лист3.SchDoc; Colinear Coupler; Matching i; R1 50 Ohm; SMA862A1-0000
