lazbaphilipp/ADS_HW/images/Documentation/MPSU.687254.21-005D1.pdf

A

A

1 | 1
Копировал | Формат А4

Приходько

1:1

Данные проектирования

Лазба

## МПСУ.687254.21-005Д1

Плата печатная многослойная

Лист | 1 | Листов | 2
Лит. | Масса | Масштаб

Утв.

Н. контр.

Т. контр.

Проверил

Подп. Дата
Разраб.

Изм. Лист № докум.
У

Перв. примен. Справ. № Подп. и дата Инв. № подл. Взам. инв. № Подп. и дата Инв. № подл.

МПСУ.687254.21-005

## МИЭТ

Зам. Дир. Лялин

Файл
Источник Altium Designer, Gerber Формат Gerber mm, 4:4, RS-274X Слой
Шелкогрфия верхнего слоя
Паяльная паста верхнего слоя Паяльная маска вернего слоя (негативный слой)
Металлизация верхнего слоя Металлизация нижнего слоя
Контур платы
Формат mm, 4:4
Описание отверстий
Сквозные металлизированные отверстия

МПСУ.464342.21-005T5M.zip

Имя файла
МПСУ.464342.21-005T5M.gto
МПСУ.464342.21-005T5M.gtp
МПСУ.464342.21-005T5M.gts

МПСУ.464342.21-005T5M.gtl
МПСУ.464342.21-005T5M.gbl
МПСУ.464342.21-005T5M.gm5

МПСУ.464342.21-005T5M.drr
МПСУ.464342.21-005T5M-Plated.TXT

Данные для производства

## Приложение В. МПСУ.687254.21-005Д1

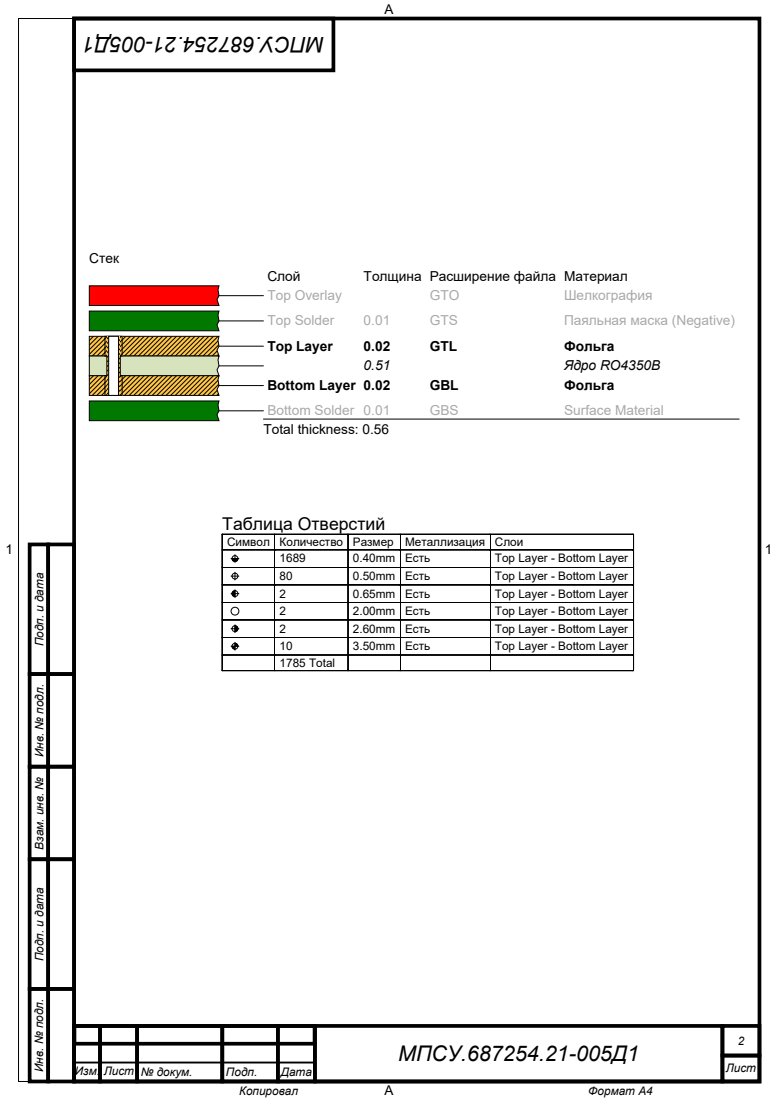
[picture p73: page 2]
Изм. Лист № докум.; Подп.; Дата; Лист; МПСУ.687254.21-005Д1; Копировал; Формат А4; Таблица Отверстий; Слой; Толщина Расширение файла Материал; Top Overlay; GTO; Шелкография; Top Solder; GTS; Паяльная маска (Negative); Top Layer; GTL; Фольга; Ядро RO4350B; Bottom Layer 0.02; GBL; Bottom Solder 0.01; GBS; Surface Material; Total thickness: 0.56; Стек

Символ | Количество | Размер | Металлизация | Слои

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

Подп. и дата Инв. № подл. Взам. инв. № Подп. и дата Инв. № подл.
