lazbaphilipp/ADS_HW/images/Documentation/MPSU.687254.21-005SB.pdf

# 10 отв Ø3.50mm²⁵.04mm ²⁵.48mm 32.62mm ³⁸.81mm

# Приложение Б. МПСУ.687254.21-005СБ

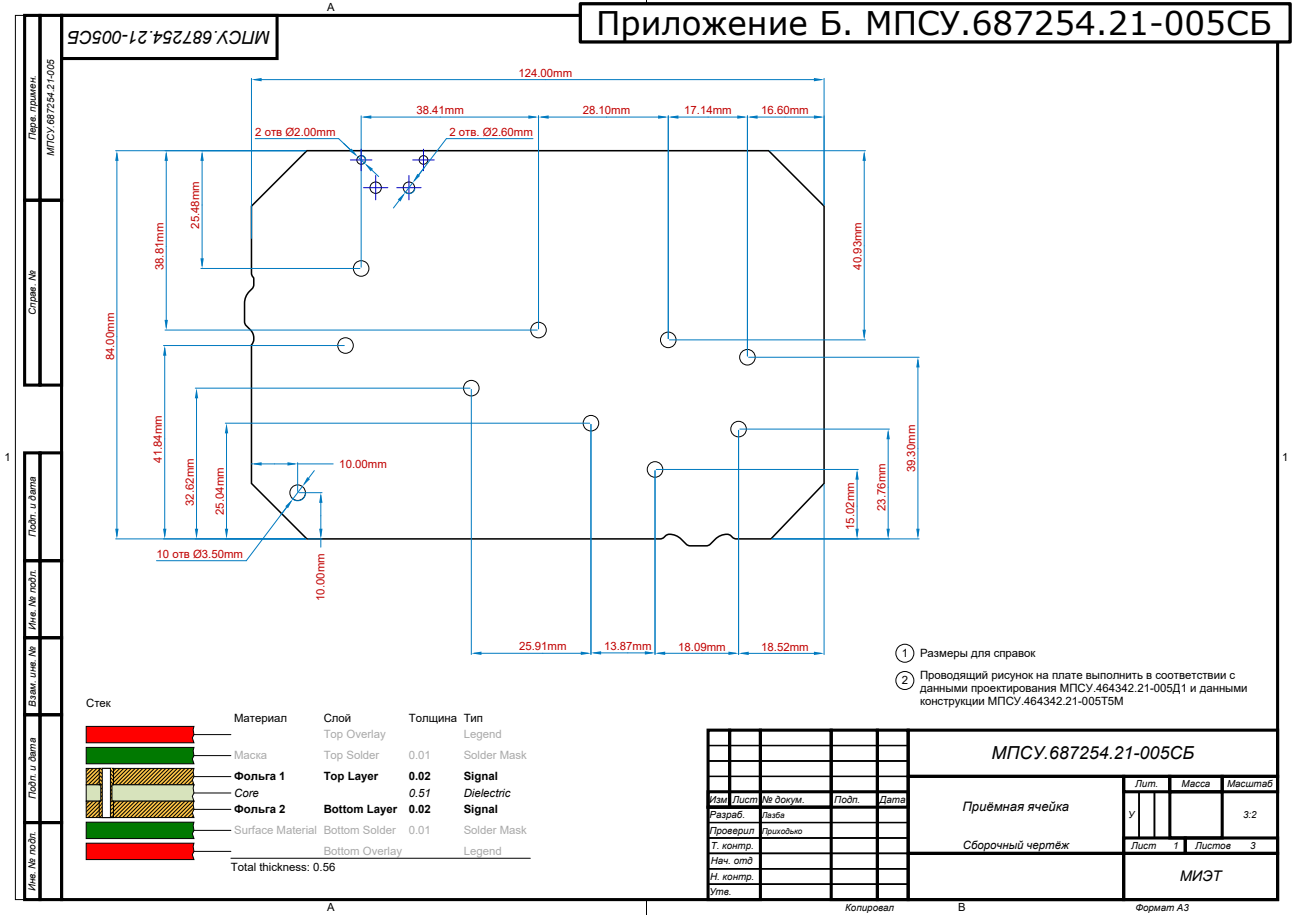
[picture p74: page 1]
Изм. Лист № докум. Разраб.; Подп.; Дата; Проверил Т. контр.; Н. контр. Утв.; Лит.; Масса; Масштаб; Лист; Листов 1; Приёмная ячейка; МПСУ.687254.21-005СБ; Лазба; Сборочный чертёж; Приходько; Копировал; Формат А3; МИЭТ; Нач. отд; МПСУ.687254.21-005; 2 отв Ø2.00mm; 2 отв. Ø2.60mm; Материал; Слой; Толщина Тип; Top Overlay; Legend; Маска; Top Solder; Solder Mask; Фольга 1; Top Layer; Signal; Core; Dielectric; Фольга 2; Bottom Layer 0.02; Surface Material Bottom Solder 0.01; Bottom Overlay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

Перв. примен. Справ. № Подп. и дата Инв. № подл. Взам. инв. № Подп. и дата Инв. № подл.

1 Размеры для справок
Проводящий рисунок на плате выполнить в соответствии с
данными проектирования МПСУ.464342.21-005Д1 и данными
конструкции МПСУ.464342.21-005Т5М

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

Подп. и дата Инв. № подл. Взам. инв. № Подп. и дата Инв. № подл.

## Карта сверловки

МПСУ.687254.21-005СБ; Изм. Лист № докум.; Подп.; Дата; Лист; Таблица Отверстий

Символ | Количество | Размер | Металлизация | Слои

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

Подп. и дата Инв. № подл. Взам. инв. № Подп. и дата Инв. № подл.
