lazbaphilipp/ADS_HW/images/system_modeling/SystemSch.pdf

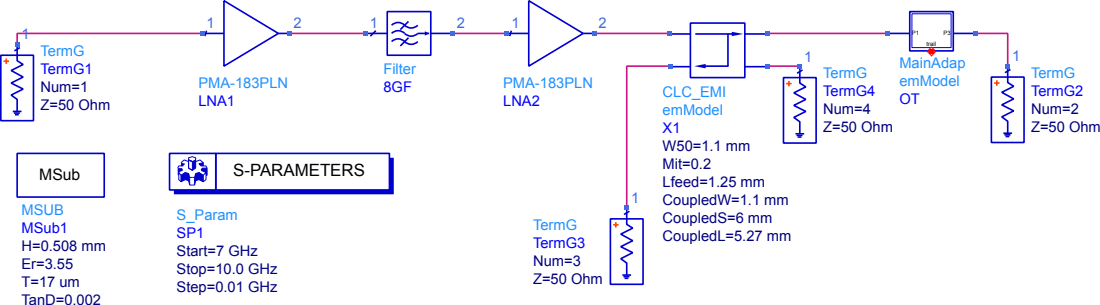
[picture p75: page 1]
MSub; S-PARAMETERS; trail; emModel; MSUB; S_Param; TermG; Filter; CLC_EMI; TermG PMA-183PLN; MSub1; TermG4 LNA2; TermG2; TermG1; TermG3; LNA1; TanD=0.002; Step=0.01 GHz; Stop=10.0 GHz; Start=7 GHz; Z=50 Ohm; Num=4; Num=1; CoupledL=5.27 mm; CoupledS=6 mm; Mit=0.2 Lfeed=1.25 mm CoupledW=1.1 mm; Num=3; Num=2

MainAdap TermG PMA-183PLN
