lazbaphilipp/ADS_HW/images/Altium-Components/PM_PCB_View.pdf

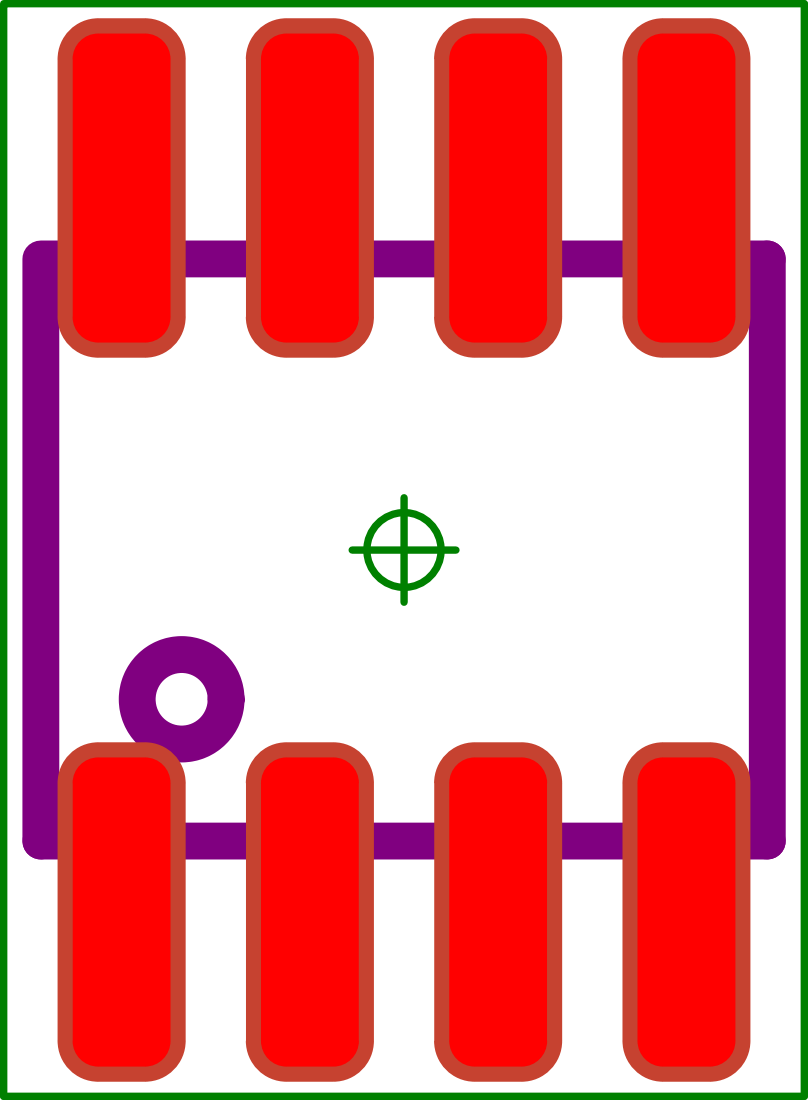
[picture p76: page 1]
