lazbaphilipp/ADS_HW/images/Altium-Schematic/LNA_SchDoc.pdf

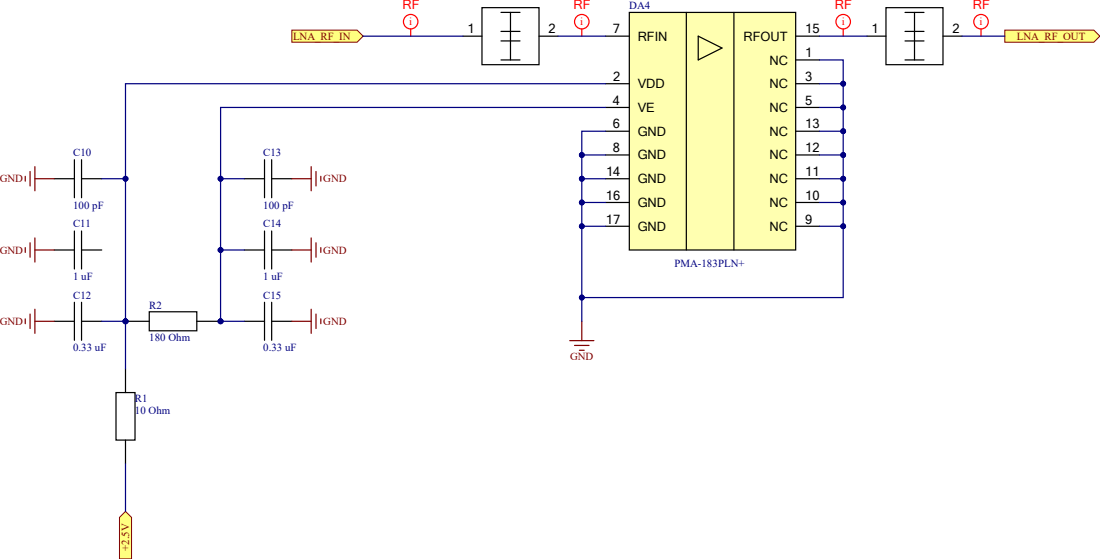
[picture p77: page 1]
