lazbaphilipp/ADS_HW/images/Altium-Schematic/PD_SchDoc.pdf

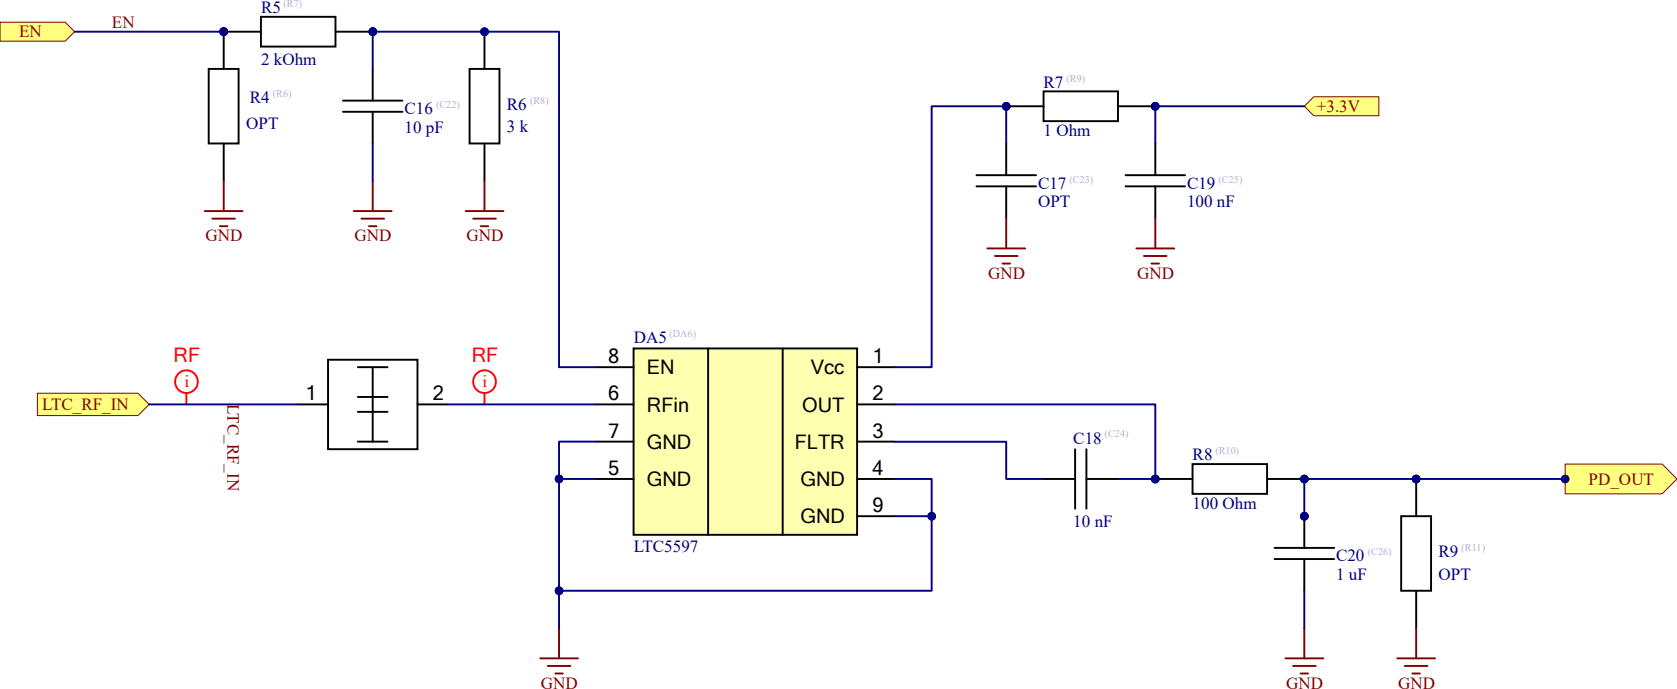
[picture p78: page 1]
