lazbaphilipp/ADS_HW/images/Altium-Schematic/PM_SchDoc.pdf

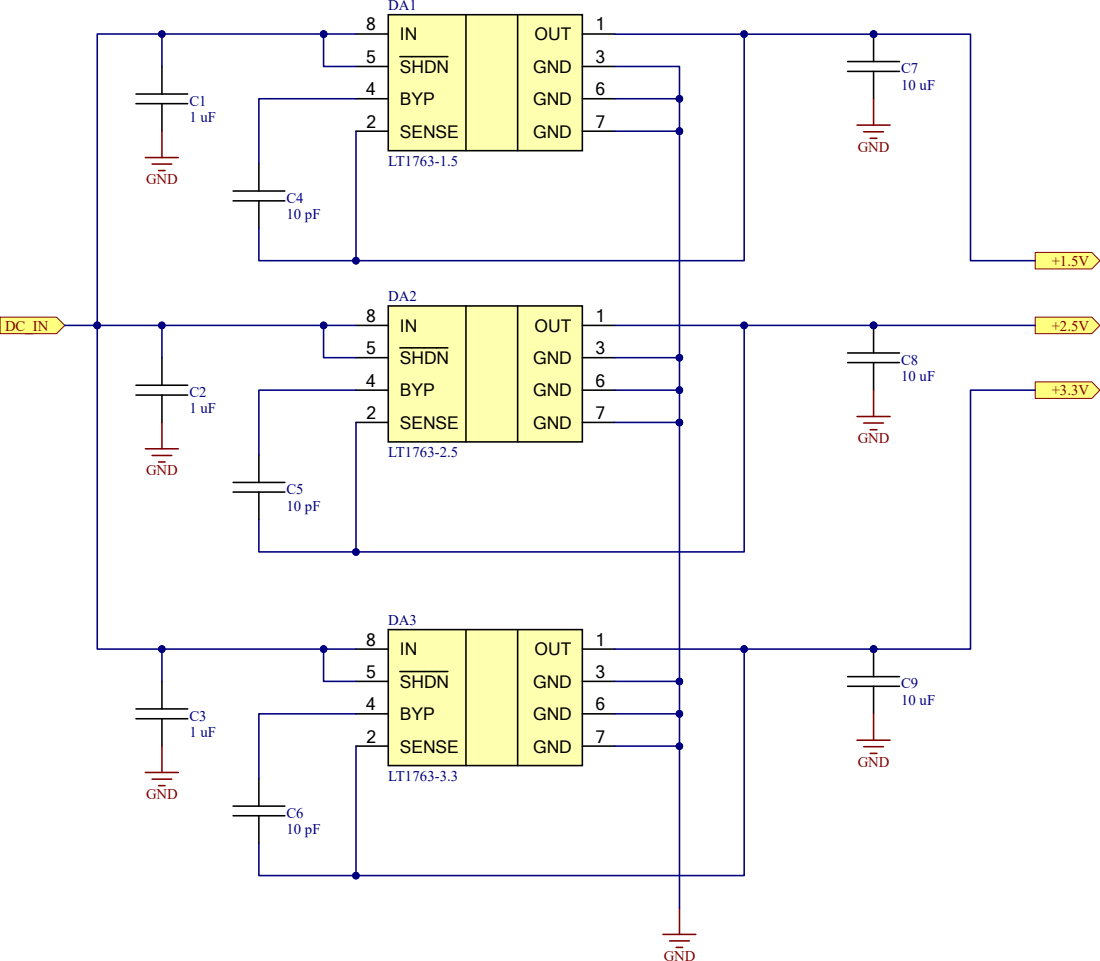
[picture p79: page 1]
