lazbaphilipp/ADS_HW/images/component_search/PMA-Case.pdf

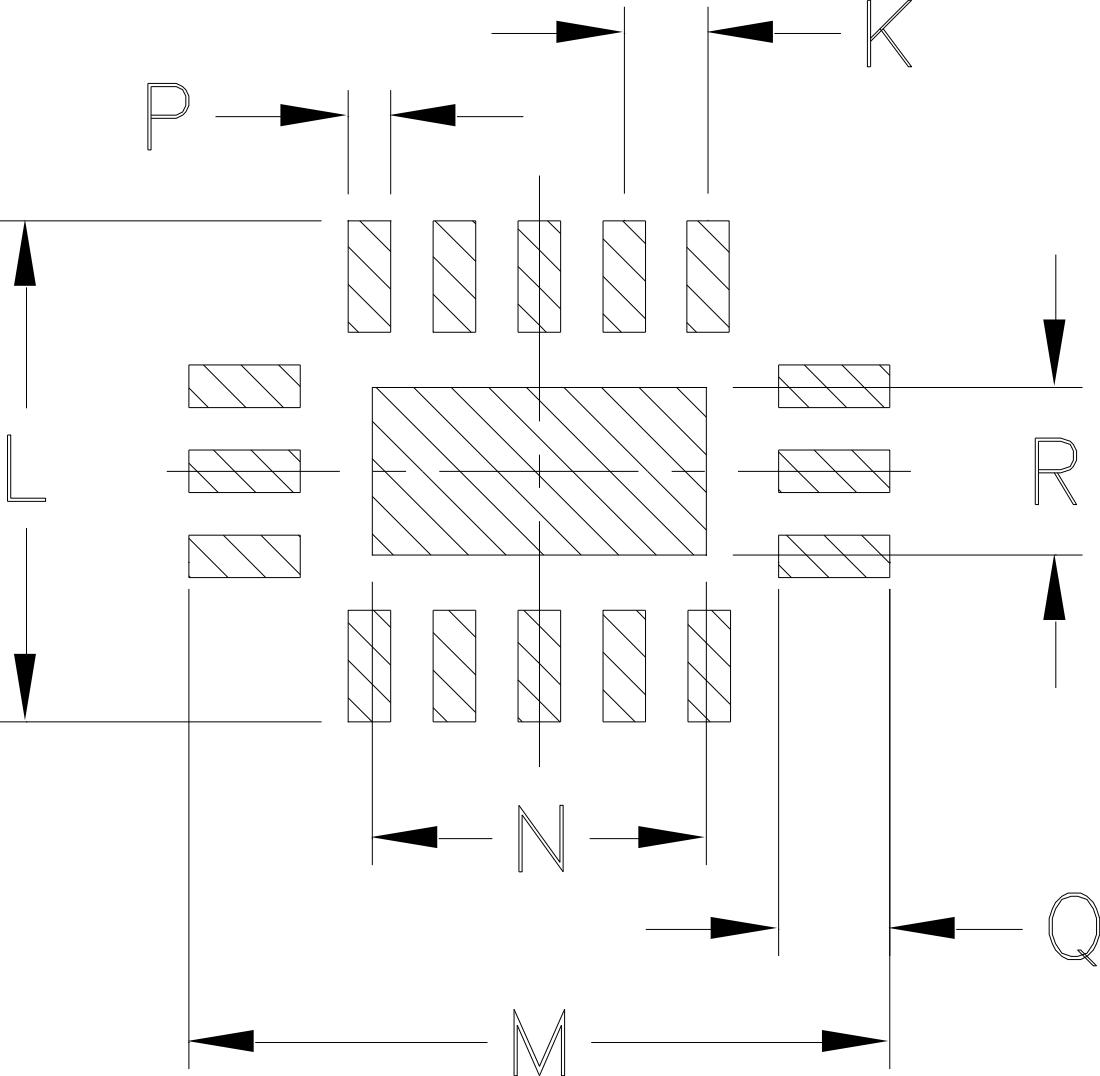
[picture p80: page 1]
