lazbaphilipp/ADS_HW/images/parts_design/CLC_Layout.pdf

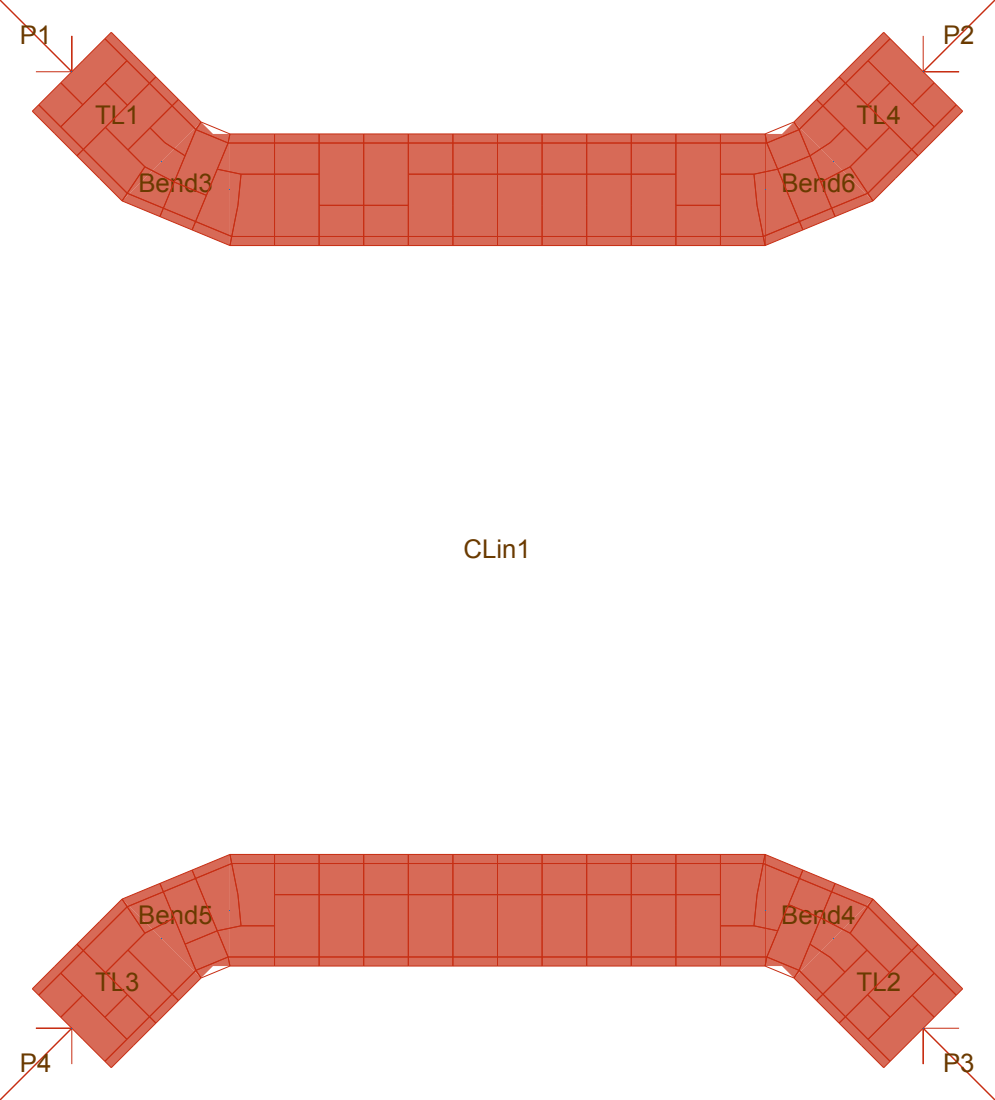
[picture p81: page 1]
Bend4; Bend6; Bend5; Bend3; CLin1
