lazbaphilipp/ADS_HW/images/parts_design/CLC_Response.pdf

m1

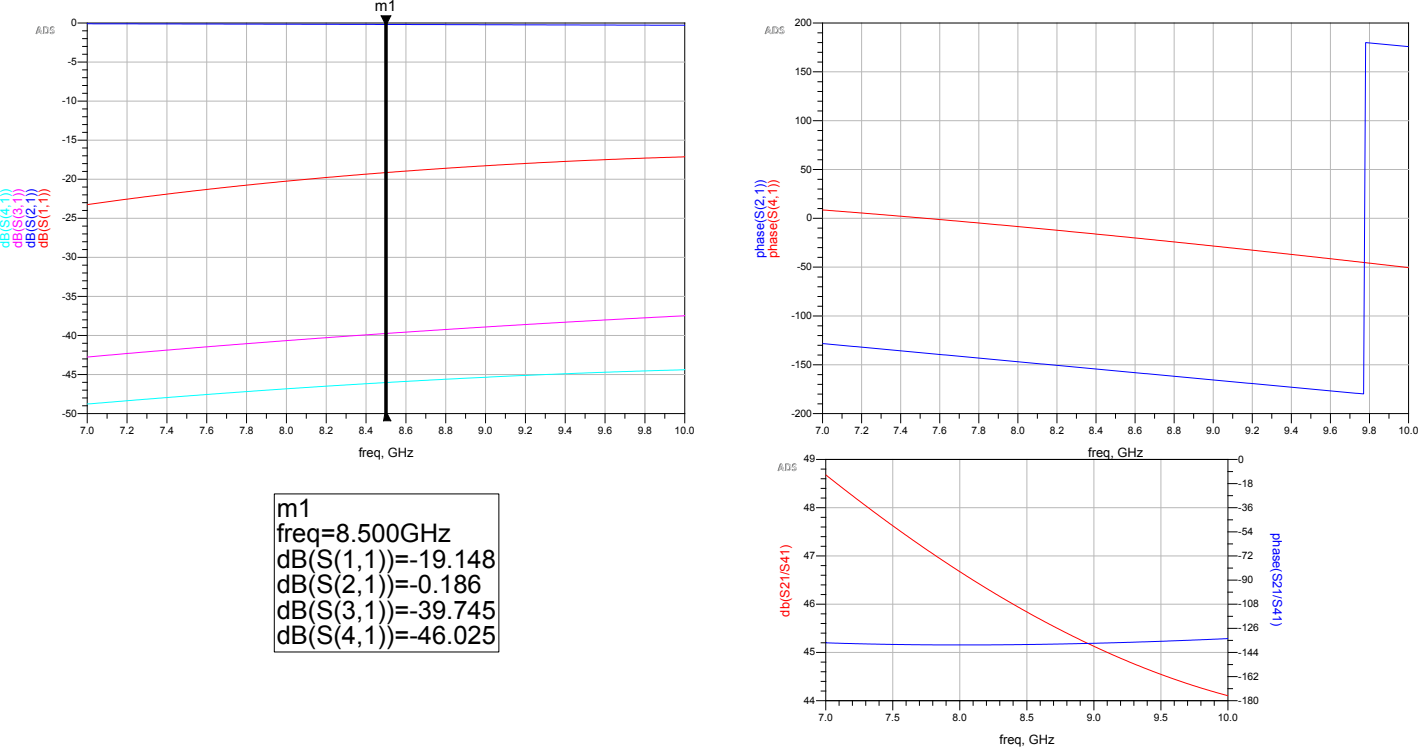
[picture p82: page 1]
freq, GHz; phase(S(2,1)); phase(S(4,1)); m1 freq= dB(S(1,1))=-19.148 dB(S(2,1))=-0.186 dB(S(3,1))=-39.745 dB(S(4,1))=-46.025; 8.500GHz; phase(S21/S41)
