lazbaphilipp/ADS_HW/images/parts_design/FilterResponse.pdf

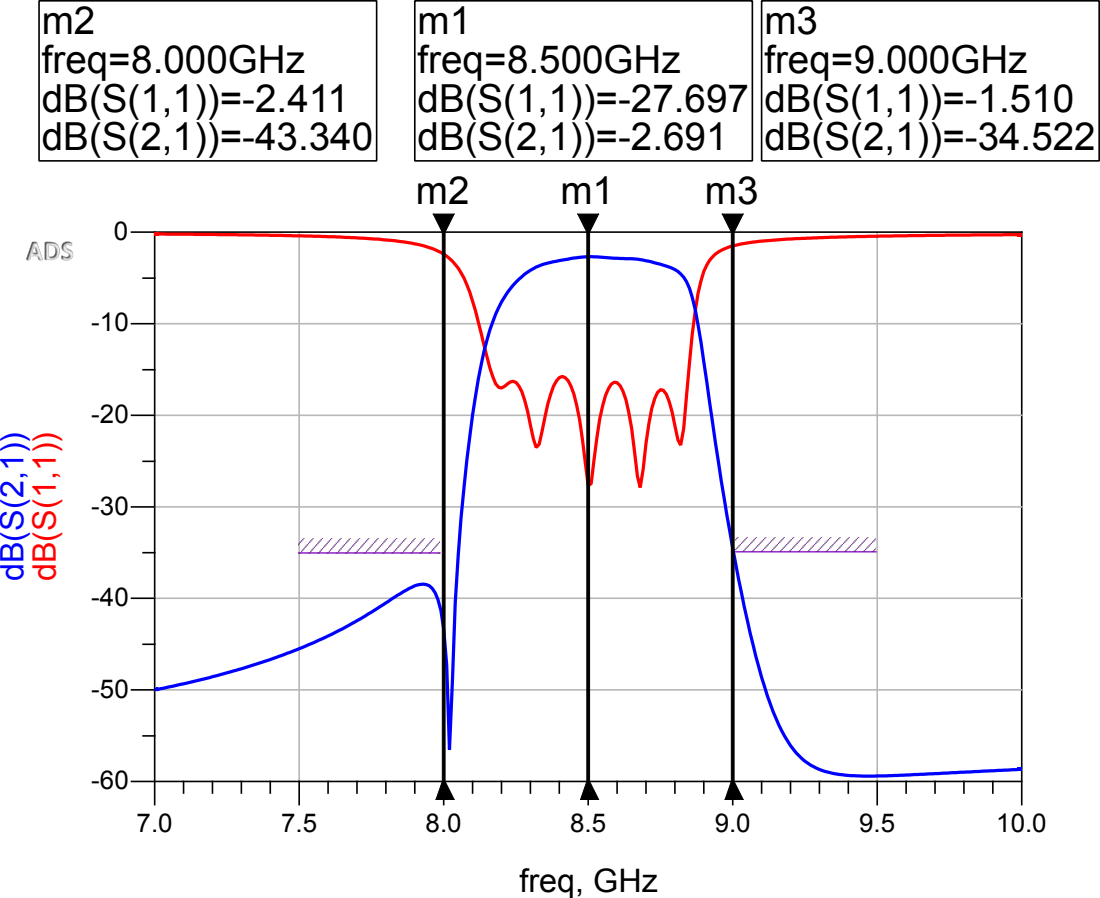
[picture p83: page 1]
freq, GHz; m1 freq= dB(S(1,1))=-27.697 dB(S(2,1))=-2.691; 8.500GHz; m2 freq= dB(S(1,1))=-2.411 dB(S(2,1))=-43.340; 8.000GHz; m3 freq= dB(S(1,1))=-1.510 dB(S(2,1))=-34.522; 9.000GHz
