lazbaphilipp/ADS_HW/images/parts_design/LNA_Response.pdf

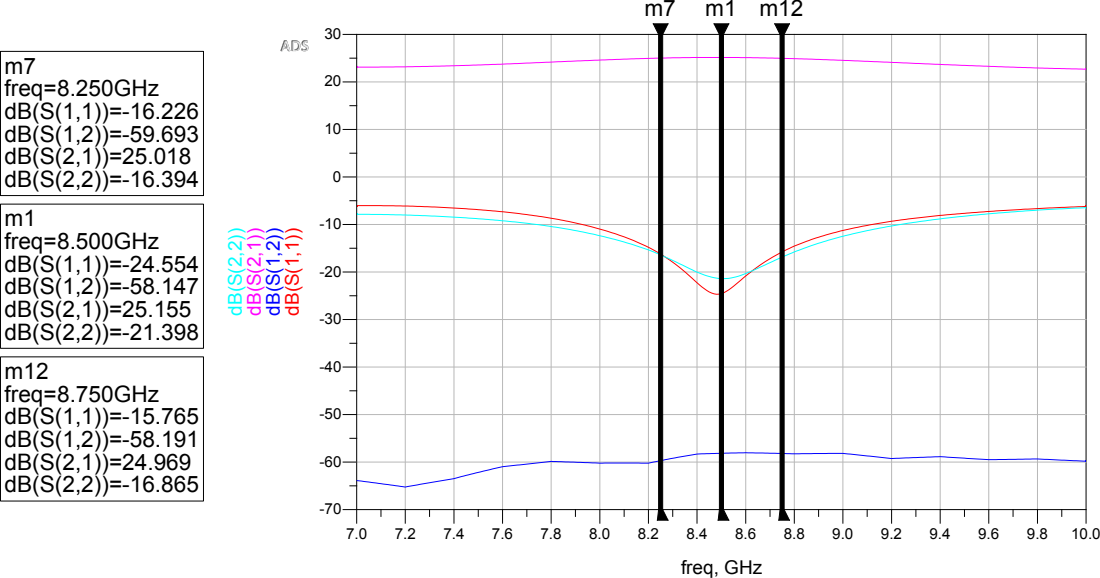
[picture p84: page 1]
freq, GHz; m1 freq= dB(S(1,1))=-24.554 dB(S(1,2))=-58.147 dB(S(2,1))=25.155 dB(S(2,2))=-21.398; 8.500GHz; m7 freq= dB(S(1,1))=-16.226 dB(S(1,2))=-59.693 dB(S(2,1))=25.018 dB(S(2,2))=-16.394; 8.250GHz; m12 freq= dB(S(1,1))=-15.765 dB(S(1,2))=-58.191 dB(S(2,1))=24.969 dB(S(2,2))=-16.865; 8.750GHz
