lazbaphilipp/ADS_HW/images/parts_design/LNA_Response_Full.pdf

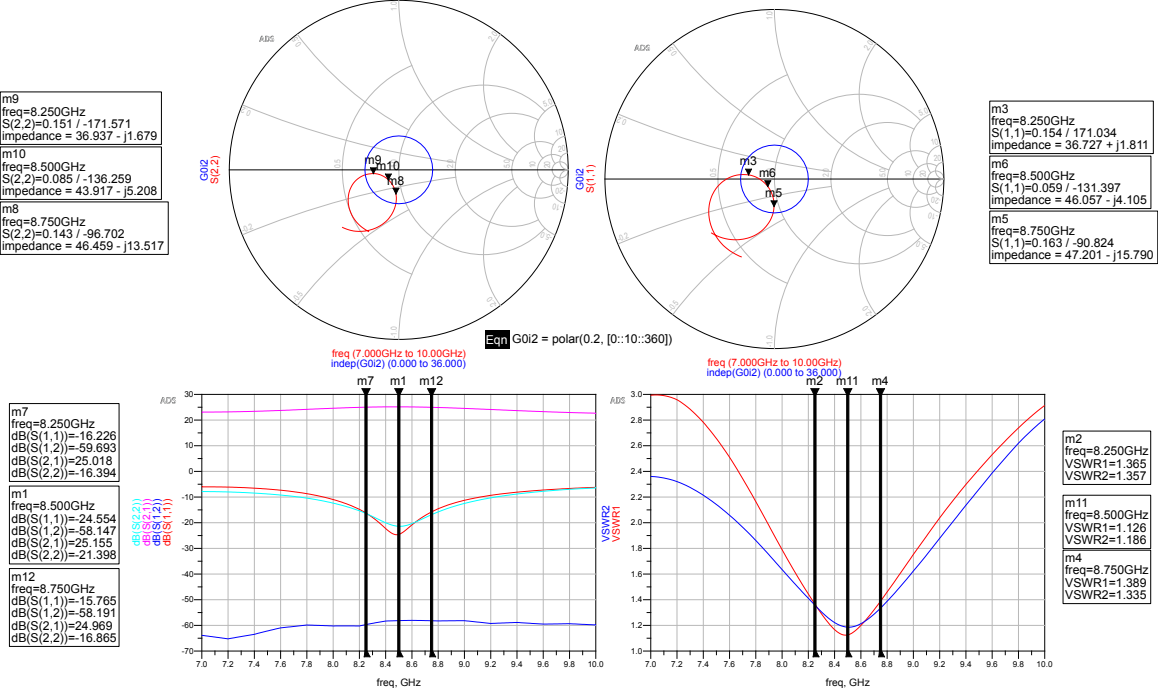
[picture p85: page 1]
freq, GHz; m1 freq= dB(S(1,1))=-24.554 dB(S(1,2))=-58.147 dB(S(2,1))=25.155 dB(S(2,2))=-21.398; 8.500GHz; m7 freq= dB(S(1,1))=-16.226 dB(S(1,2))=-59.693 dB(S(2,1))=25.018 dB(S(2,2))=-16.394; 8.250GHz; m12 freq= dB(S(1,1))=-15.765 dB(S(1,2))=-58.191 dB(S(2,1))=24.969 dB(S(2,2))=-16.865; 8.750GHz; freq (7.000GHz to 10.00GHz); indep(G0i2) (0.000 to 36.000); m3 freq= S(1,1)=0.154 / 171.034 impedance = 36.727 + j1.811; m5 freq= S(1,1)=0.163 / -90.824 impedance = 47.201 - j15.790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
