lazbaphilipp/ADS_HW/images/parts_design/LNA_Response_Z.pdf

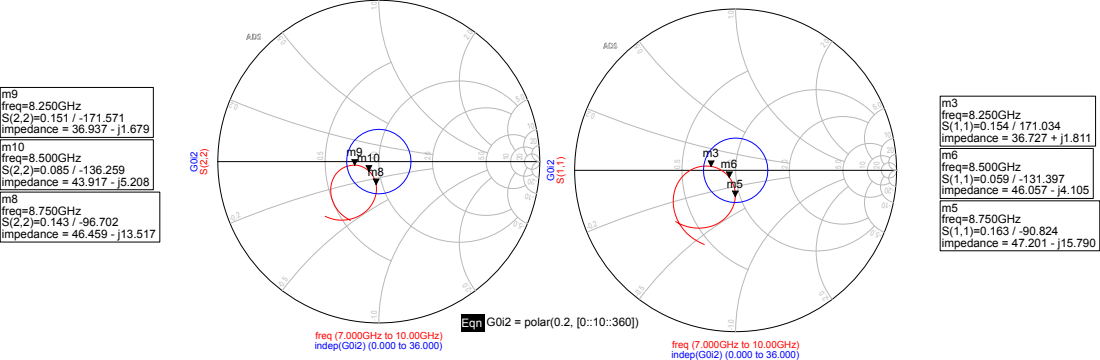
[picture p86: page 1]
freq (7.000GHz to 10.00GHz); indep(G0i2) (0.000 to 36.000); m8 freq= S(2,2)=0.143 / -96.702 impedance = 46.459 - j13.517; 8.750GHz; m9 freq= S(2,2)=0.151 / -171.571 impedance = 36.937 - j1.679; 8.250GHz; m10 freq= S(2,2)=0.085 / -136.259 impedance = 43.917 - j5.208; 8.500GHz; m3 freq= S(1,1)=0.154 / 171.034 impedance = 36.727 + j1.811; m5 freq= S(1,1)=0.163 / -90.824 impedance = 47.201 - j15.790; m6 freq= S(1,1)=0.059 / -131.397 impedance = 46.057 - j4.105; Eqn; G0i2 = polar(0.2, [0::10::360])
