lazbaphilipp/ADS_HW/images/parts_design/LNA_VSWR.pdf

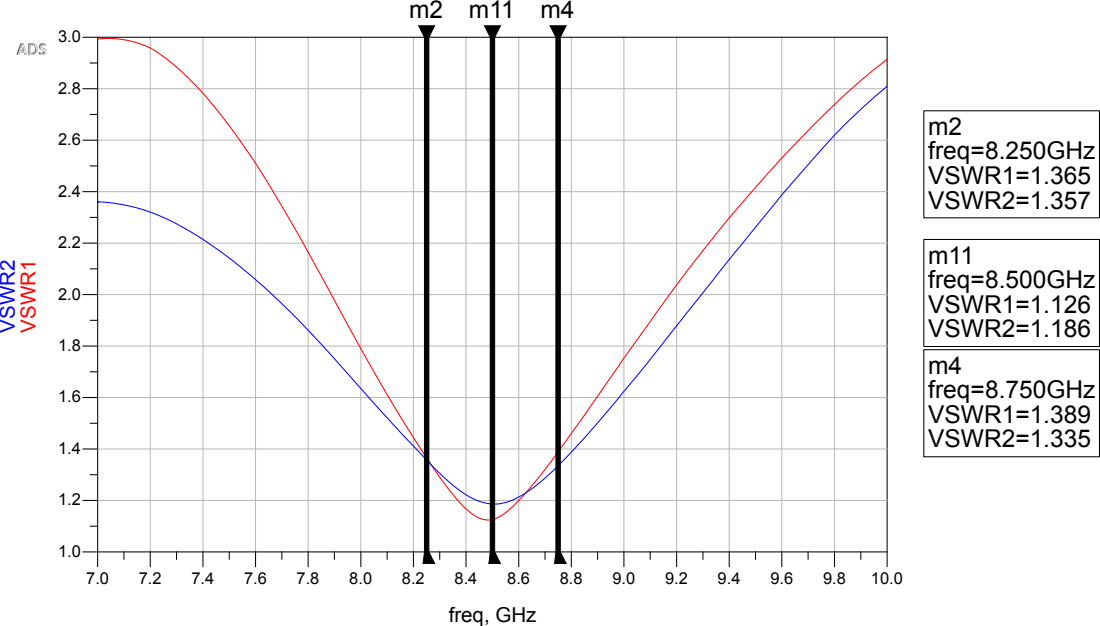
[picture p87: page 1]
freq, GHz; VSWR2; VSWR1; m11 freq= VSWR1=1.126 VSWR2=1.186; 8.500GHz; m2 freq= VSWR1=1.365 VSWR2=1.357; 8.250GHz; m4 freq= VSWR1=1.389 VSWR2=1.335; 8.750GHz
