lazbaphilipp/ADS_HW/images/parts_design/LTC_Response.pdf

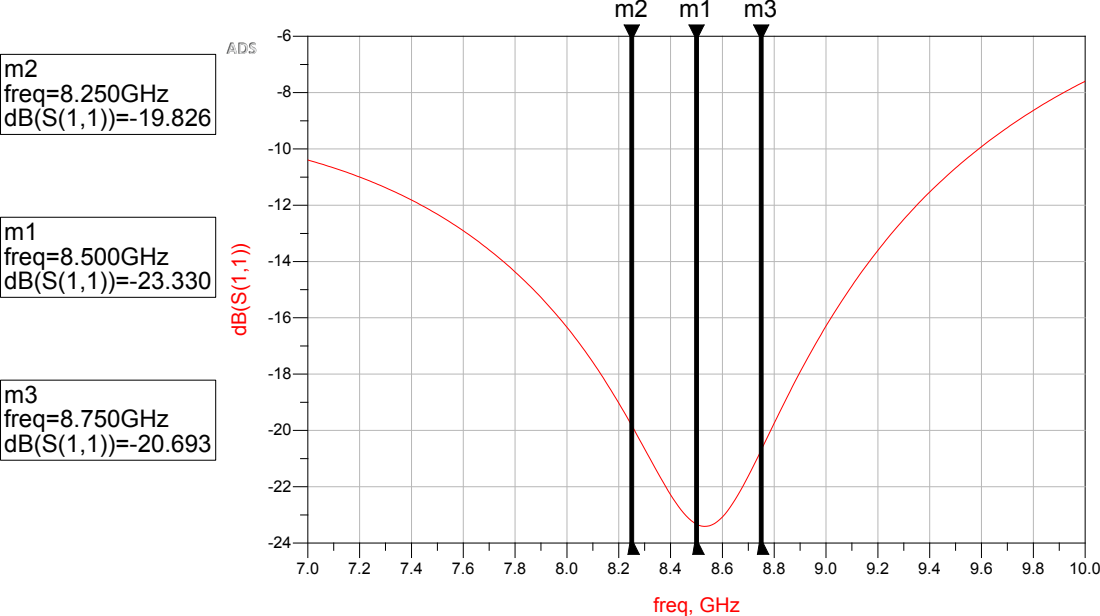
[picture p88: page 1]
freq, GHz; m1 freq= dB(S(1,1))=-23.330; 8.500GHz; m2 freq= dB(S(1,1))=-19.826; 8.250GHz; m3 freq= dB(S(1,1))=-20.693; 8.750GHz
