lazbaphilipp/ADS_HW/images/parts_design/LTC_VSWR.pdf

## m8 m7 m9

m8

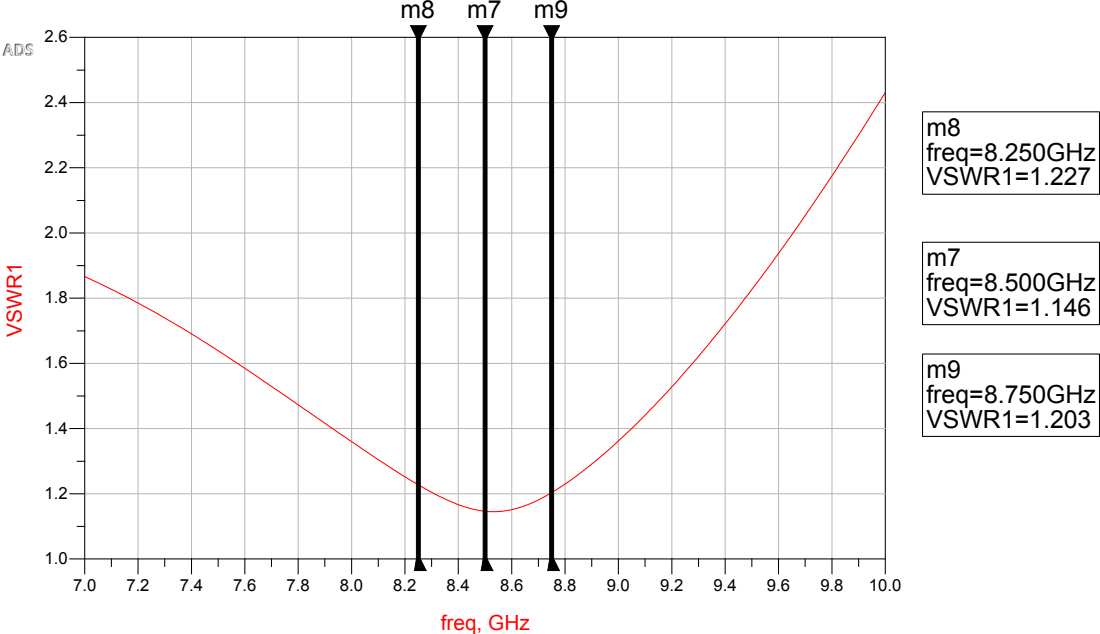
[picture p89: page 1]
freq, GHz; VSWR1; m7 freq= VSWR1=1.146; 8.500GHz; freq= VSWR1=1.227; 8.250GHz; m9 freq= VSWR1=1.203; 8.750GHz
