lazbaphilipp/ADS_HW/images/Altium-PCB/2LayerAll.pdf

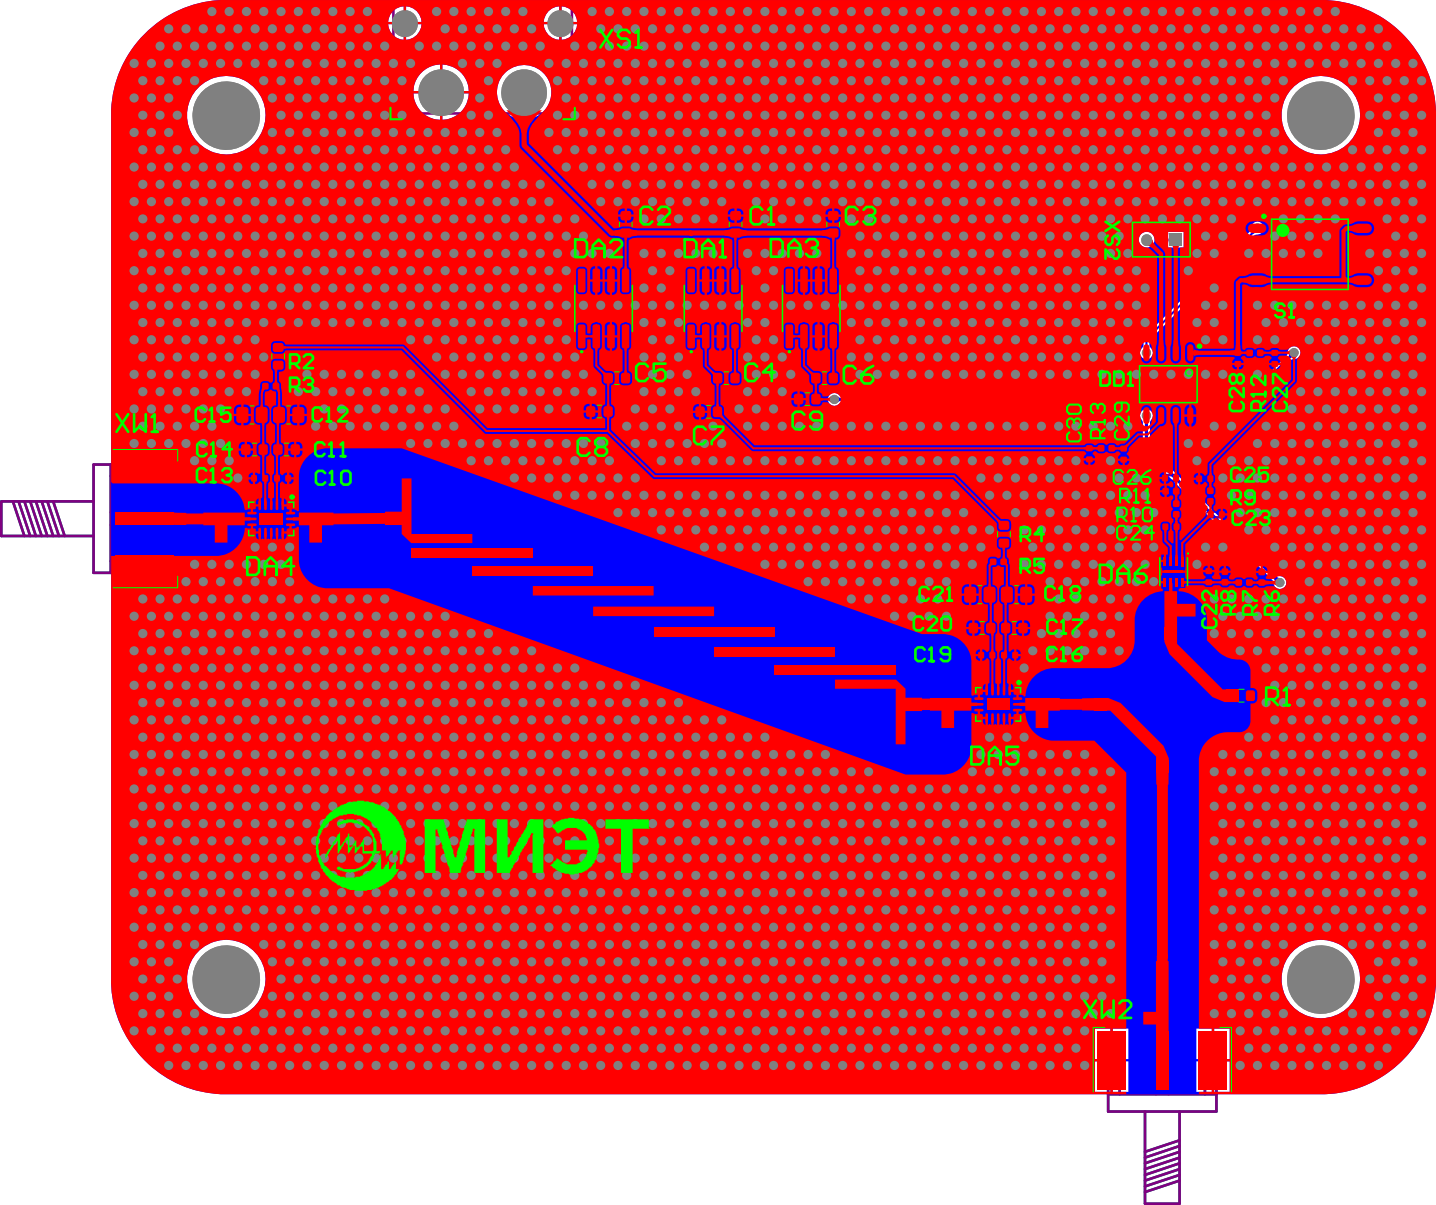
[picture p90: page 1]
