lazbaphilipp/ADS_HW/images/Altium-PCB/2LayerBL.pdf

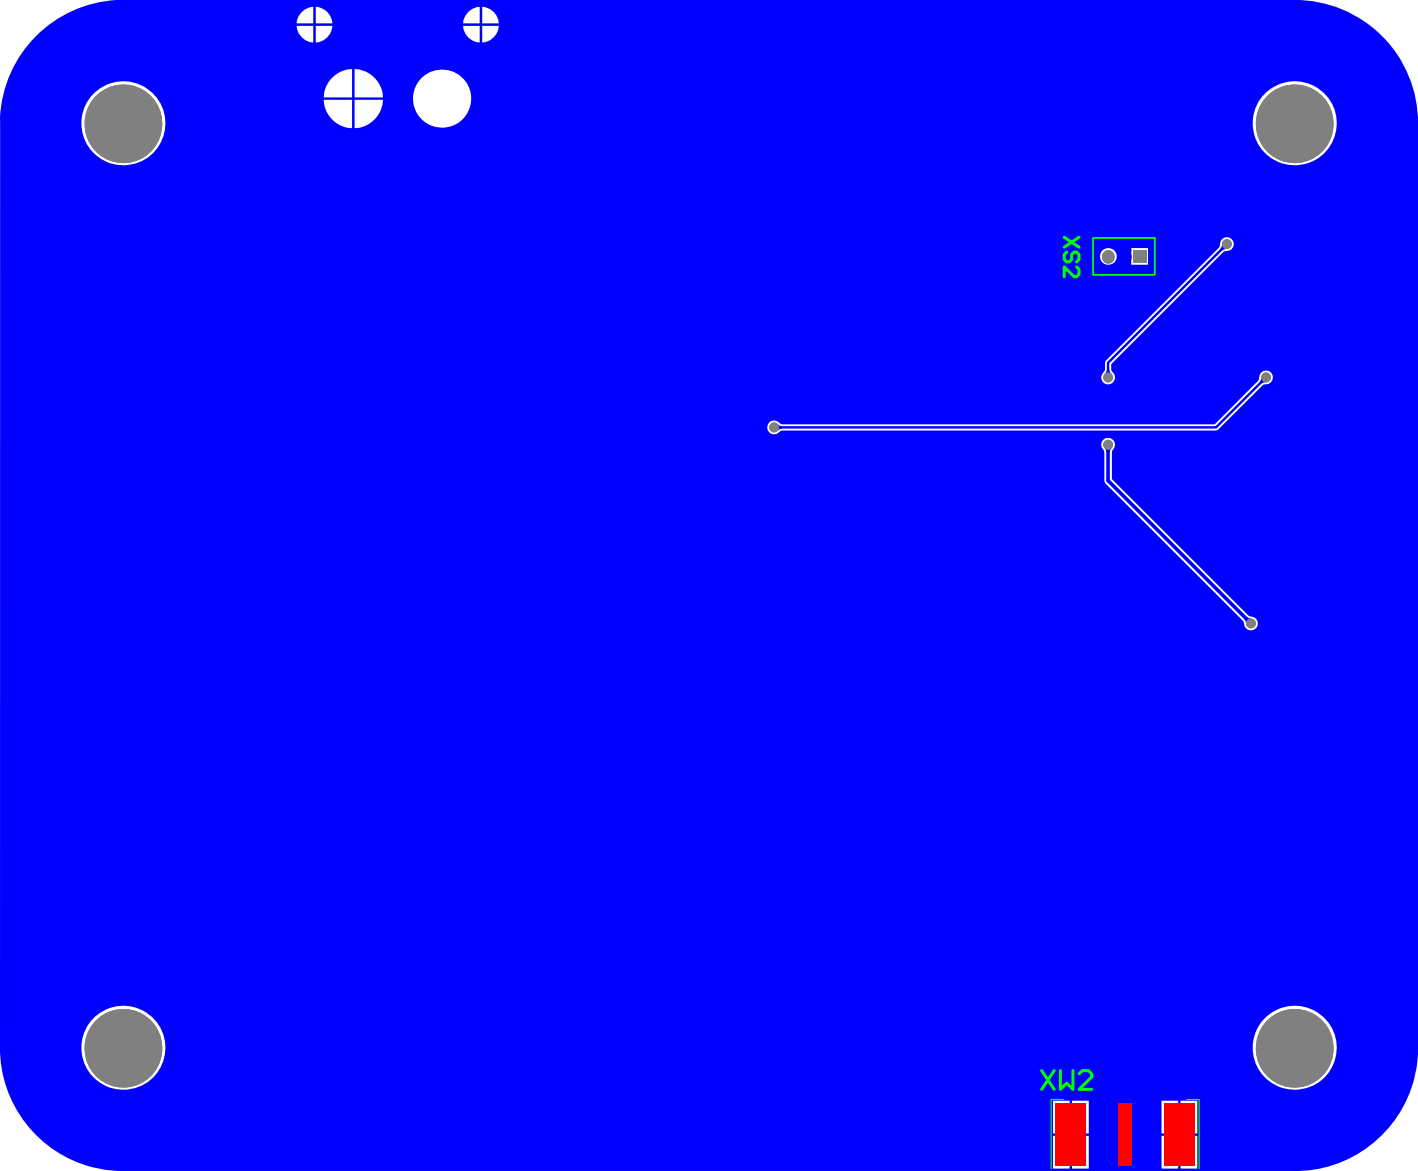
[picture p91: page 1]
