lazbaphilipp/ADS_HW/images/Altium-PCB/2LayerTL.pdf

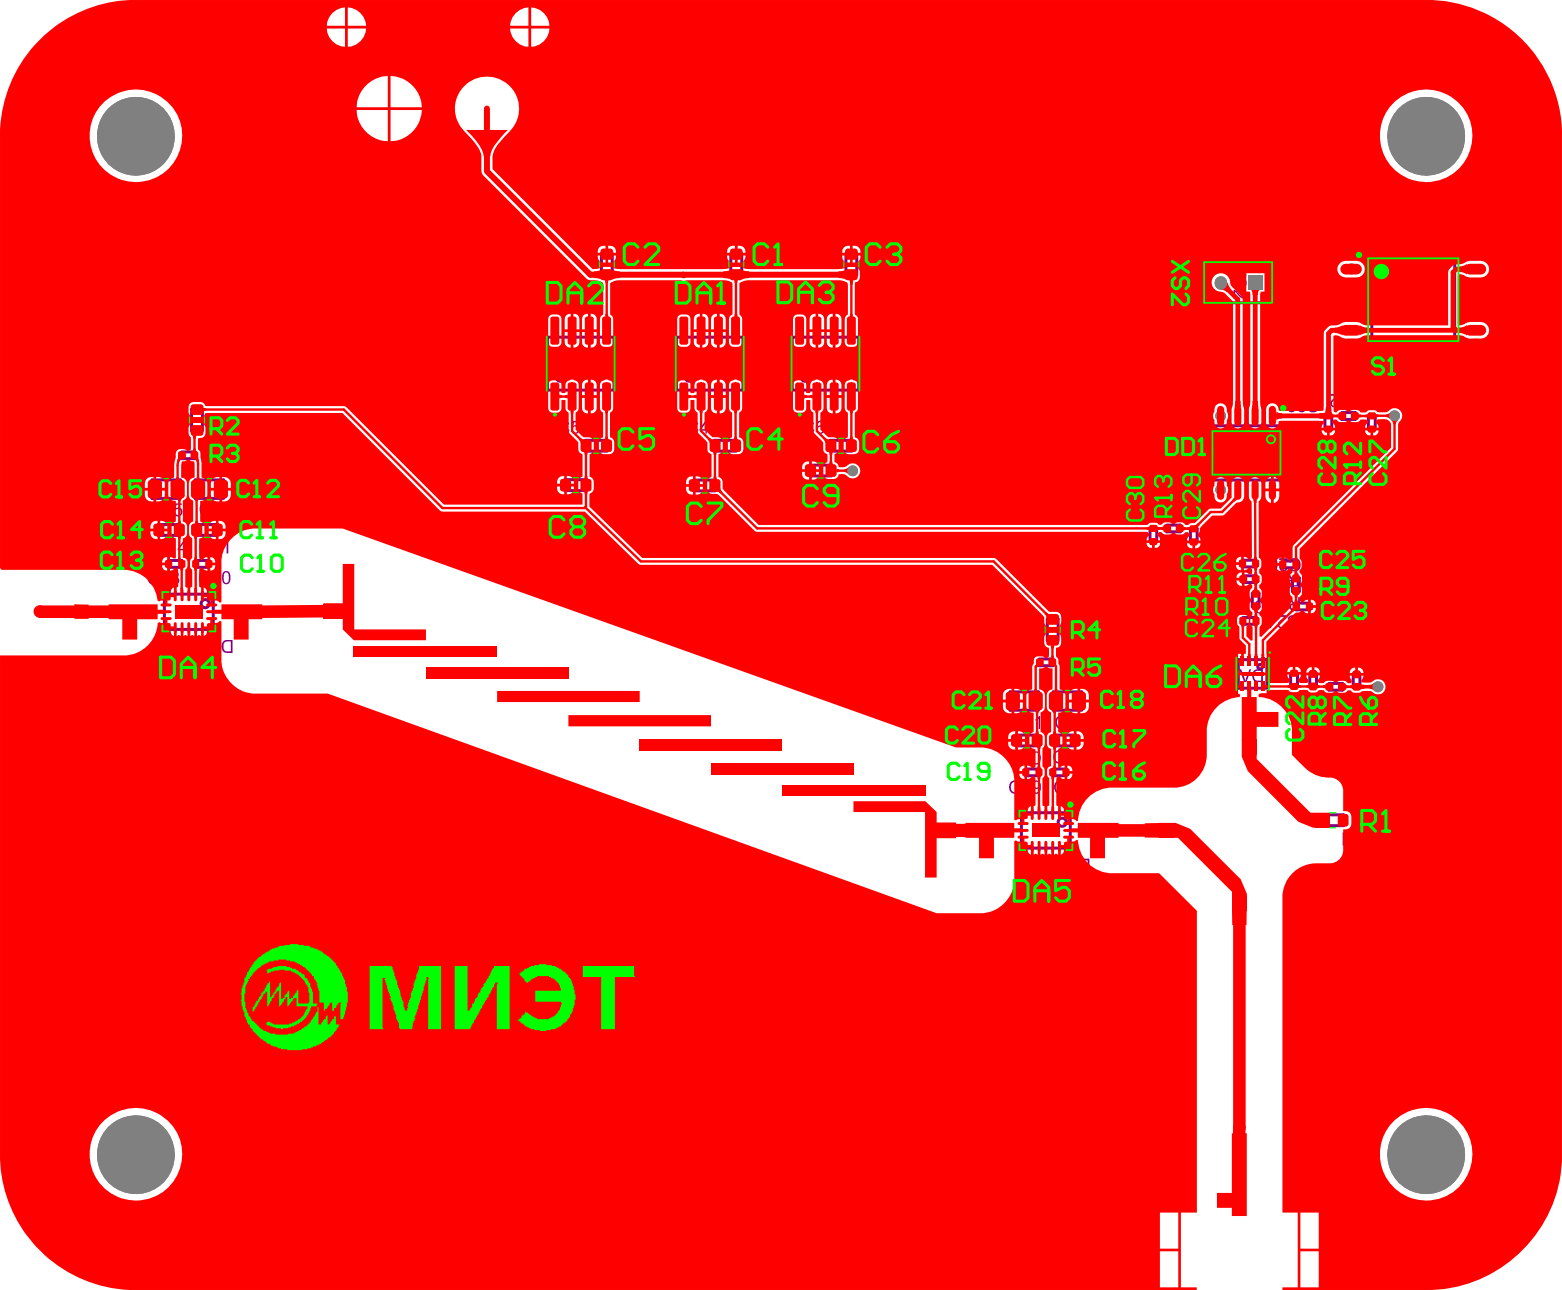
[picture p92: page 1]
