lazbaphilipp/ADS_HW/images/Altium-PCB/4LayerAll.pdf

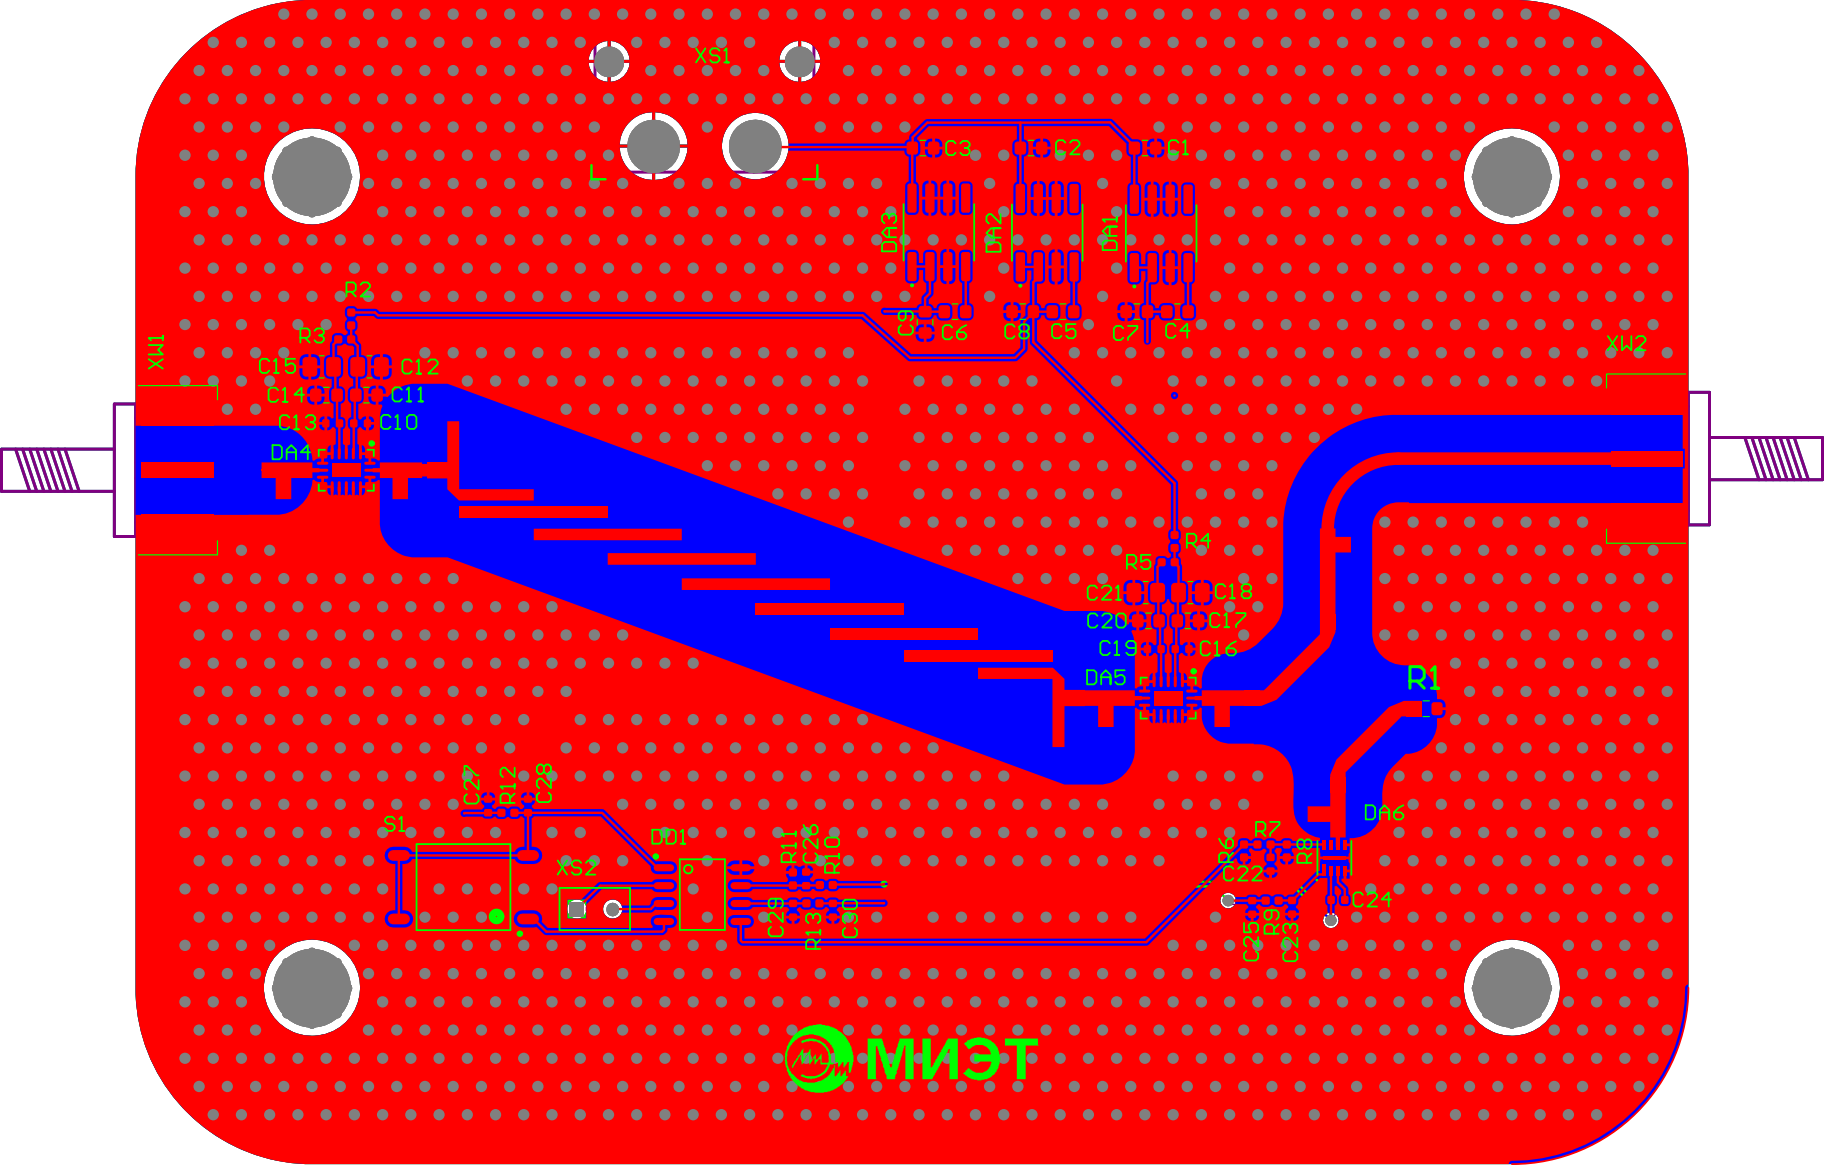
[picture p93: page 1]
