lazbaphilipp/ADS_HW/images/Altium-PCB/4LayerBL.pdf

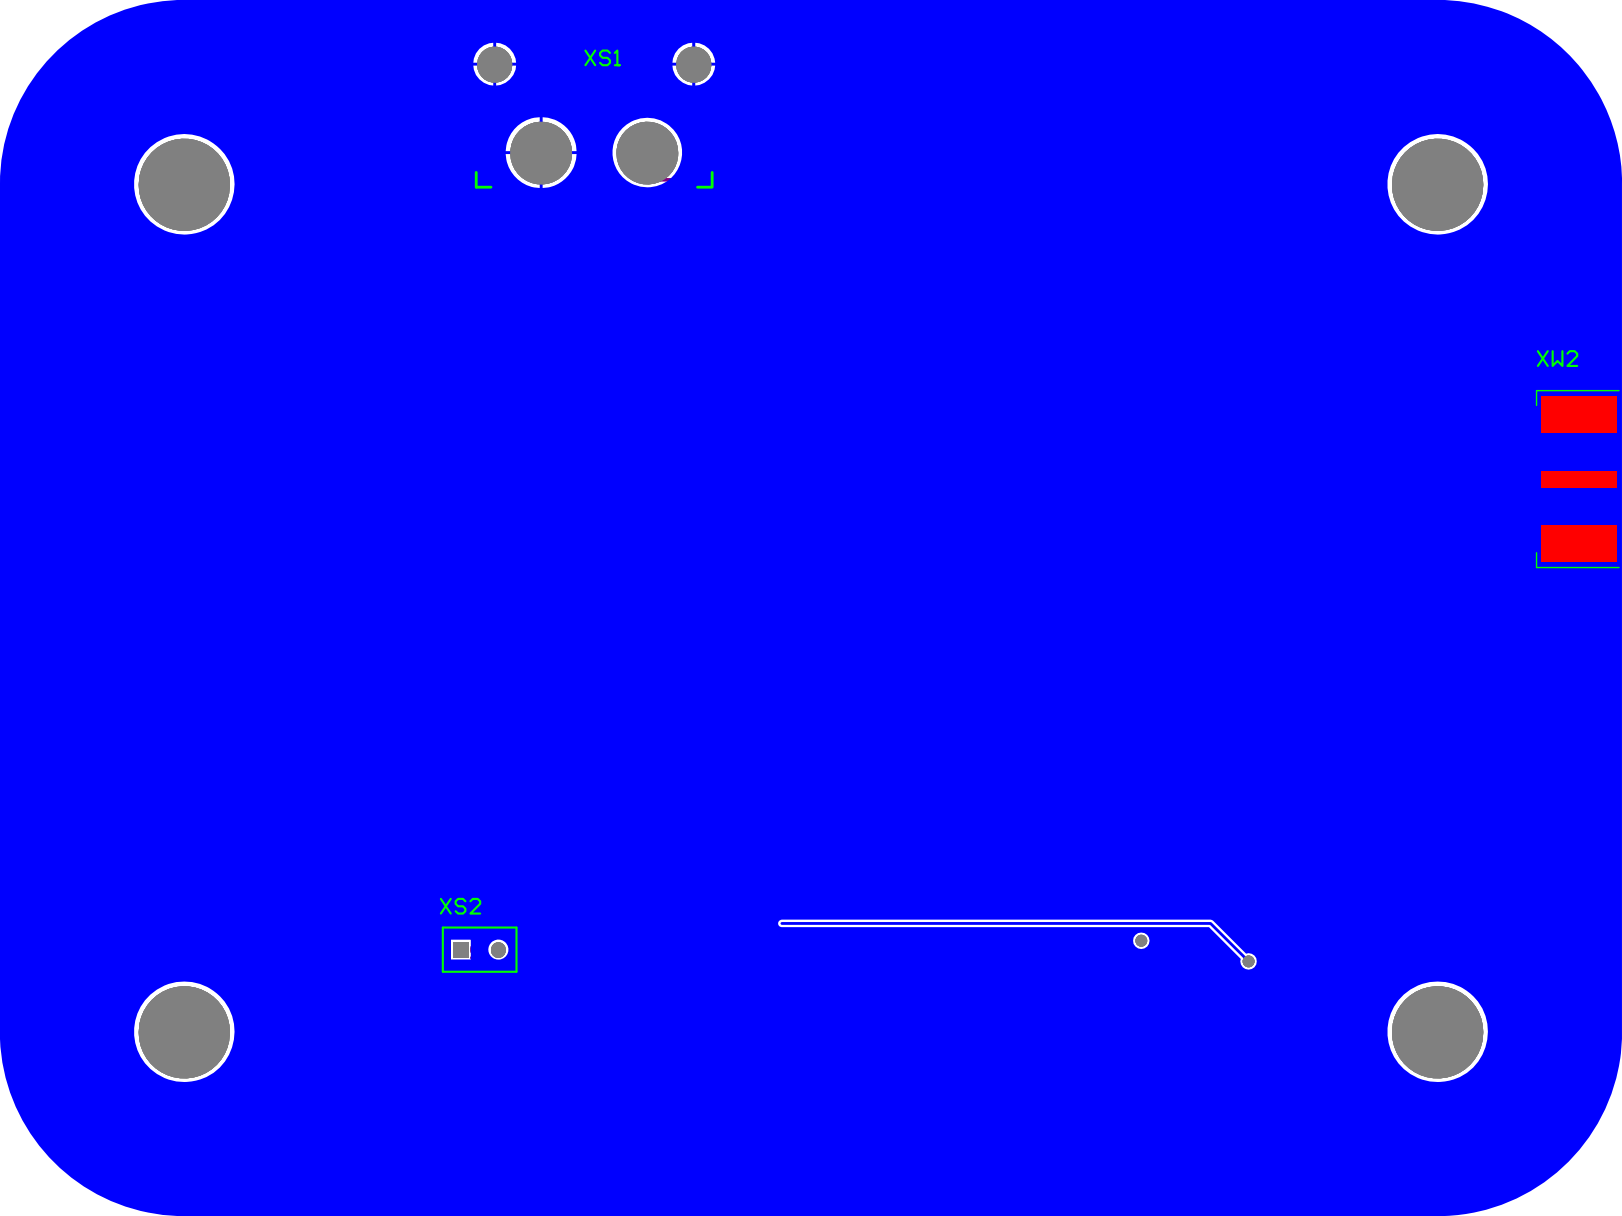
[picture p94: page 1]
