lazbaphilipp/ADS_HW/images/Altium-PCB/4LayerRF.pdf

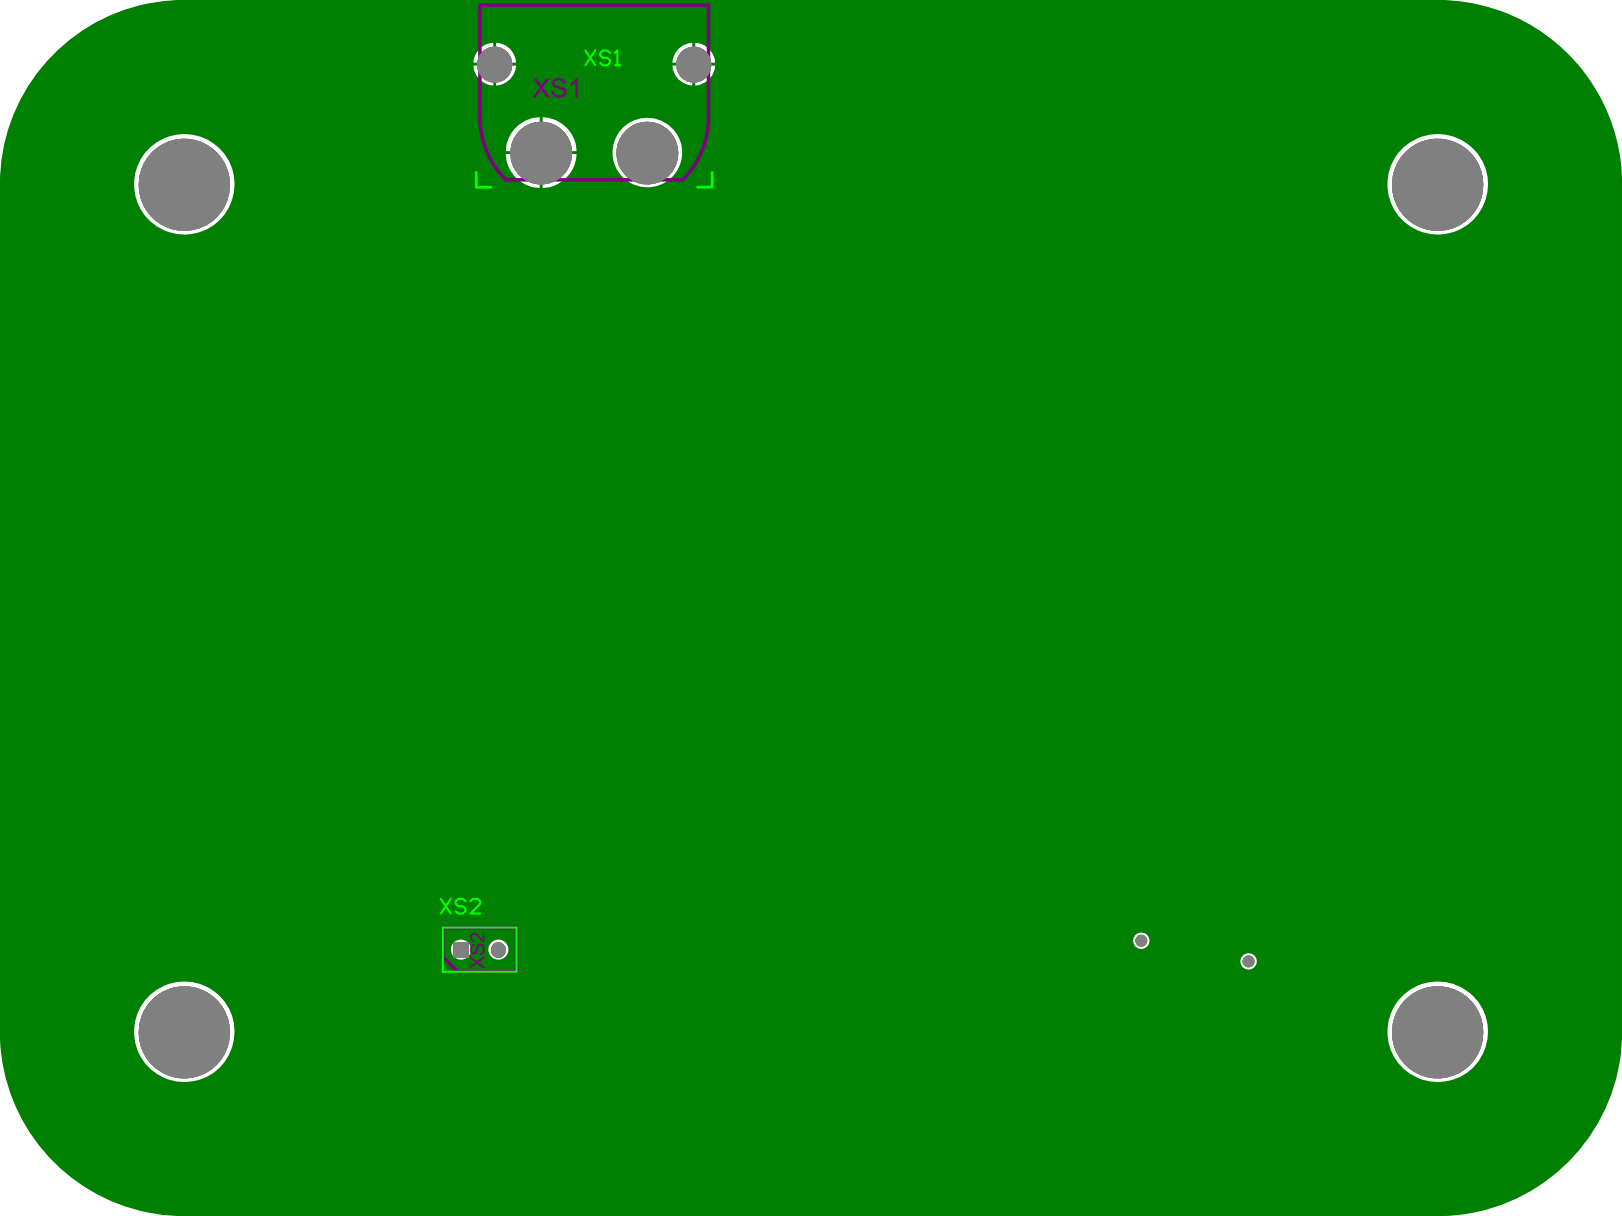
[picture p95: page 1]
