lazbaphilipp/ADS_HW/images/Altium-PCB/4LayerTL.pdf

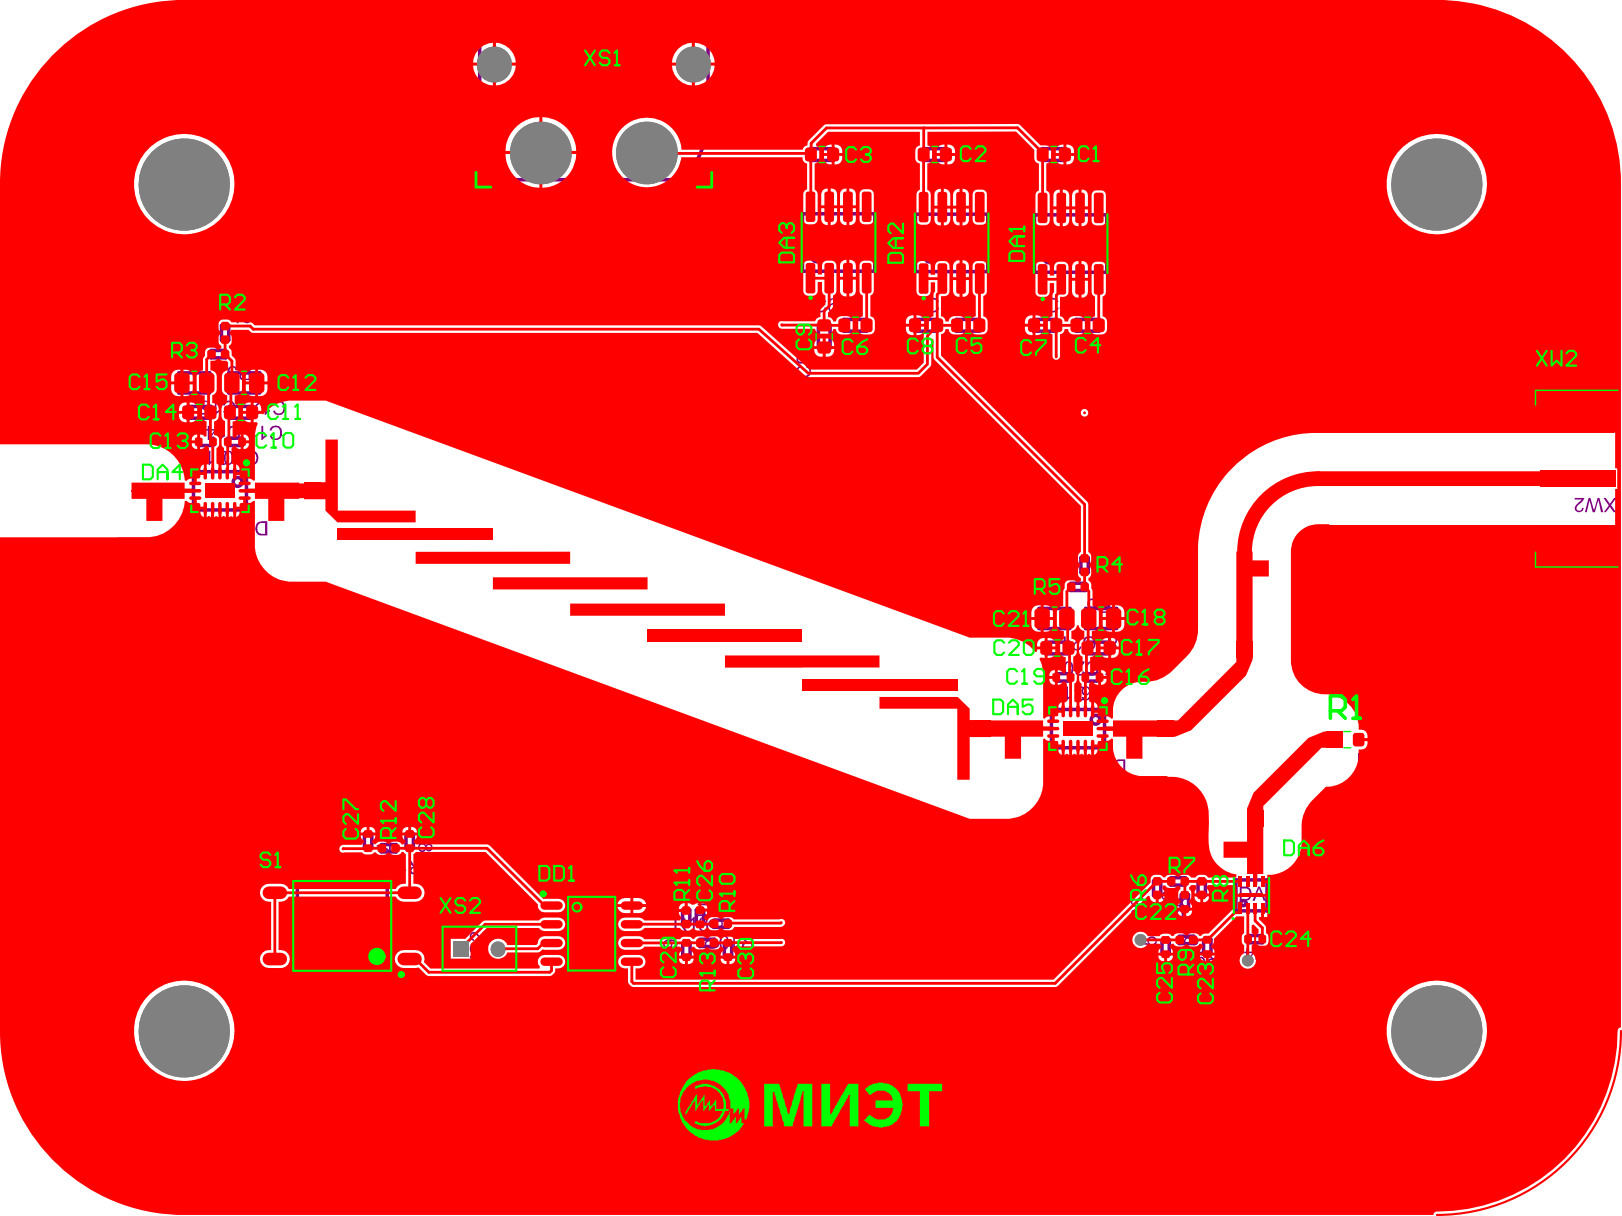
[picture p96: page 1]
