lazbaphilipp/ADS_HW/images/Documentation/MPSU.30117.21-005R.pdf

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

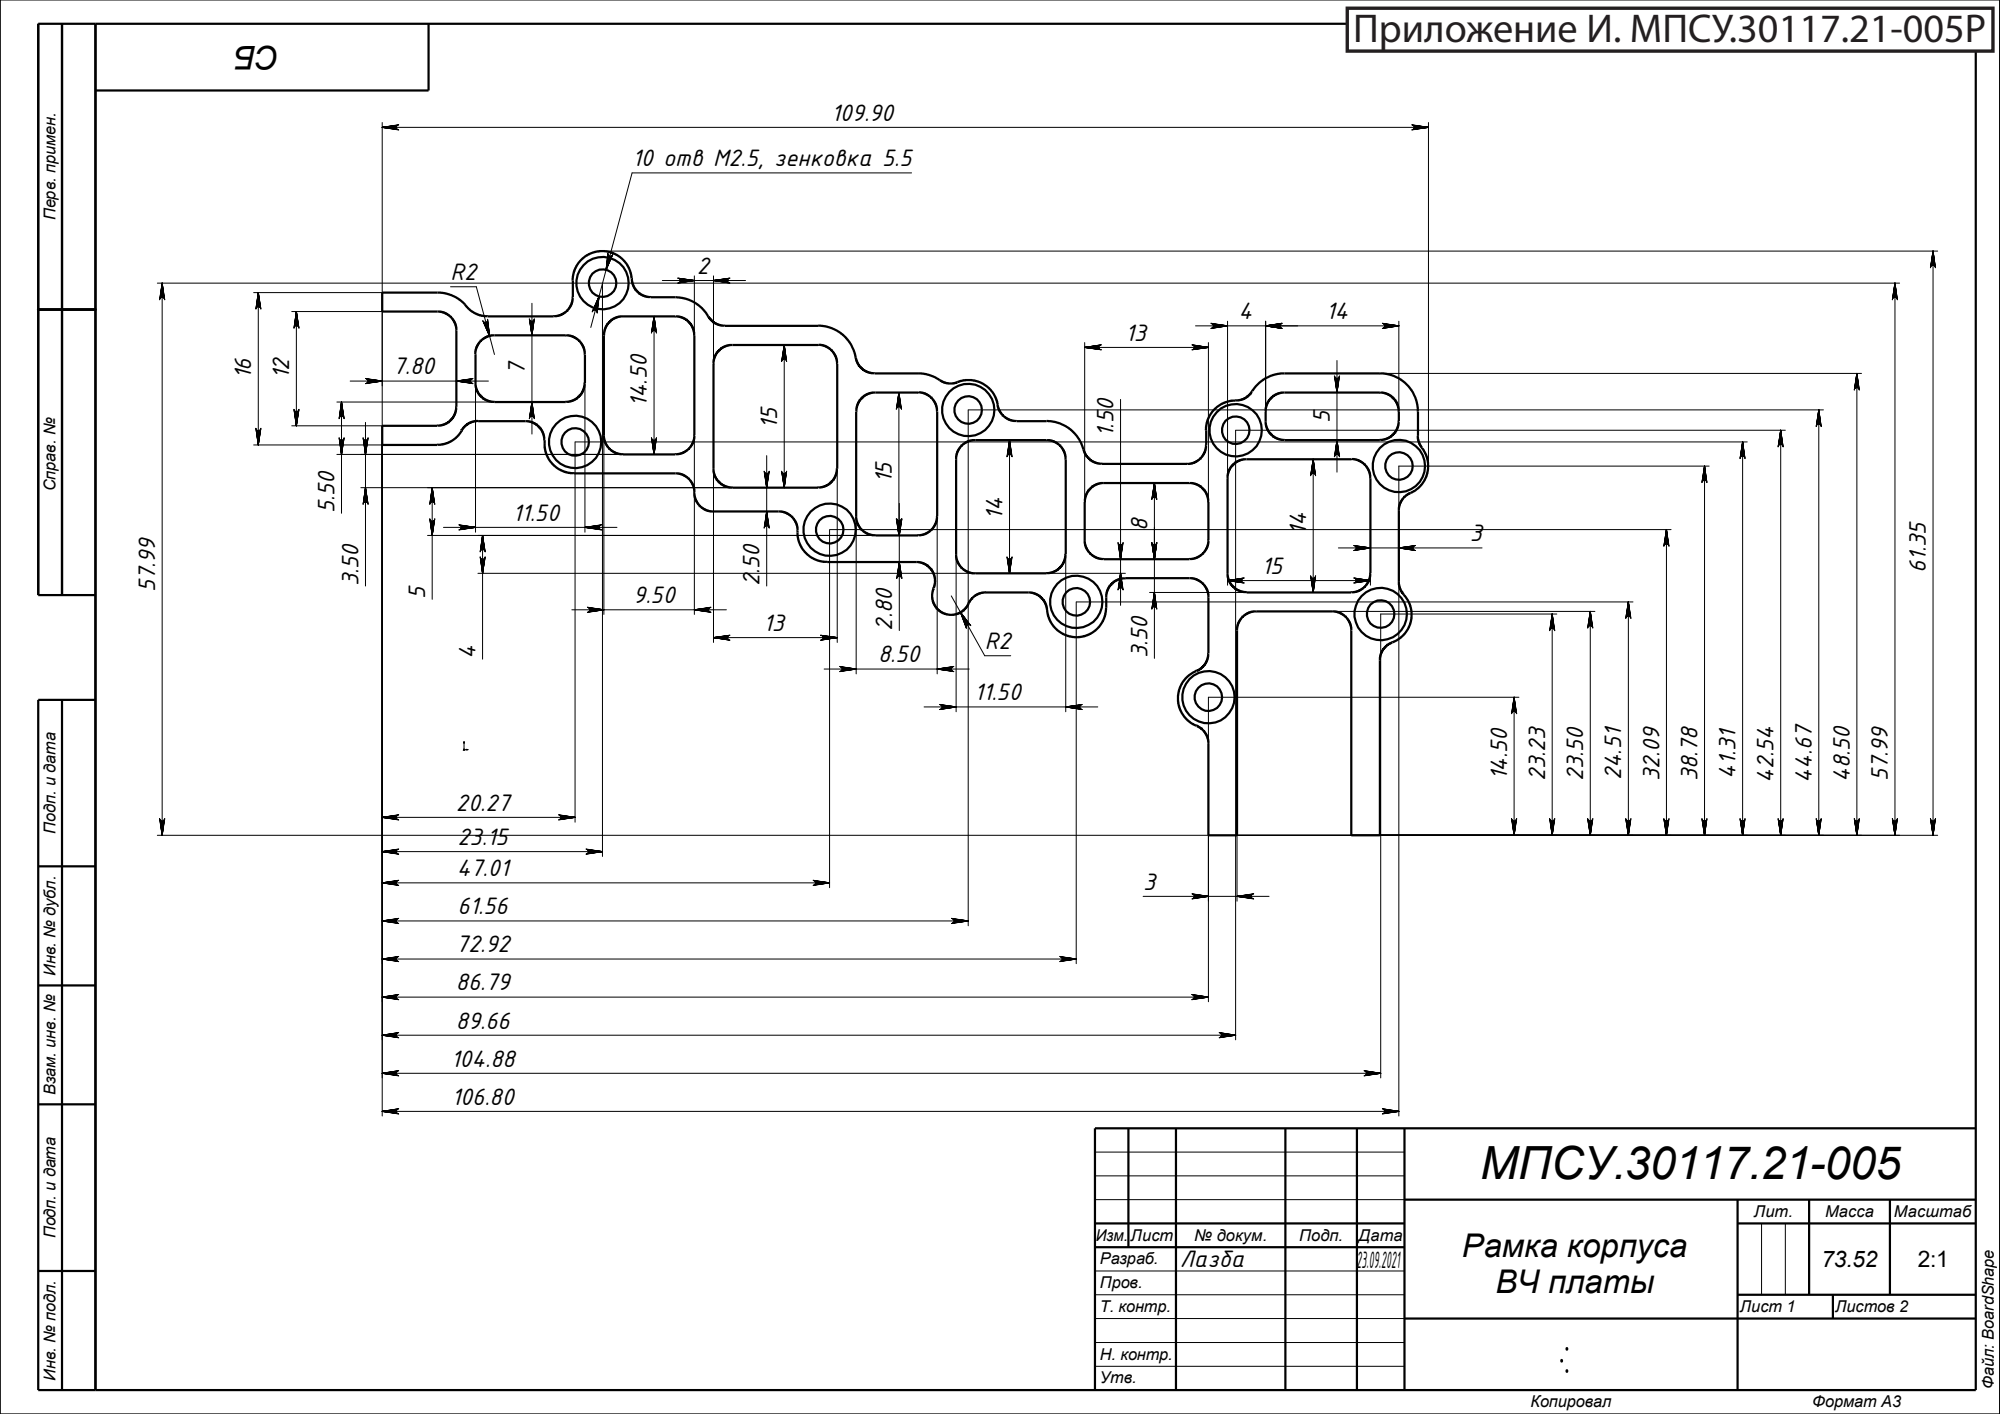
[picture p97: page 1]

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

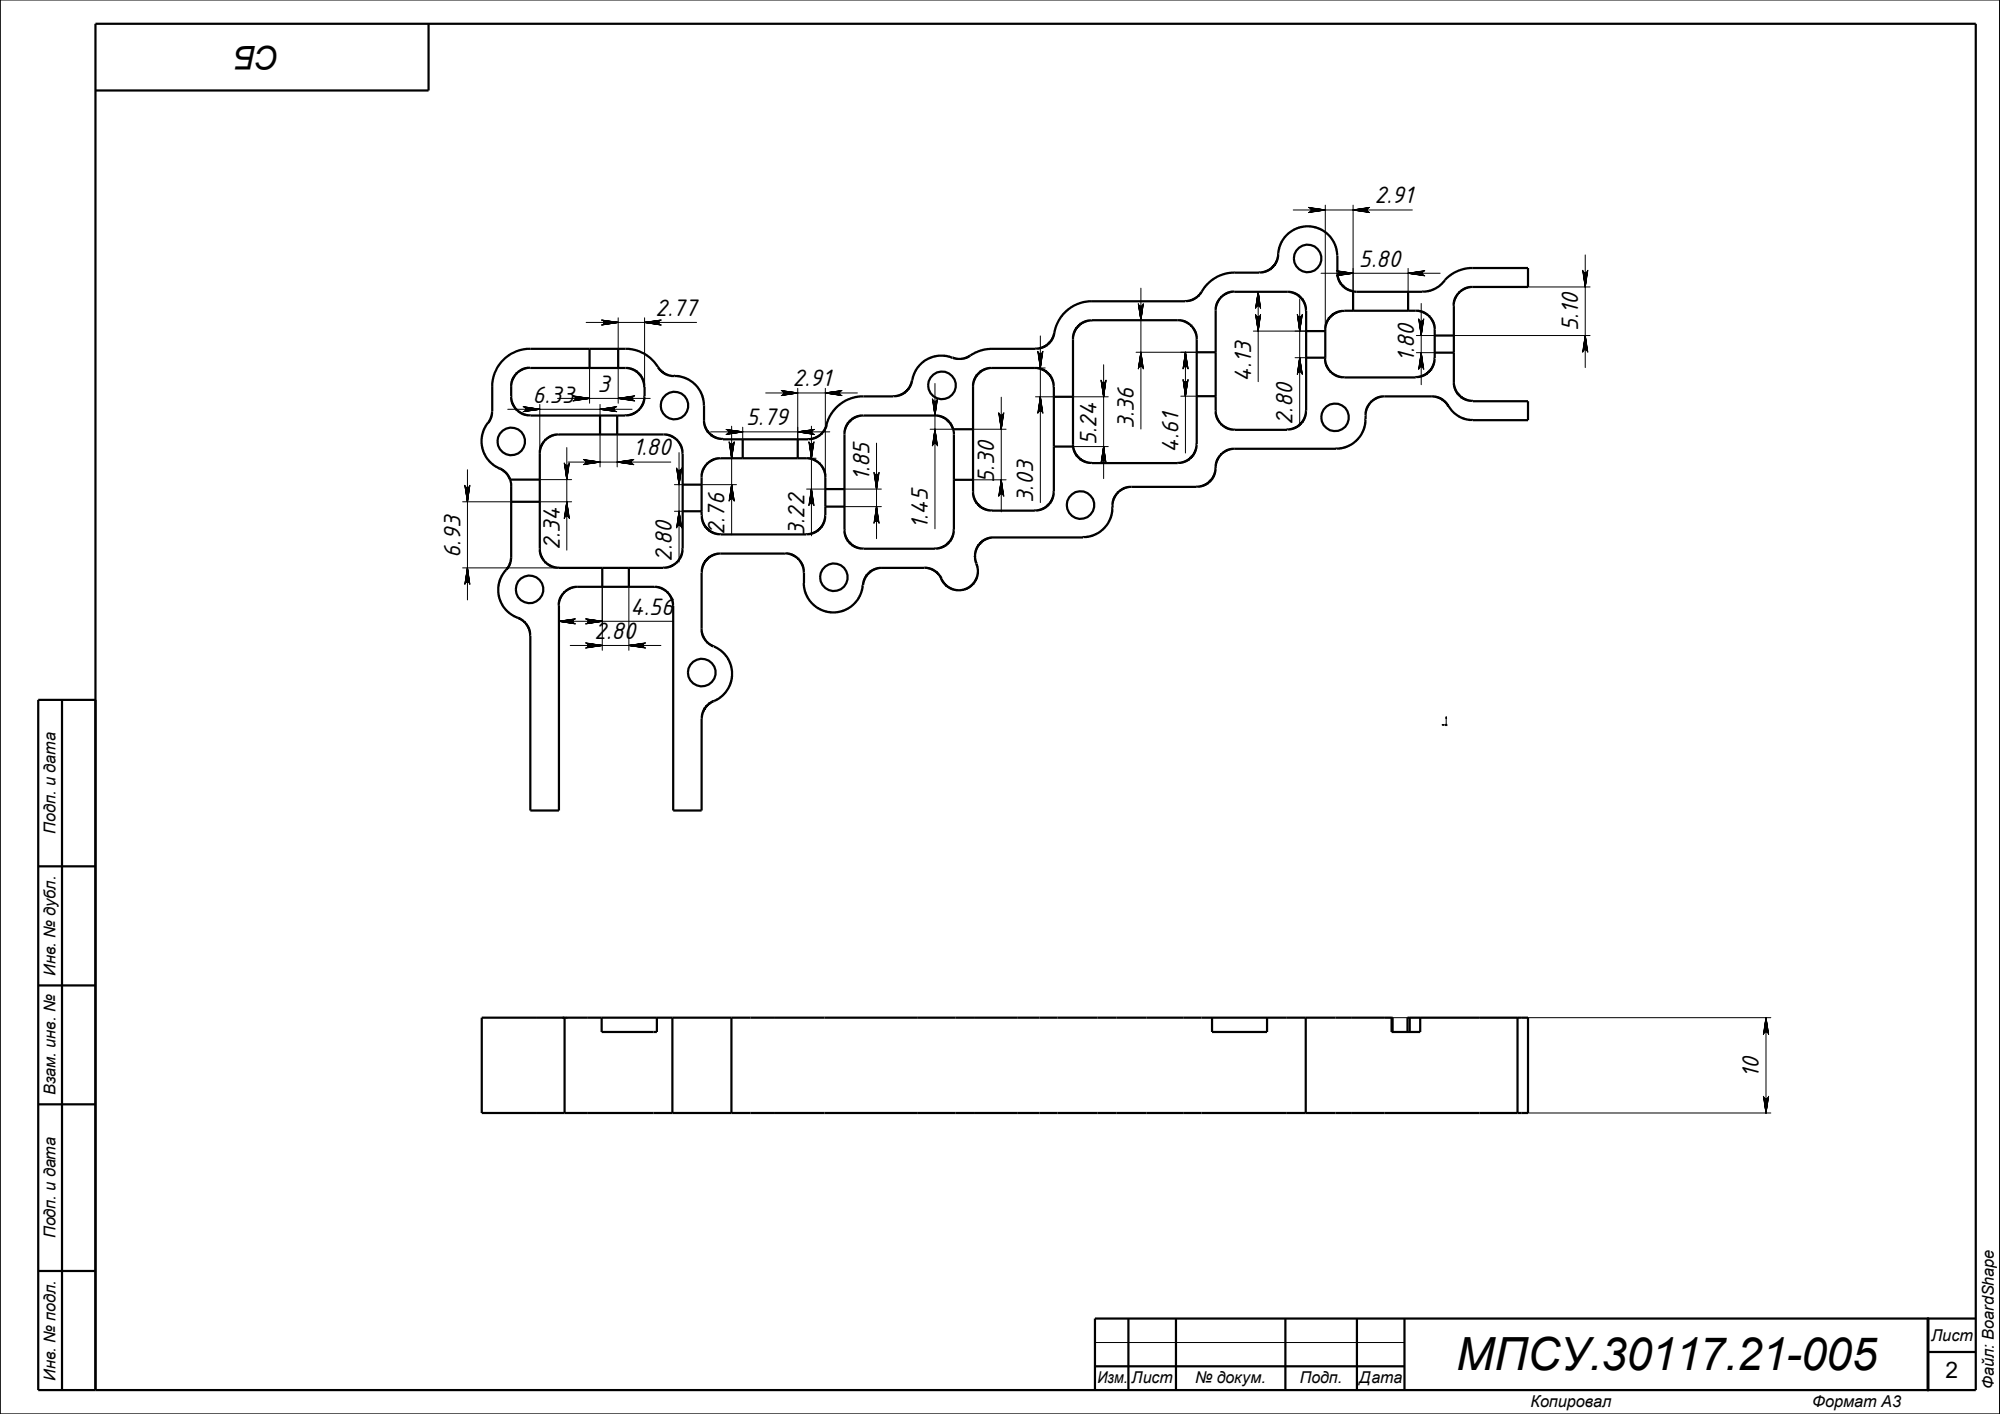
[picture p98: page 2]
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
