lazbaphilipp/ADS_HW/images/Documentation/MPSU.464342.21-005E3.pdf

# Приложение Г. МПСУ.464342.21-005ЭЗ

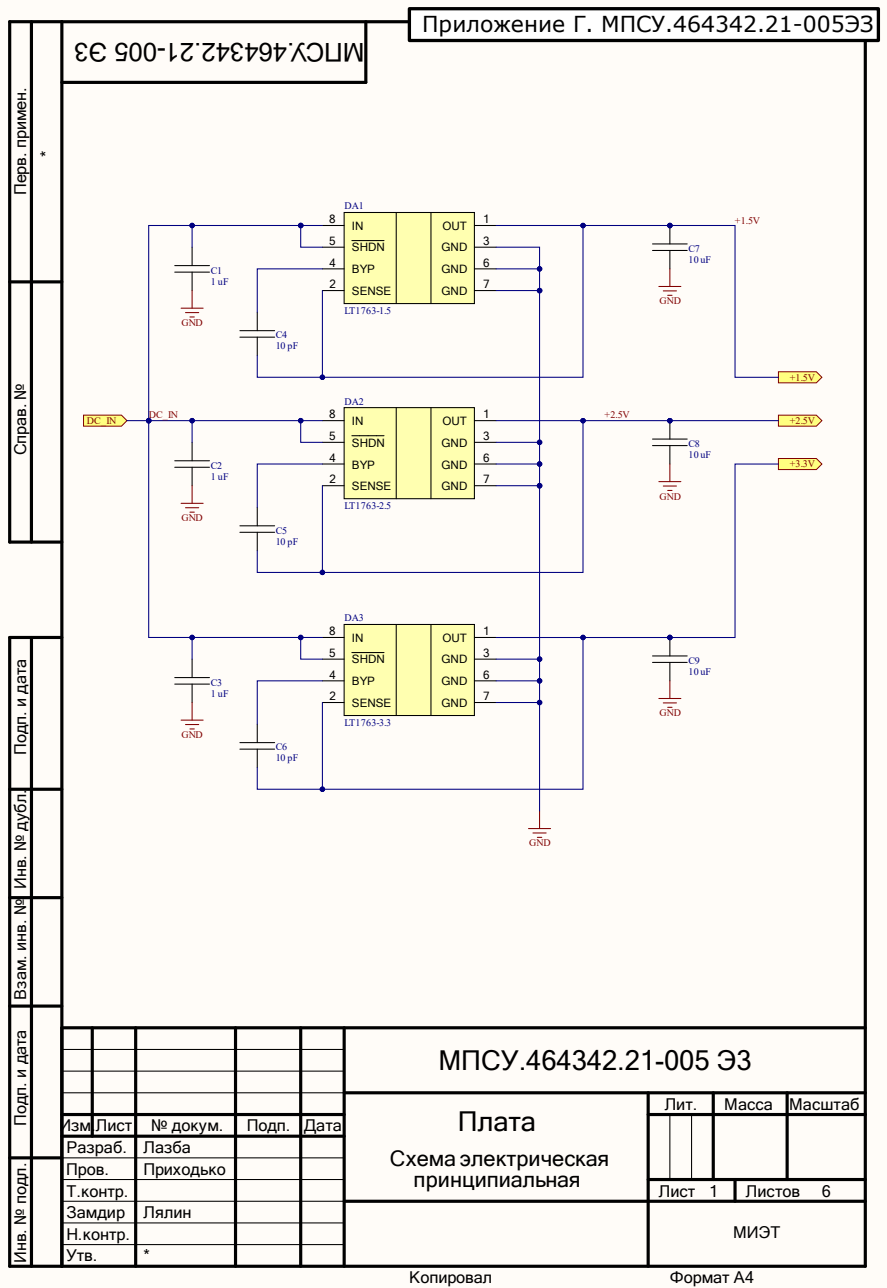
[picture p99: page 1]

Инв. № подл. Инв. № дубл. Подп. и дата Взам. инв. № Подп. и дата Перв. примен. Справ. №

МПСУ.464342.21-005 Э3

Плата Схема электрическая принципиальная | Лит. | Масса | Масштаб

Изм. | Лист | № докум. | Подп. | Дата
Разраб. | | Лазба
. | ПриходькоПров
Т.контр. | | | | | Лист 1 | Листов 6
Замдир | Лялин | | | | МИЭТ
Н.контр.
Утв. | *
