lazbaphilipp/ADS_HW/images/system_modeling/SystemResponse.pdf

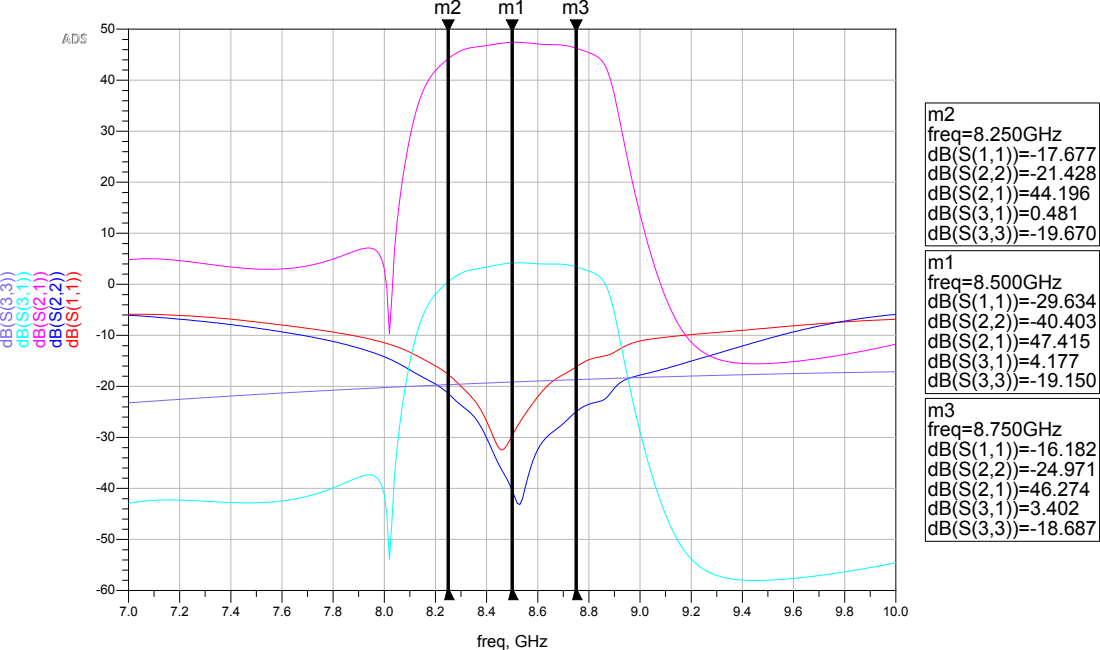
[picture p100: page 1]
freq, GHz; m1 freq= dB(S(1,1))=-29.634 dB(S(2,2))=-40.403 dB(S(2,1))=47.415 dB(S(3,1))=4.177 dB(S(3,3))=-19.150; 8.500GHz; m2 freq= dB(S(1,1))=-17.677 dB(S(2,2))=-21.428 dB(S(2,1))=44.196 dB(S(3,1))=0.481 dB(S(3,3))=-19.670; 8.250GHz; m3 freq= dB(S(1,1))=-16.182 dB(S(2,2))=-24.971 dB(S(2,1))=46.274 dB(S(3,1))=3.402 dB(S(3,3))=-18.687; 8.750GHz
