lazbaphilipp/ADS_HW/(list of files, drawings)

Other design files:
Project/Altium_Project/MIET_PCBD_Project/MIET_PCBD_Project.PrjPcb
Project/Altium_Project/MIET_PCBD_Project/МПСУ.464342.21-005T5M.PcbDoc
Project/Altium_Project/MIET_PCBD_Project/МПСУ.464342.21-005Э3 Лист1.SchDoc
Project/Altium_Project/MIET_PCBD_Project/МПСУ.464342.21-005Э3 Лист2.SchDoc
Project/Altium_Project/MIET_PCBD_Project/МПСУ.464342.21-005Э3 Лист3.SchDoc
Project/Altium_Project/MIET_PCBD_Project/МПСУ.464342.21-005Э3 Лист4.SchDoc
Project/Altium_Project/MIET_PCBD_Project/МПСУ.464342.21-005Э3 Лист5.SchDoc
Project/Altium_Project/StudentsLibraryGIT/Amplifiers.SchLib
Project/Altium_Project/StudentsLibraryGIT/Antennas.PcbLib
Project/Altium_Project/StudentsLibraryGIT/Antennas.SchLib
Project/Altium_Project/StudentsLibraryGIT/Attenuators.SchLib
Project/Altium_Project/StudentsLibraryGIT/BaseLibrary.SchLib
Project/Altium_Project/StudentsLibraryGIT/BGA.PcbLib
Project/Altium_Project/StudentsLibraryGIT/CapacitorAluminumElectrolytic.PcbLib
Project/Altium_Project/StudentsLibraryGIT/Chips.PcbLib
Project/Altium_Project/StudentsLibraryGIT/Circulators.PcbLib
Project/Altium_Project/StudentsLibraryGIT/Connectors.PcbLib
Project/Altium_Project/StudentsLibraryGIT/Connectors.SchLib
Project/Altium_Project/StudentsLibraryGIT/Diode.SchLib
Project/Altium_Project/StudentsLibraryGIT/Discrete.SchLib
Project/Altium_Project/StudentsLibraryGIT/Discrete_bad.SchLib
Project/Altium_Project/StudentsLibraryGIT/Disctrete.SchLib
Project/Altium_Project/StudentsLibraryGIT/DPAK.PcbLib
Project/Altium_Project/StudentsLibraryGIT/Filters.SchLib
Project/Altium_Project/StudentsLibraryGIT/FrequencyConvectors.SchLib
Project/Altium_Project/StudentsLibraryGIT/Graphical.PcbLib
Project/Altium_Project/StudentsLibraryGIT/Graphical.SchLib
Project/Altium_Project/StudentsLibraryGIT/IC.SchLib
Project/Altium_Project/StudentsLibraryGIT/Limiters.SchLib
Project/Altium_Project/StudentsLibraryGIT/Microstrip.PcbLib
Project/Altium_Project/StudentsLibraryGIT/Microstrip.SchLib
Project/Altium_Project/StudentsLibraryGIT/MiniCircuits.PcbLib
Project/Altium_Project/StudentsLibraryGIT/Mixers.SchLib
Project/Altium_Project/StudentsLibraryGIT/MountingHoles.PcbLib
Project/Altium_Project/StudentsLibraryGIT/MountingHoles.SchLib
Project/Altium_Project/StudentsLibraryGIT/Oscillators.SchLib
Project/Altium_Project/StudentsLibraryGIT/PhaseDetectors.SchLib
Project/Altium_Project/StudentsLibraryGIT/PhaseShifters.SchLib
Project/Altium_Project/StudentsLibraryGIT/PLL.SchLib
Project/Altium_Project/StudentsLibraryGIT/PowerDetectors.SchLib
Project/Altium_Project/StudentsLibraryGIT/PowerMangment.SchLib
Project/Altium_Project/StudentsLibraryGIT/QFP.PcbLib
Project/Altium_Project/StudentsLibraryGIT/RFPowerTransistors.SchLib
Project/Altium_Project/StudentsLibraryGIT/SOIC.PcbLib
Project/Altium_Project/StudentsLibraryGIT/SON.PcbLib
Project/Altium_Project/StudentsLibraryGIT/SOT.PcbLib
Project/Altium_Project/StudentsLibraryGIT/SWITCHES.SchLib
Project/Altium_Project/StudentsLibraryGIT/Transceiver.SchLib
Project/Altium_Project/StudentsLibraryGIT/WireBondChips.PcbLib
Project/Altium_Project/StudentsLibraryGIT/WireBondChips.SchLib
Project/Altium_Project/StudentsLibraryGIT/МПСУ.464342.21-005 Э3 Лист1.SchDoc
